Maritime-Robotics-Student-Society/sailing-robot/notes/node-overview.pdf

## rudder_pid

goal_heading[degrees]
heading
rudder_control[degrees]

## sail_lookup

wind_direction_localKS
[degrees]
PoS_control[degrees]

## Lowlevel Control

IN

## OUT

## Routing

## publish_wp sailing_behaviours

## Actuators

## sail_servo

PoS_control[degrees]
tack_sail[degrees]
sailing_state[string]

## rudder_servo

rudder_control[degrees]
tack_rudder[degrees]
sailing_state[string]

## Highlevel Control

## heading_control

position[latitude degrees,
longitude degrees]
next_wp[latitude degrees,
longitude degrees]
wind_direction[degrees]
heading[degrees]
goal_heading[degrees]
sailing_state[string]

## tack

sailing_state[string]
tack_sail[degrees]
tack_rudder[degrees]

## wind_estimates

## speed_estimate

## Sensor Analysis

## compass

heading[degrees]
magnetometer[string]

## Sensors

## gps

latitude
[degrees]
longitude
[degrees]

## wind

apparent wind
direction, local KS
[degrees]

## imu

accx,y,z
[float32]
gyrox,y,z
[float32]
magnetometer
[]

# High level

# Low level
