Maritime-Robotics-Student-Society/sailing-robot/notes/soton-sail-club-waypoints.png

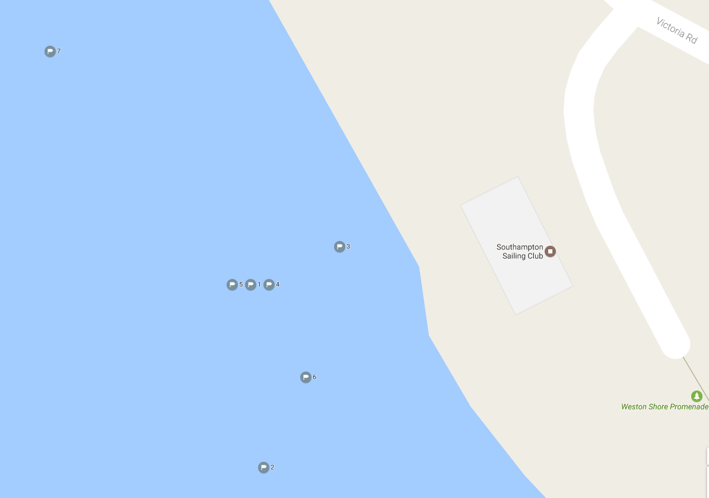
notes/soton-sail-club-waypoints.png
