Maritime-Robotics-Student-Society/sailing-robot/notes/ComponentList.md

#Sensors

| Name  |Model |  Document | Library  | Node  |
|---|---|---|---|---|
|  Accelerometer & Compass | LSM303D  | https://www.pololu.com/file/0J703/LSM303D.pdf  | https://github.com/pololu/lsm303-arduino  |Wind_direction Heading |
|  Gyro  |  L3GD20H |  https://www.pololu.com/file/0J731/L3GD20H.pdf | https://github.com/pololu/l3g-arduino  | Heading  |
|  GPS  | Ublox MAX M8Q | https://www.u-blox.com/sites/default/files/MAX-M8_DataSheet_(UBX-13004644).pdf | |

#Actuator
|  Name |Model |  Document  |  Library | Node  |
|---|---|---|---|---|
|  Rudder servo | TBC  |  | Arudino::Servo() |  Rudder control |
|  Sail servo  |  HiTec 785 HB | https://drive.google.com/file/d/0B0FZNysk4zLXREdoMUFxT0JMZkE/view  |  https://github.com/Maritime-Robotics-Student-Society/sailing-robot/blob/master/ArduinoCode/Rosserial/Rosserial.ino |  Sail control |
