Maritime-Robotics-Student-Society/sailing-robot/designs_3d/wind_vane.stl

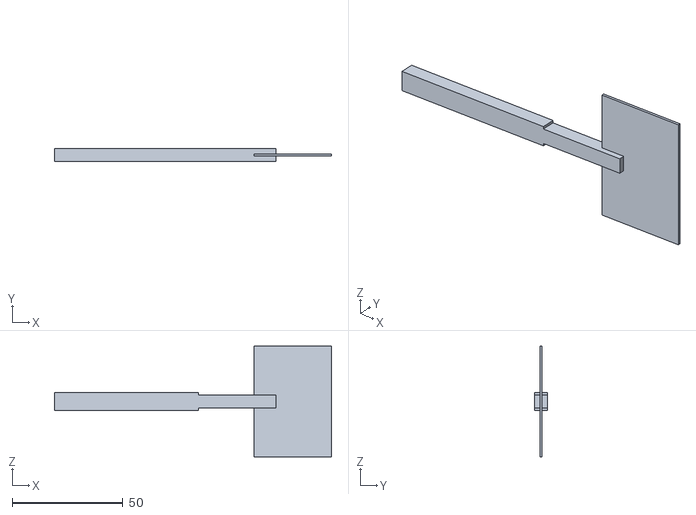
[picture p2: CAD file, 2017-07-18, last stored version]
designs_3d/wind_vane.stl
124.8 x 5.66 x 50.0
