Maritime-Robotics-Student-Society/sailing-robot/notes/roll_calibration/calibration_level.csv

mag_x | mag_y | mag_z | acc_x | acc_y | acc_z
-1168 | 2031 | 876 | 1440 | 629 | -14659
-1168 | 2031 | 876 | 1563 | 582 | -14637
-1163 | 2033 | 865 | 1409 | 617 | -14679
-1168 | 2037 | 871 | 1386 | 600 | -14799
-1168 | 2037 | 871 | 1427 | 665 | -14605
-1173 | 2035 | 874 | 1542 | 684 | -14583
-1174 | 2044 | 868 | 1374 | 505 | -14771
-1174 | 2044 | 868 | 1462 | 489 | -14630
-1172 | 2040 | 864 | 1533 | 401 | -14757
-1173 | 2048 | 857 | 1576 | 524 | -14353
-1173 | 2048 | 857 | 1342 | 706 | -14938
-1177 | 2054 | 863 | 1378 | 642 | -14411
-1177 | 2066 | 853 | 1418 | 596 | -14612
-1177 | 2066 | 853 | 1620 | 366 | -14543
-1152 | 2072 | 819 | 1681 | 309 | -14671
-1159 | 2053 | 848 | 1557 | 265 | -14727
-1159 | 2053 | 848 | 1200 | 478 | -14721
-1151 | 2048 | 869 | 1462 | 395 | -14806
-1146 | 2026 | 889 | 1398 | 703 | -14625
-1146 | 2026 | 889 | 1948 | 1111 | -14733
-1150 | 2003 | 901 | 1603 | 784 | -14633
-1144 | 2024 | 880 | 1433 | 622 | -14696
-1144 | 2024 | 880 | 1639 | 542 | -14731
-1143 | 2027 | 880 | 1602 | 593 | -14599
-1148 | 2019 | 889 | 1648 | 928 | -14686
-1148 | 2019 | 889 | 1262 | 840 | -14638
-1132 | 2037 | 874 | 1202 | 1012 | -14767
-1083 | 2015 | 871 | 1015 | 1408 | -14260
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
