Maritime-Robotics-Student-Society/sailing-robot/notes/roll_calibration/calibration_roll.csv

mag_x | mag_y | mag_z | acc_x | acc_y | acc_z
-1621 | 1022 | 1268 | 2066 | 6875 | -13281
-1621 | 1022 | 1268 | 1996 | 6899 | -13217
-1623 | 1048 | 1272 | 1912 | 6748 | -13086
-1604 | 1127 | 1257 | 2088 | 6105 | -13354
-1604 | 1127 | 1257 | 2017 | 5797 | -13446
-1602 | 1259 | 1225 | 1876 | 5155 | -14214
-1581 | 1424 | 1133 | 1935 | 4238 | -14237
-1581 | 1424 | 1133 | 1823 | 3657 | -14432
-1591 | 1587 | 1100 | 1988 | 2555 | -14423
-1585 | 1747 | 1001 | 1978 | 3119 | -14549
-1585 | 1747 | 1001 | 2193 | 1738 | -14653
-1581 | 1899 | 970 | 1840 | 3196 | -14645
-1568 | 2037 | 828 | 1099 | 1323 | -14615
-1568 | 2037 | 828 | 2433 | -2112 | -12258
-1563 | 2099 | 749 | 1647 | 493 | -16157
-1557 | 2135 | 765 | 1048 | -125 | -14625
-1557 | 2135 | 765 | 1551 | -830 | -14880
-1581 | 2189 | 727 | 1508 | -742 | -14400
-1589 | 2234 | 684 | 1313 | -1076 | -14632
-1589 | 2234 | 684 | 1655 | -1257 | -14434
-1588 | 2302 | 633 | 1819 | -1897 | -14936
-1598 | 2358 | 570 | 1686 | -2045 | -14505
-1598 | 2358 | 570 | 1504 | -2606 | -14302
-1626 | 2416 | 500 | 1370 | -2898 | -14532
-1640 | 2469 | 439 | 1508 | -2948 | -14263
-1640 | 2469 | 439 | 1315 | -3471 | -14361
-1655 | 2523 | 381 | 1279 | -3564 | -14308
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
