Maritime-Robotics-Student-Society/sailing-robot/notes/roll_calibration/successful compensation.png

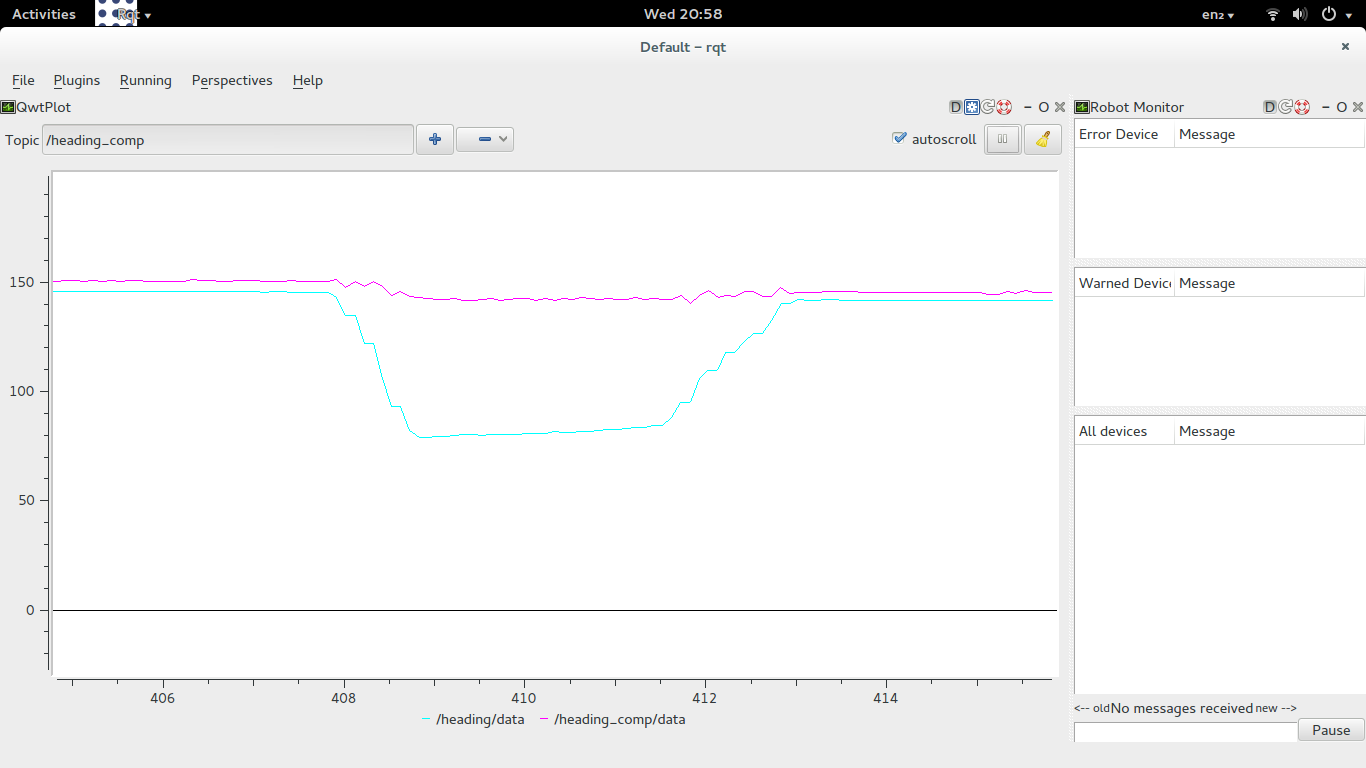
notes/roll_calibration/successful compensation.png
