Maritime-Robotics-Student-Society/sailing-robot/(threads)

Thread 6 (2016-01-29):

Cut foam for front of boat

smaria, 2016-01-29:
The foam needs to be cut so the second half of MacGuyver can be assembled.

Needs:
- Plan what shape it needs to be cut into
- Foam cutter (Sophia can get one)

smaria, 2016-03-23:
We are using the 1m hull and MacGyver is a table boat now, so this does not need doing

Closed 2016-03-23.

Thread 11 (2016-02-01):

Find waterproof connectors

smaria, 2016-02-01:
Make an overview:
- Where do we need them
- What options do we have
- Where can we get them

smaria, 2016-05-04:
This has been assigned on samepage

smaria, 2016-08-18:
Standard crimp connectors:
http://uk.farnell.com/jst-japan-solderless-terminals/08t-jwpf-vsle-d/connector-housing-tab-8pos/dp/2399257
 http://uk.farnell.com/jst-japan-solderless-terminals/04t-jwpf-vsle-s/connector-tab-housing-4-way-pbt/dp/3849855
and similar other pin combinations

solder pins:
http://uk.rs-online.com/web/p/industrial-automation-circular-connectors/4261209/
http://uk.rs-online.com/web/p/industrial-automation-circular-connectors/4260931/

The first were not available before WRSC, so we ordered the latter.

Closed 2016-08-18.

Thread 14 (2016-02-03):

Clearify what happens to goal_heading during/after tacking

smaria, 2016-02-03:
When highlevel_control switches to tacking, what will be published in the goal_heading topic? How is it ensured that after the tack, the right goal_heading is published?

UnnamedMoose, 2016-02-04:
Personally I see 3 ways of defining this:
1. Tell the boat to get to a fixed GPS heading estimated based on the current true wind speed, making sure the tack is executed by fixing the rudder at a certain angle for a given amount of time (probably worked out through trial and error)
2. Telling the boat to cross the wind direction and then keep falling off the wind until apparent wind angle becomes about optimum for accelerating to fixed speed again (about 30 degrees); then switching to gps tracking again
3. Somehow combining 1 and 2 via some decision making process to imitate what a real sailor would do (try to keep close to the course without sacrificing too much speed).

I attached a picture from our sailing simulator which shows some of the boat parameters we used to control a tack (beta is the apparent wind angle). We didn't have a controller though, were using prescribed inputs instead.

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

smaria, 2016-02-04:
The tack will be executed by a dedicated node ( #12 ). While the sailing state is 'tack_to_XXXX', messages from this node overwrite the sail and ruder PID. The goal_heading message is ignored during this phase, but becomes active as soon as the tack is over.

The goal of this ticket is to work out how the transition between normal sailing and tacking is done - how do we ensure a smooth transition from the tack to the normal heading control.

- How is it determined that a tack is finished (by the heading_control node? By the tack node?)
- What steps are needed to transition back smoothly?
- should the sheet be let out slowly before a tack is finished? This could use the messages that the PID control continues to send, and approach them within a few steps

Based on the notes above I would say the basic implementation should be:
The goal heading after the tack is determined in heading_control before the tack state is entered.
The tack is finished, when the goal heading after the tack is reached within an error margin.
The first published goal heading is the goal heading determined before the tack.

The tack node itself is not involved in determining if a tack is finished,

The next steps:
- Timeout of the tack (so we can't get stuck) #26
- Deal with wind changes #27

takluyver, 2016-02-17:
In the heading control code that I've written, it keeps the sailing state as 'tack_to_*_tack' until we reach the minimum angle we can sail towards the wind (which I'm calling the 'beating angle' in code). Throughout this time, the goal heading is set to that angle. Once we reach that angle, the state returns to 'normal', and the heading updates to drive us towards the waypoint (unless the waypoint is too close to the wind, in which case the heading stays at the beating angle).

Closed 2016-02-17.

Thread 15 (2016-02-03):

Write compass analysis node

smaria, 2016-02-03:
Write node that publishes heading angles based on the raw magnetometer readings
> how is this done so it is compatible with general magnetometers

tsaoyu, 2016-05-21:
Calibration code https://github.com/pololu/lsm303-arduino/tree/master/LSM303/examples/Calibrate
@NanaOKA Have done the raw data reading part with python

Closed 2016-05-21.

Thread 17 (2016-02-03):

Define calibration procedure

smaria, 2016-02-03:
Which parts need calibration when the boat is (re-) assembled?
Since we need to bring the boat to testplaces, we need a clear list what scripts we need to run e.g. to recalibrate the compass

tsaoyu, 2016-05-18:
Compass do need calibration but that is an one-off task at this moment.
@Nanoseb and I have found some calibration tool for the magnetometer.
We will work on the calibration part of sensor once we finished the wind vane assembly.

Closed 2016-06-29.

Thread 19 (2016-02-03):

Run tests from continuous integration

takluyver, 2016-02-03:
We have CI on Travis, but it currently just checks that everything builds. Add the ability to run tests which will be separately created.

smaria, 2016-02-04:
maybe we can use the outcomes of roswtf in this

takluyver, 2016-02-17:
We're now running nosetests on Travis. At some point we'll probably want to run tests with rostest as well, so leaving this open for now.

takluyver, 2016-03-23:
Now we have the framework in place for rostests as well, and the tests run on Travis.

Closed 2016-03-23.

Thread 21 (2016-02-03):

Write speed estimate node

smaria, 2016-02-03:
write node that estimates boat speed from IMU data

tsaoyu, 2017-05-01:
New [driver](https://github.com/tsaoyu/ublox) has been used to estimate speed from GPS.

tsaoyu, 2018-03-07:
When I was testing GPS velocity today, I found `gpsmon` is able to phrase u-blox message.
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

Nanoseb, 2018-03-07:
oh neat!

Thread 22 (2016-02-03):

Write wind_estimate node

smaria, 2016-02-03:
the wind direction needs to be estimated from the magnetometer under the wind vane.
Can further information about wind-speed be read in combination with other sensors?

UnnamedMoose, 2016-02-04:
The wind vane will read apparent wind speed, while for navigation/optimal course estimation true wind speed will be more useful; hence this wind_estimate will also need to know the boat heading and speed.

smaria, 2016-06-29:
There are a number of wind directions defined, and split into tickets:
- Average the sensor values directly, (topic [wind_direction_apparent](https://github.com/Maritime-Robotics-Student-Society/sailing-robot/wiki/Naming-conventions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)) : #70
- Get a longer term average wind direction, (topic [wind_direction_average](https://github.com/Maritime-Robotics-Student-Society/sailing-robot/wiki/Naming-conventions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)) # 74

Left for later, when a speed and wind speed estimate is available: wind_direction_real
(at this point the wind_direction_average should be switched to using the real wind speed)

smaria, 2016-08-18:
we now average our wind speed over two time periods;
there will be no wind speed sensor on the boat, but we might have speed information from land. This is for a later time though.

Closed 2018-09-01.

Thread 23 (2016-02-03):

Position estimate

smaria, 2016-02-03:
A position estimate needs to be generated from GPS and IMU
> does this use speed estimates from the (to be done) speed_estimate #21  node or does it use IMU values directly?
> there is a ros node for generating a position from GPS and IMU, which is it, is it suitable?

tsaoyu, 2016-06-29:
This problem is related to #86 #21.

smaria, 2016-08-22:
our gps is accurate enough at the top of the mast.

Closed 2016-08-22.

Thread 26 (2016-02-04):

Add a timeout to tack

smaria, 2016-02-04:
We need to make sure we can't get stuck in a tacking mode if something goes wrong. Therefore we need to add a condition that catches this and gets the boat back moving in case we get stuck in irons. Depends on #12 being completed

Nanoseb, 2017-11-07:
implemented with the jibe to tack, and the detection of a failed tack/jibe

Closed 2017-11-07.

Thread 31 (2016-02-17):

Handle running before the wind

takluyver, 2016-02-17:
The current code will aim the boat directly towards the waypoint unless that's too close to the wind for direct sailing. But if the wind shifts slightly across the heading to the waypoint - e.g. if we're heading due south, and the wind direction changes from 179 to 181, the code will currently decide that the angle change means we should switch tack, which could lead to a very wiggly course.

When our desired heading is close to 180 degrees from the wind, we need some special handling that allows us to go some way beyond 180 degrees on the same tack, to avoid unnecessary tacking. But we want to avoid unexpected jibing. Key factors are:

- The wind angle which will cause us to jibe
- Estimated variability in wind direction and our estimate of true wind direction

Nanoseb, 2016-09-03:
this is not done, but is not really needed, at least for WRSC2016 (because we can already jibe)

takluyver, 2016-09-03:
Actually, you sort of did this in e091a5b4e9ba3dcfe4feef3eaa01f9049a6586ab. The key point is that it won't try to tack if it has to turn from +170 to -170 degrees relative to the wind.

When I wrote the issue I thought we wanted to avoid jibing, but I now think that for our boat jibing doesn't really matter. So let's close this; we can create a more specific issue if there's still something we want to do.

Closed 2016-09-03.

Thread 33 (2016-03-02):

Finishing a tack

takluyver, 2016-03-02:
The current code, when it detects the tack is complete, immediately sets the sailing state to 'normal'. If we're tacking to change direction (rather than tacking upwind), it will therefore keep straight on turning to the desired heading. Sailing experts: is that a good idea, or do we want to put the rudder straight and accelerate for a bit before continuing the turn?

pierbiag, 2016-03-03:
I don't understand what you mean by "tacking to change direction". A tack strictly means changing the side the wind is coming from relative to the boat by going directly upwind and keeping turning (crossing the dead zone). If you mean tacking and than keep turning further than a normal tack, it's better to do the maneuver altogether: the most the relative wind angle approaches 90°, the faster the boat accelerates and goes (meaning there is no point in keeping the heading near the dead zone if not needed).

takluyver, 2016-03-03:
Thanks - I did mean tack and keep turning. So there's nothing to be fixed here.

Closed 2016-03-03.

Thread 34 (2016-03-02):

Figure out why servo sail node crashes when attempting to listening to its topics

smaria, 2016-03-02:
When the /servo topic is monitored in rqt, something crashes...

Closed 2016-07-13.

Thread 36 (2016-03-03):

Make raspberryPi interface that can be accessed over wifi

smaria, 2016-03-03:
It would be fancy if we could use a website (or maybe even something via ROS?) to control the sailing robot. That way we can control it via a tablet or from our own laptop.

bigboateng, 2016-03-03:
We can use firebase (https://www.firebase.com/) . It allows real time data streaming across platforms. So we can do real time on and android app as well as website. I've used it before in past projects. I can work on it once we high priority stuff out the way. Just need the python library for ros, javascript library for website and java library for app.

pierbiag, 2016-03-04:
Ideally we want something that doesn't have to connect to an external server (both for lag and foreseeable connection problems at sea). I think a simple html page hosted on the raspi (ideally configured to act as an access point) will be a good option.

bigboateng, 2016-03-04:
I guess so, but Firebase is really fast though.
 if you host web page on pi, then on the sea how would you connect to it if its wifi/the wifi its connected to is not in range?

pierbiag, 2016-03-04:
The normal commands are given through the low frequency radio modules, but when within range, the raspy itself becomes an access point for the other devices. (No need for Internet)

bigboateng, 2016-03-04:
I get you

NanaOKA, 2016-03-14:
Established connection via ssh using an access point on the Raspberry Pi. This will allow us to possible control the robot wirelessly using a ROS network consisting of the Raspberry Pi and a laptop

tsaoyu, 2016-06-04:
We are currently using AP mode for remote control of our sailing robot.

Closed 2016-06-04.

Thread 37 (2016-03-05):

Get i2c and gpio work with ROS indigo on raspberry pi

smaria, 2016-03-05:
At the moment most of our sensors are attached via arduino. In the long term, with more and more sensors, it would be cleaner to move as much as possible from the arduinos to the raspberry pi.

We can either have ubuntu and trouble with getting GPIO running, or raspian and troubles with getting an up to date version of ROS.

NanaOKA, 2016-03-14:
Got the IMU working via i2c with Raspbian Jessie on the Raspberry Pi

Closed 2016-03-14.

Thread 38 (2016-03-05):

Try out odroid

smaria, 2016-03-05:
Odroid might be a better option than raspberry pi in the long run, since it seems to already support combining ubuntu and python GPIO libraries. This needs verifying.

NanaOKA, 2016-03-14:
We decided not to pursue this based on popularity of the Raspberry Pi and the Raspbian OS along with the interrupts on the Odroid GPIO pins not working too well

Closed 2016-03-14.

Thread 39 (2016-03-05):

Make considerations for the future of the computation board

smaria, 2016-03-05:
With each board option, there are positives and negatives. We need to figure out what is important to us, and which board is thus the best option for us.

Needs:
- ROS
- python GPIO library

Other Considerations:
- Cost
- popularity
- available documentation

Options:
- BBB
- raspberryPi
- Odroid

Tickets looking at details on this:
#38
#37

NanaOKA, 2016-03-14:
Discussed in our last meeting (9th March 2016) and decided to go with the Raspberry Pi with either Ubuntu or Raspbian based on cost, popularity, ROS, Wifi, and i2c

Closed 2016-03-14.

Thread 45 (2016-04-30):

get new arduino ide

smaria, 2016-04-30:
because I can't program the arduino for the wind speed sensor otherwise

smaria, 2016-06-25:
finally done that.

Closed 2016-06-25.

Thread 55 (2016-05-04):

Failure handling: wet electronics

smaria, 2016-05-04:
We need sensors, detection and reaction to electronics being wet

Nanoseb, 2018-01-23:
Having 2 naked wires at the bottom of the boat with the proper distance between them is probably enough to detect a leak of salty water.

Thread 57 (2016-05-04):

Failure handling: avoid rounding the waypoint from the wrong side

smaria, 2016-05-04:
Because that would mean we have to go again - and we won't even be able to detect this.
See also: #53, #51

takluyver, 2016-09-02:
From the rules:

> A mark/buoy is considered reached if at least  one track point is recorded within a radius of 5m around the position of the (virtual) buoy.

So we don't have to round buoys like in traditional sailing.

Closed 2016-09-02.

Thread 60 (2016-05-21):

Tuning of lower level controller

tsaoyu, 2016-05-21:
At this moment, we are using a simple PID controller for rudder control. We need to define the procedure to tune three control parameters. Can we use a set of parameter files in a single test, or should we change control parameter during each test?

smaria, 2016-06-04:
Unless we make major changes to the vessel, we can keep the parameters from one test.

smaria, 2016-08-21:
The parameters were set for the laser, but afaik we have not reviewed them for the black pythong

Thread 61 (2016-06-04):

Add wifi setup to launch script on RPi

smaria, 2016-06-04:
This way we don't have to be connected to the Raspi via wired connection after reboot. This involves:
- updating the launch script
- updating the image available

smaria, 2016-06-04:
instead of updating the image we should update the image setup instruction

tsaoyu, 2016-06-04:
Currently, the WiFi connection is depends on the model of our WiFi dongle. I couldn't figure out a uniform way to update method for potential different adapters.
But, WiFi AP setting would be documented in the online WiKi.

Nanoseb, 2016-06-04:
we can write a script to detect le dongle (by parsing the output of `lsusb` it is probably quite straight forward)

tsaoyu, 2016-06-04:
The problem is related to the drivers issue.
In order to use a specific type of dongle, we need use different version of `hostapd`.
With different model of dongle, we need to remove and recompile a specific version of `hostapd` which makes thing complicated.
I am willing to try if it possible to use `lsusb` to automatic detect and setup of AP.

tsaoyu, 2016-06-04:
https://github.com/theOtherLuke/rpi-access-point/blob/master/jenssegers_rtl8188_hostapd_install.sh

Nanoseb, 2016-06-04:
Ok, so instead of compiling every times, you can just uninstall the previous one and run make install. The run at boot part of this script will not work since we are using Jessie (systemd).

tsaoyu, 2016-06-04:
My idea was shrink the image we used today as the "base" image and forget about the WiFi setting. Even we use `lsusb` to identify the model we are using, we couldn't quickly find the corresponding custom-made `hostapd` and drivers. This means, we will always keep using a single model of WiFi dongle until there is huge modification on our current way of wireless communication.
So I would like to shrink our image a little bit and use today's image as the base image as the back up.

NanaOKA, 2016-06-06:
Added bash script fro setting up wireless access point for this dongle http://www.modmypi.com/raspberry-pi/accessories/wifi-dongles/wifi-dongle-nano-usb

tsaoyu, 2016-06-06:
Drivers on current RPi is `rt1871xdrv`, I think this script can only make that type of dongle works.

`pi@raspberrypi:~/sailing-robot $ vi /etc/hostapd/hostapd.conf `

```
# Basic configuration

interface=wlan0
ssid=Sail_robot
channel=1
#bridge=br0

# WPA and WPA2 configuration

macaddr_acl=0
auth_algs=1
ignore_broadcast_ssid=0
wpa=3
wpa_passphrase=sailrobot
wpa_key_mgmt=WPA-PSK
wpa_pairwise=TKIP
rsn_pairwise=CCMP

# Hardware configuration

driver=rtl871xdrv
ieee80211n=1
hw_mode=g
device_name=RTL8192CU
manufacturer=Realtek

```

NanaOKA, 2016-06-06:
Makes sense to use only one type of dongle as I don't think any spares we get will be off a different type.

tsaoyu, 2016-06-06:
The thing is I used to think we couldn't make our dongle (Edimax) works until I try that with the custom made drivers. So let's stick with our plan, and use the dongle you posted here as the only type of WiFi adapter for our project.
And I will use @Nanoseb 's 8GB image as our base image for the backup purpose.

That image will be named with date and Raspbian version. All the setup script will be moved to `utilities` folder. Once we recovery the image, we should also run all the scripts created(modified) later than the image size.

In this way, we don't need to worry to much about our base image. And I'll upload that image to the `sailrobot` google drive.

Closed 2016-06-06.

Thread 62 (2016-06-05):

Add compass calibration script to repo

takluyver, 2016-06-05:
@Nanoseb wrote a compass calibration script in the home directory of the raspi we were using yesterday. That needs to be added to git.

tsaoyu, 2016-06-06:
Calibration code is now under `utilities` folder. Not sure if we need run this every time, so I didn't put it into our `src` folder.

Nanoseb, 2016-06-06:
It needs to be run every time a hardware part moves.

takluyver, 2016-06-06:
It's separate from the ROS stuff, so it makes sense to have it in a separate directory. But so long as it's in the repo and we can find it when we need it, it doesn't really matter where it goes.

Closed 2016-06-06.

Thread 63 (2016-06-05):

Work out what's wrong with heading/tacking calculation

takluyver, 2016-06-05:
Yesterday's test ended with us going round and round in circles a lot. This might be great for the virtual anchoring task, but we were trying to sail to a waypoint. Something seems to be up with the heading or tacking calculations.

smaria, 2016-06-23:
This was investigated further at the last dry land test, as far as I recall we narrowed it down to the wind direction needing averaging ( #70 ) and the compass having an offset/sign error (# ???)

takluyver, 2016-06-23:
Sign or offset issue is/was #71.

takluyver, 2016-06-27:
I've rewritten the heading control (which decides when to tack) to hopefully address the overenthusiastic tacking we were still seeing.

The new logic calculates at each time step if the other tack would take us closer to the waypoint. But it doesn't then use that directly, but instead adds it to a running poll. It tacks when the poll reaches 75% of samples wanting to tack over the last 10 seconds (these values can be made configurable if this mechanism works). This should mean:

- No tack for at least 7.5 seconds after finishing a tack - but unlikely my quick and dirty solution on Saturday, the rudder PID will get a chance to steer the boat.
- Better coping with fluctuating wind by preferring the tack we're currently on.

For now, I've simplified it by cutting out any calculation of lay lines, relying on the delay this provides to keep us from constantly tacking. I suspect we'll probably need to add a bit more complexity, but that was in need of a rewrite from our 'tack lines' idea anyway (#58), so I'll work out how best to do it once we've seen how the boat behaves with this code.

Nanoseb, 2016-06-27:
This seems a really good idea. nice!

takluyver, 2016-07-20:
Navigation was basically successful on Sunday, though there's still some optimisation to do.

Closed 2016-07-20.

Thread 64 (2016-06-05):

Record GPS position to file

takluyver, 2016-06-05:
The competition rules require us to provide logged GPS data in one of two specific formats.

takluyver, 2016-06-25:
[Preliminary rules](https://web.fe.up.pt/~jca/wrsc2016.com/docs/WRSC_rules_2016_V1.0.pdf)

> The competing boats should be able to provide to the organization, at the end of each day,
the basic tracking data recorded from their own global navigation satellite system (e.g. GPS).
This should include a timestamp and lat/lon data with not less than one track point per
second. This data must be provided to the organization in one of the following formats:
- A CSV (comma-separated values) text file with three decimal integer numbers per line
representing “hhmmssdd
Lat*10 7
Lon*10 7 ”. For example, the entry
“14233407,
416887091,
-88259850”
means 14h23m34s of day 7 of
September, lat=41.6887091o (north) and lon = -8.8259850o (west) ); 9h of recording
will need approximately 1MByte of data.
- A binary file with 12-byte records representing the three 32-bit signed integers above
(two’s complement) in little-endian or big-endian byte order. This format will require
approximately 388 KByte of data for 9h.

takluyver, 2016-06-25:
Rough code in place,  but it relies on the raspi's own clock, which is reset each time we power it on. We should use the GPS time for the timestamps.

Closed 2016-07-30.

Thread 66 (2016-06-05):

Make connecting to ROS on the RPi easier

smaria, 2016-06-05:
- Add all our laptops to the RPi configuration
- enable all our laptops to be part of ROS running on the RPi

Basically, this needs to be implemented to work permanently rather than re-done every time we need it:
http://wiki.ros.org/ROS/NetworkSetup

smaria, 2016-06-05:
Btw, this will also allow us to use things like rqt console, which can print error messages, debug messages and warnings of select nodes etc. http://wiki.ros.org/rospy/Overview/Logging

Thread 70 (2016-06-15):

Averaging wind direction from wind sensor

tsaoyu, 2016-06-15:
The fluctuating nature of wind makes it hard to tack nicely.
Short term averaging can me done to tackle this issue.

#22

Closed 2016-06-22.

Thread 71 (2016-06-15):

Investigate the sign error/offset

tsaoyu, 2016-06-15:
* Investigate the sign error on rudder command and wind direction
* Investigate the offset issue on wind direction

Nanoseb, 2016-06-15:
For the offset value on the wind direction, I think it is better to handle it in the calibration script because depending on magnets directions it will add/subtract 180 degree. I'll add that.

tsaoyu, 2016-06-16:
Now the sign issue have been resolved.
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
Need hardware test to figure out an suitable PID value.

Nanoseb, 2016-06-16:
If everything is in degree and we are using only P, I think a P of 1 is a good start. The final value will probably be lower than that.

smaria, 2016-06-22:
please include all things decided/noted here in the wiki, since that is where we will check later!

tsaoyu, 2016-06-22:
Anti-windup have been implemented in `pid_rudder` node.

Closed 2016-06-22.

Thread 75 (2016-06-22):

Investigate the discontinuity of power bank supply

tsaoyu, 2016-06-22:
We find that our power bank stop to supply power when the current is low. This will cause servos lose power after a while. Solution can be:

* Use AA batteries
* Maintain the lower power supply level with resistor

This problem should be fixed before this Saturday (25/06).

smaria, 2016-06-23:
Can you describe that in a bit more detail? The power bank still supplies the Raspberry Pi, but the servos don't get powered?

tsaoyu, 2016-06-23:
We use two power bank to power RPi and servos separately.
Once the current supply from power bank is low, the control circuit inside power bank will cut off power supply.
When servos idle, they draw so little energy from power bank that switch off the power bank.

smaria, 2016-06-23:
It should be fine to run the servos and the RPi off the same supply - originally there was some concern that the servos might draw much higher currents than the RPi, leading to sudden voltage drops, but it seems to me the maximum output current of the power supply is large enough. Based on the last lake test, the power consumption of the servos is insignificant compared to the continuous current draw of the RPi.

smaria, 2016-06-24:
Ok, today taught us better: Running the servos can make the RPi reboot. For now we are using AA batteries.

tsaoyu, 2016-06-28:
Conclusion is power supply separation is necessary. And I am going to order another 16 AA batteries.

Closed 2016-06-28.

Thread 77 (2016-06-23):

Permission Issue on RPi native servo control node

tsaoyu, 2016-06-23:
@Nanoseb @pierbiag and I made a simple servo control node use native PWM control on RPi.
This hardware PWM control works pretty well even when computational load is high on the pi.
The only draw back of my current version of driver requires `sudo` right, and it mess up with `rospy` because the `PATH` of `root` is different from our current user `pi`.

Before I figure out this permission issue, we'll still use Arduino for servo control.

Nanoseb, 2016-06-23:
https://raspberrypi.stackexchange.com/questions/40105/access-gpio-pins-without-root-no-access-to-dev-mem-try-running-as-root/46235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 I think it is the cleanest way we can achieve that.

TL;DR give read/write access to the group gpio to /dev/mem to control gpio pins without root access

tsaoyu, 2016-06-23:
Another issue the bad control quality using `wiringPi`
Suppose we are using 50 Hz PWM to control the servo, useful duty cycle is between 5-10% percent (1ms~2ms correspondingly). And the `wiringPi.pwmWrite(int dutycycle)` is 0-1024, so we only have 5% of them (50 steps) for 180 degrees range. That is quite bad performance according to my test.
When I increase the PWM frequency to 100 Hz, Futaba servo stop responding. I am not sure if this servo only support 50 Hz.
I will test the rudder servo on the laser to see if it possible to improve the performance.

For the permission issue, I think it is similar to serial problem
```
pi@raspberrypi:~/Desktop $ groups pi | grep gpio
pi : pi adm tty dialout cdrom sudo audio video plugdev games users input netdev spi i2c gpio
```

I will look at this issue later.
Cheers

Nanoseb, 2016-06-24:
the rpio library checks if it is run as root but not if actually /dev/mem has the right permissions. I think we can fork it to skip this check and it will probably work fine

Nanoseb, 2016-06-24:
we can try with this: https://github.com/Nanoseb/RPIO

tsaoyu, 2016-06-28:
This piece of code suppressed the notification of permission issue. But servo stop responding because `/dev/mem` still not accessible by the code.

Nanoseb, 2016-06-28:
but have you changed the permissions on this device ? (it might be needed at every boot )`sudo chmod 666 /dev/mem` (or you can add the proper user to the group and do a 660)

tsaoyu, 2016-06-28:
Yes, I have done that once. But I think seems not a good idea to open our physical memory  permission `/dev/mem` to users.

Nanoseb, 2016-06-28:
you can achive the same thing by just adding the gpio user as an owner of the device (as explain in the stackexchange post)

tsaoyu, 2016-06-28:
Will check that tonight.

BTW backup RPi is running and accessible on `10.15.36.116 `(intarnet).

tsaoyu, 2016-06-28:
This is my attempt:
```
pi@raspberrypi:~/pigpio-master $ sudo chown root.gpio /dev/mem && sudo chmod 666 /dev/mem
pi@raspberrypi:~/pigpio-master $ rpio
Traceback (most recent call last):
  File "/usr/local/bin/rpio", line 4, in <module>
    __import__('pkg_resources').run_script('RPIO==0.10.1', 'rpio')
  File "/usr/lib/python2.7/dist-packages/pkg_resources.py", line 534, in run_script
    self.require(requires)[0].run_script(script_name, ns)
  File "/usr/lib/python2.7/dist-packages/pkg_resources.py", line 1445, in run_script
    exec(script_code, namespace, namespace)
  File "/usr/local/lib/python2.7/dist-packages/RPIO-0.10.1-py2.7-linux-armv7l.egg/EGG-INFO/scripts/rpio", line 353, in <module>

  File "/usr/local/lib/python2.7/dist-packages/RPIO-0.10.1-py2.7-linux-armv7l.egg/EGG-INFO/scripts/rpio", line 147, in main

  File "build/bdist.linux-armv7l/egg/RPIO/__init__.py", line 115, in <module>
  File "build/bdist.linux-armv7l/egg/RPIO/_GPIO.py", line 7, in <module>
  File "build/bdist.linux-armv7l/egg/RPIO/_GPIO.py", line 6, in __bootstrap__
RuntimeError: No access to /dev/mem. Try running as root!
pi@raspberrypi:~/pigpio-master $ ls -al /dev/mem
crw-rw-rw- 1 root gpio 1, 1 Jun 28 20:45 /dev/mem
pi@raspberrypi:~/pigpio-master $ groups pi | grep gpio
pi : pi adm tty dialout cdrom sudo audio video plugdev games users input netdev spi i2c gpio

```
I do think expose `/dev/mem` is not a clean solution.

The next library I want to try is `pigpio` http://abyz.co.uk/rpi/pigpio/index.html

Nanoseb, 2016-06-28:
I think the problem will be the same with every library, to set gpio some rights are needed no mater what is the implementation.

takluyver, 2016-06-28:
Other people must have run into this, surely? Is there any info on what people do to use gpio?

tsaoyu, 2016-06-28:
Yes, I agree with you that GPIO operation do need right permission. But it is also depends on the implementation of the library. I can understand and give permission to `gpio` memory like this
```
pi@raspberrypi:~ $ ls -al /dev/gpiomem
crw-rw---- 1 root gpio 244, 0 Jun 28 22:47 /dev/gpiomem
```
But fully opened permission `/dev/mem` will cause some unexpected issue.

For now, I have test the `pigpio` library. The implementation is much more clear and securer than `RPIO`.
Basically the idea is let `pigpiod` running as daemon on `localhost(8888)` with `sudo` rights. And every GPIO command (e.g. hardware PWM) go through this service.

takluyver, 2016-06-28:
If the best answer is that something needs to be run as root, then I agree that that should be a simple service which acts on behalf of the programs that need to do things.

tsaoyu, 2016-06-28:
For Thomas' question: Other people do run into this problem, but occasionally, they also using ROS at the same time. They don't have `PATH` issue when blindly running scripts as `root`.

GPIO memory can be accessed by `gpio` groups. So usually software GPIO wouldn't is fine without `sudo`. But in our case we need high quality hardware PWM wave to control our servos, those conventional library is no longer able to meet our requirements.

tsaoyu, 2016-06-29:
This problem is solved with `pigpio` library and new `servo_control` node.

Closed 2016-06-29.

Thread 79 (2016-06-24):

Think through multiplexer reaction to signal loss

smaria, 2016-06-24:
ATM when out of range: motors go to zero position.

When the remote control is switched off or out of range, what do we want the ship to do, and how do we achieve it?

Probably: use RPi; to achieve this: remove jumper
Advanced: RPi recognises if we are not connected and returns home.

smaria, 2016-06-29:
> If the jumper is left off, the master inputs will be in control. If the jumper is connected, the output channels go low and stay low for as long as the signal on the SEL channel remains invalid.

So: we should switch the Inputs from the RC and the RPi/Arduino around, using the RPi on the M side;
we should leave the jumper off.
(from: https://www.pololu.com/product/2806 )

Closed 2016-06-29.

Thread 81 (2016-06-25):

test that we can use RPi without internet

smaria, 2016-06-25:
we should test what changes need to be made if we switch from using git on the RPi to copying over code from our machines in a separate folder

takluyver, 2016-06-25:
It is possible, with a bit of config, to push code with git directly from our computers, without needing an internet connection. This might be preferable if it involves changing less than pushing code to a separate folder.

takluyver, 2016-06-25:
Places where we've hardcoded a path to the `~/sailing-robot` folder:

- Sourcing setup.bash in `~/.bashrc`
- In `dashboard` node for static file `index.html`
- In at least one launch file, for the directory where `rosbag` is to record.

Suggestion: rather than rewriting the paths in several different locations, we should make `~/sailing-robot` a symlink that can we can switch between `sailing-robot-git` and `sailing-robot-nogit`.

takluyver, 2016-07-03:
I have git configured so I can push directly to the raspi. The config in `.git/config` looks like this:

```
[remote "raspi1"]
    url = pi@sailbot:sailing-robot-bare
    fetch = +refs/heads/*:refs/remotes/raspi1/*
```

* On the working computer, push with `git push raspi1`.
* On the raspi, then `git pull bareclone`

(This requires two steps, because pushing to a normal git repo with a working directory fails if it would update the current branch. Therefore we have a bare clone on the raspi at `~/sailing-robot-bare`, which we push to and then pull from)

takluyver, 2016-07-18:
I've documented the steps to set up git for this:

https://github.com/Maritime-Robotics-Student-Society/sailing-robot/wiki/Git-push-directly-to-the-raspi

Closed 2016-07-18.

Thread 85 (2016-06-26):

Ensure there is enough free space on SD card for rosbag

takluyver, 2016-06-26:
We were getting messages yesterday that rosbag wasn't recording because it detected that there was <1G of free space left. We need to ensure that the recording is actually able to record, and that we don't run out of space.

If we're using SD cards larger than the image, one possibility is to make another partition on the card in the remaining space, and tell rosbag to write files there.

Nanoseb, 2016-06-26:
The SD card is 32G right now, we can even expand the file system instead of making a new partition.

takluyver, 2016-06-26:
My idea to make a separate partition was in case we need to copy the image from the raspi again - though I think we should aim to avoid copying lots of images, it's a useful possibility to have. If it's a second partition, I assume we can just copy the first partition off.

Nanoseb, 2016-06-26:
We have found a way to shrink an image to its 'useful' content, and we already have a 7G image (on the google drive), so we can expand this one and if we want to make a other sd card we just have to get the 7G one and run the scripts from the utility folder to have it at the same state as the one we already have.
But yes a new partition is also not hard to handle (just make sure it is mounted on boot.

takluyver, 2016-06-26:
That's good to know. Presumably it still takes longer to make a 32GB image from the card than it does an 8GB image, though.

tsaoyu, 2016-06-28:
We can expand the file system. There is 8 GB card with last copied image and 32 GB empty card for back up. I'll update that 8 GB card every Wednesday.

tsaoyu, 2016-07-01:
File system now expanded.

```
pi@raspberrypi:~/sailing-robot $ df -h
Filesystem      Size  Used Avail Use% Mounted on
/dev/root        30G  6.0G   22G  22% /
devtmpfs        459M     0  459M   0% /dev
tmpfs           463M     0  463M   0% /dev/shm
tmpfs           463M  6.3M  457M   2% /run
tmpfs           5.0M  4.0K  5.0M   1% /run/lock
tmpfs           463M     0  463M   0% /sys/fs/cgroup
/dev/mmcblk0p1   63M   21M   43M  33% /boot
tmpfs            93M     0   93M   0% /run/user/1000
```

Closed 2016-07-01.

Thread 86 (2016-06-26):

Work out why GPS is unstable

takluyver, 2016-06-26:
Our GPS position was fluctuating by tens of metres yesterday. We need a fix accurate to within a few metres.

We thought that putting an antenna outside the boat casing might help.

Nanoseb, 2016-06-28:
Because we have an imu, we can use a kalman filter (https://en.wikipedia.org/wiki/Kalman_filter) to have more accuracy on the gps. The math behind it is probably quite complex, but there is probably some nice python libraries to do that

Nanoseb, 2016-06-28:
do we have any indication on the signal quality of the gps? (number of satellite for example), with that we can see where is the best place for it.

tsaoyu, 2016-06-28:
ROS package `robot localization` can do this job nicely. One thing we need for the Kalman filter is an approximate linear model of our boat.
http://wiki.ros.org/robot_localization

I am not sure if we are currently recording the number of GPS satellite or not. But I suppose it would be hard to get that data using `cgps`.

takluyver, 2016-06-28:
The data we get in the GPS node does include the number of satellites it's tracking, but we don't currently pass it on through ROS (and annoyingly, there doesn't appear to be a field for it in the NavSatFix message).

However, let's test it with a GPS antenna outside the boat before we try combining data from multiple sensors. The extra complexity will give us more things to debug, and if the crucial input is dodgy, the output probably won't be that great.

tsaoyu, 2016-06-28:
Yes, we may go for "physical" solution first and then try smart EKF (or UKF) approaches.

We also have ultimate backup plan https://emlid.com/shop/reach-rtk-kit/

tsaoyu, 2016-07-06:
So sad R.E. Kalman passed away several days ago. http://hungarytoday.hu/news/renowned-hungarian-scientis-rudolf-kalman-dies-aged-86-46732
R.I.P.

smaria, 2016-08-18:
GPS antenna is now outside of boat, waterproofed. At least for now this is a good enough solution.

smaria, 2016-09-24:
Don't think this is a problem these days.

Closed 2016-09-24.

Thread 87 (2016-06-29):

add LEDs

smaria, 2016-06-29:
leds would be really useful for debugging, so let's add some. (yes, ros is nice, but this way all can see :)
What we want to use them for:
- indication if it is the right wifi we are connected to
- GPS fix
- reached waypoint
- tacking

smaria, 2016-06-29:
We already have a 1m stripe of LEDs that is waterproof with the lady ada individually addressable LEDs. Lets use that :)

Closed 2016-07-13.

Thread 90 (2016-07-03):

create simulation

smaria, 2016-07-03:
just for documentation that Nanoseb is working on this, replacing sensors and actuators with simulated nodes

takluyver, 2016-07-03:
:+1:

Nanoseb, 2016-07-08:
Work in progress ;) see branch simulator

Nanoseb, 2016-07-09:
We now have a working simulator, it manages to go from waypoint to waypoint.
And I think I spotted 2 issues in our code, see #99 and #98 .
If you want to play with it you can use the launch file called `simulator.launch`.

takluyver, 2016-07-09:
Awesome, thank you! I will play around with this soon.

Closed 2016-07-13.

Thread 91 (2016-07-04):

Wi-fi signal issues

takluyver, 2016-07-04:
We were getting very spotty wifi connections to the boat during yesterday's lake test.

We think this might have been because the wifi antenna in the boat was too low down; we should investigate putting it on top of the boat.

smaria, 2016-07-06:
Let's for now keep using the current adapter (since there is limited compatibility with the RPi), and use this to put it on top of the mast:
https://www.amazon.co.uk/AmazonBasics--Male--Female-Extension-Cable/dp/B00NH136GE
@NanaOKA do you know of another wifi adapter that might have a better range at the top of your head?

tsaoyu, 2016-07-06:
I am not sure this is related to WiFi power management system on RPi.
We can try http://www.modmypi.com/blog/disable-wifi-power-management

tsaoyu, 2016-07-06:
If power isn't the issue, I would try http://www.modmypi.com/raspberry-pi/accessories/wifi-dongles/wifi-dongle-ultra-long-range-high-gain-w-5dbi-antenna/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

smaria, 2016-07-06:
My impression was that it is mainly an issue with the antenna being underwater. The current antenna would definitely be lighter on the mast. Then again, maybe worth buying in case the small antenna doesn't work even on top of the mast.

tsaoyu, 2016-07-13:
Our RPi is now equipped with high gain antenna and USB extension cable.

Closed 2016-07-13.

Thread 92 (2016-07-04):

Compass wrong when boat heals

takluyver, 2016-07-04:
Tilting the boat affects the reported heading significantly. We need to take the third dimension into account when calculating the heading from the magnetic field readings.

smaria, 2016-08-20:
Has the fix for this been sufficiently tested?

takluyver, 2016-08-20:
Not really, but we have a fix for it in principle. So I'm inclined to close this, and open new issues if our fix doesn't work properly.

Closed 2016-08-20.

Thread 93 (2016-07-07):

rename nodes consistently

smaria, 2016-07-07:
our node naming needs some consistency!
We will start using prefixes:

- debugging_
- dummy_
- simulation_
- sensor_
- actuator_

Nanoseb, 2016-07-07:
I would say:
```
blink_on_sailing_state -> debugging_blink_sailing_state
dashboard -> debugging_dashboard
gps -> sensor_gps
gps_log -> debugging_gps_log
imu-calibrated -> sensor_imu
pid_rudder -> actuator_rudder
pid_sail -> actuator_sail
publish_apparent_wind_direction -> dummy_wind_direction_apparent
publish_heading -> dummy_heading
publish_position -> dummy_position
servo_control -> actuator_servo_control
tack -> hilevel_tack
tasks -> hilevel_tasks
wind_direction_average -> hilevel_wind_direction_average
wind_direction_calibrated -> sensor_wind_direction
```
I added hilevel to the prefixes.

smaria, 2016-07-07:
we have a couple of 'archive' launch files, I am currently not planning to migrate them to the new names.

smaria, 2016-07-07:
also, do we want to change the names of the nodes that are launched in the scripts as well? they are often a bit different from the names of the scripts.

smaria, 2016-07-07:
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

I don't really see much connecting those three nodes, besides them all not being in any of the other categories, so for now I would not put them together (but maybe choose a longer, more descriptive name for them)

Nanoseb, 2016-07-08:
I think it is better to have node names = script names, I don't see any reason not to do that.

For the `hilevel` prefix, maybe we can change that to `other`, and use a more descriptive name. But having a prefix for all of them is probably a good thing.

smaria, 2016-07-08:
I can agree on putting tack and tasks in one bucket, but the wind sensor analysis imho doesn't fit. If it has to be grouped I'd put it in with sensors.

I also added sub-groups for the actuators: actuator_demand and actuator_driver

smaria, 2016-07-10:
> they publish values which the real actuator node controls. I would reserve the name actuator_ for the node(s) that interface with the actuators, and call these...I don't know, 'processing_'?

> Likewise, I think we should reserve sensor_ for nodes that read data directly from sensors. I'd call this one something like processing_smoothed_wind_direction.

Trying to understand this as an alternative to the current naming: This proposes to split into actuators, sensors, processing, debugging, dummy, and simulation.

issues I have with this:
- I find 'processing' not descriptive
- I don't see a clear connection between smoothing the wind direction and generating an actuator demand, they seem more thrown together because they are left

takluyver, 2016-07-10:
I agree that 'processing' is not very descriptive, and it is certainly something of a 'misc' category. What they have in common is that they subscribe to ROS topics, process data, and publish to other ROS topics. This overlaps with 'hilevel', and in a larger system, presumably there would be many nodes like this.

I don't have a way I'm really happy with to categorise these. But among the nodes that run when we're actually controlling a boat, the only clear distinction I see is between nodes that talk to hardware and nodes that don't. That's meaningful because nodes that don't talk to hardware can be tested in a simulation. So I'd rather preserve that distinction, even at the cost of creating an 'everything else' category, rather than trying to push the leftovers into 'sensors' and 'actuators'.

smaria, 2016-07-10:
The flexibility between hardware and simulation is a good point. Would it be satisfactory for you to have sensor_driver and actuator_driver as prefixes for the parts that are replaced?
I am quite attached to splitting the lowlevel analysis and control parts into sensor and actuator related bits, since I find it makes the structure of the firmware understandable.

Otherwise I would probably not even call them sensor or actuator, maybe 'actor', 'physical', or 'hardware', and then split the rest in 'analysis', 'control' and 'plan'

takluyver, 2016-07-10:
Go with what makes sense to you; so long as it doesn't keep changing, I'll work out what the names mean and work with it.

smaria, 2016-07-10:
I am going with the sensor/actuator naming scheme. Reason: sensor_imu doesn't actually publish imu data, it publishes already processed heading data, making it difficult to classify under the other scheme. Whilst this may need splitting some point, I am not going to split it before implementing the re-naming.

I will name it sensor_driver_imu to mark it as a node that contains a driver.

Closed 2016-07-13.

Thread 95 (2016-07-09):

Navigation class, error with utm_to_latlon function

Nanoseb, 2016-07-09:
For the simulator I need the utm_to_latlon function but I have some errors with it:
the first one:
```
Traceback (most recent call last):
  File "/home/seb/sailing-robot/src/sailing_robot/scripts/simulation_position", line 69, in <module>
    Position_simu()
  File "/home/seb/sailing-robot/src/sailing_robot/scripts/simulation_position", line 39, in __init__
    self.position_publisher()
  File "/home/seb/sailing-robot/src/sailing_robot/scripts/simulation_position", line 60, in position_publisher
    position = self.nav.utm_to_latlon(self.utm_position[0], self.utm_position[1])
  File "/home/seb/sailing-robot/src/sailing_robot/src/sailing_robot/navigation.py", line 39, in utm_to_latlon
    lon, lat = self.projection.inverse(x, y, inverse=True)
AttributeError: 'Proj' object has no attribute 'inverse'
```
can be fixed by removing '.inverse' l39 (there is no mention of this method in the documentation: https://jswhit.github.io/pyproj/pyproj.Proj-class.html)

Then I have the following error
```
Traceback (most recent call last):
  File "/home/seb/sailing-robot/src/sailing_robot/scripts/simulation_position", line 69, in <module>
    Position_simu()
  File "/home/seb/sailing-robot/src/sailing_robot/scripts/simulation_position", line 39, in __init__
    self.position_publisher()
  File "/home/seb/sailing-robot/src/sailing_robot/scripts/simulation_position", line 60, in position_publisher
    position = self.nav.utm_to_latlon(self.utm_position[0], self.utm_position[1])
  File "/home/seb/sailing-robot/src/sailing_robot/src/sailing_robot/navigation.py", line 40, in utm_to_latlon
    return ll.LatLon(lat, lon)
NameError: global name 'll' is not defined
```
And in fact I don't really know how this piece of code is supposed to know `ll`, I managed to get rid of this one by replacing `ll` by `self.position_ll` in this line.

And then I have the error:
```
Traceback (most recent call last):
  File "/home/seb/sailing-robot/src/sailing_robot/scripts/simulation_position", line 69, in <module>
    Position_simu()
  File "/home/seb/sailing-robot/src/sailing_robot/scripts/simulation_position", line 39, in __init__
    self.position_publisher()
  File "/home/seb/sailing-robot/src/sailing_robot/scripts/simulation_position", line 60, in position_publisher
    position = self.nav.utm_to_latlon(self.utm_position[0], self.utm_position[1])
  File "/home/seb/sailing-robot/src/sailing_robot/src/sailing_robot/navigation.py", line 40, in utm_to_latlon
    return self.position_ll.LatLon(lat, lon)
AttributeError: LatLon instance has no attribute 'LatLon'
```

I am now going to bed ;) @takluyver maybe you have an idea on what is wrong with this function.

takluyver, 2016-07-09:
Thanks - it was a combination of copy-pasting and a method that seemingly wasn't called anywhere. A reminder that even the simplest bit of code benefits from a test.

Closed 2016-07-09.

Thread 98 (2016-07-09):

Check PID values for the rudder (sign issue)

Nanoseb, 2016-07-09:
During my tests and validations with the simulator I noticed that the rudder PID values are reversed (sign problem), the overwritten values during tack are right however.

I have made an hot fix by setting the P value as an negative number (in the simulator branch), but the problem have to be investigated further.

tsaoyu, 2016-07-09:
I have looked at related nodes, the issue is `pid_rudder` is following error convention of  `PID` class (https://github.com/Maritime-Robotics-Student-Society/sailing-robot/blob/master/src/sailing_robot/src/sailing_robot/pid_control.py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 ). And the controller is negative feedback x = -Kx (https://github.com/Maritime-Robotics-Student-Society/sailing-robot/blob/master/src/sailing_robot/src/sailing_robot/pid_control.py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). So I think it should be fine to use negative P value for the controller.

tsaoyu, 2016-07-09:
But negative P is not intuitive at all. So I added a minus sign x = -(-Kx) = Kx to keep both error convention and control command right.
ref: https://github.com/Maritime-Robotics-Student-Society/sailing-robot/blob/master/src/sailing_robot/scripts/pid_rudder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

Closed 2016-07-11.

Thread 104 (2016-07-11):

Use long term averaging for route planning

Nanoseb, 2016-07-11:
Right now the short averaging is used for everything, these data should be only used for winch servo command. The topic `/wind_direction_average` should be used for route planning.

Nanoseb, 2016-09-12:
Now that the heading is better (roll compensation), I think we can use that, if needed and for consistency the averaged wind angle can be relative to the boat instead of north.

Thread 105 (2016-07-13):

Reset tacking vote when a waypoint is reached

Nanoseb, 2016-07-13:
Right now after reaching a waypoint the boat will wait some times (7.5s currently) before going in the direction of the new waypoint.

smaria, 2016-07-13:
The question is how much time we want to spend on the tacking vote, considering that really this is not our final strategy

Nanoseb, 2016-07-13:
I think this can be our final strategy, and to improve it we can just change the pool time depending on the distance to waypoint (longer when we are further from the waypoint).

smaria, 2016-08-20:
We now only use the tack vote when we get close to a waypoint.

Closed 2016-08-20.

Thread 106 (2016-07-13):

Jibe when necessary

Nanoseb, 2016-07-13:
The boat is only doing tacks when it wants to change tack even if sometimes a jibe is more appropriate.

takluyver, 2016-07-13:
See also #31 - because we don't currently track where the sail is, we may jibe unexpectedly when going downwind. It's not clear whether this is a problem with no human sailors to be hit by the boom.

Nanoseb, 2016-07-13:
We don't really care about where the sail is and unexpected jibing here I think. Unlike a tack, you can jibe when ever you want and you will not loose speed.

If we want to improve performances of the boat we should avoid going between ~165 and ~195, and implement a 'jibing' strategy similar to the tacking one though.

Nanoseb, 2016-07-13:
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
(wind from the south and the boat is going north)

Nanoseb, 2016-08-18:
Just realised that the area scanning challenge will include only jibe, so it will save quite some time if the boat can actually jibe.

Nanoseb, 2016-08-26:
When the waypoint in downwind we can just go in straight line without taking care of the wind direction and the jibe, that is the easiest solution, and it will work quite well I think.

Nanoseb, 2016-08-26:
This is a fix that is working, the boat jibe when expected, @takluyver I let you improve it, maybe you want to keep updating the tackvoting when going downwind, or reset it (?).

takluyver, 2016-09-02:
I've just added a parameter that we can switch it to jibing rather than tacking if conditions make that seem more favourable. Between that and @Nanoseb's fixes, I think we can close this.

Closed 2016-09-02.

Thread 110 (2016-07-18):

Sheet tension sensor?

takluyver, 2016-07-18:
We realised that sail control might be easier if we could sense whether the sheet is under tension: if it's slack while we're trying to sail, we probably want to bring it in. We have entertaining ideas for jury rigging a tension sensor out of an elastic band and stuff, but this is probably low priority.

pierbiag, 2016-07-18:
Could this be done through current measurement on the servo?

takluyver, 2016-07-18:
Ooh, interesting. I don't know, but it would be nice if it could.

Thread 111 (2016-07-18):

Obstacle avoidance

takluyver, 2016-07-18:
Can we use a webcam to detect the presence of orange blobs in our path?

Nanoseb, 2016-08-18:
The node `sensor_camera_detect` publish in the topic `camera_detection` if anything is in front of the camera (and have the right color (set in the parameter file)).

The 'calibration' procedure is handled by the file 'utilities/camera_detection_calibration.py' (right now only the threshold can be calibrated with this script, and have to be copied/pasted in the parameter file).

takluyver, 2016-08-19:
Thanks Seb! I imagine that the higher level code using this will look something like:

- Sail between two waypoints repeatedly
- If the obstacle is detected when we're heading towards the waypoint, insert an extra waypoint, which will take us out of the normal course. Once we reach the extra waypoint, continue going to the waypoint we were already heading for.

Nanoseb, 2016-08-19:
Also because we have to stay in the 20m large 'channel' when there is no obstacle, we will probably need more than 2 waypoints (just add some others in between to be sure), but yes the main idea seems good.

takluyver, 2016-09-03:
So we have the detection working (hopefully), but we still need to integrate it to make a decision and sail the course.

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

This is my (fairly simple) idea. A, B, D and E in this diagram will be normal waypoints for it to sail to. Then after B (in the left-to-right leg) and D (in the right-to-left leg), there will be a task with conditional waypoints C0 and C1. If while the boat is pointing towards C0 it detects the obstacle, it will switch to head towards C1.

We want to position B and D not too close together, so that it can leave the course and return without hitting the obstacle or tacking. C1 needs to be far enough out of the course that we don't hit the boats making the obstacle, but close enough that we don't spend too much time going to it and back.

Obviously many more sophisticated schemes are possible, but time's pressing ;-)

Nanoseb, 2016-09-03:
ok now everything is ready, just need some testing.

Nanoseb, 2016-09-03:
just tested with the simulator and it is working as expected.

takluyver, 2016-09-03:
:tada:

takluyver, 2016-09-12:
The detection worked in the real challenge - unfortunately it was too late for the boat to turn away, but we definitely detected the obstacle.

Closed 2016-09-12.

Thread 113 (2016-07-18):

Keep GPS running

takluyver, 2016-07-18:
The GPS seems to go to sleep if nothing's reading from it (probably a power saving measure). This is annoying as it seems to have trouble getting a signal initially when it wakes up. We want to find some way of keeping it running.

Nanoseb, 2016-07-18:
Maybe just `cat /dev/ttyACM0 > /dev/null` will do the trick.
Or a cron job every x minutes with `dd if=/dev/ttyACM0 if=/dev/null bs=1M count=1`

takluyver, 2016-07-18:
I suspect that if we have something else trying to read from it, it will cause issues for our code actually trying to use it, because each of them will read random chunks of the data. If that's the case, we need something a bit more complex to read and forward the data. Sophia suggested keeping ROS plus the GPS node always running, but I'm not sure about that - I think it's useful to be able to completely shut down and restart the ROS machinery.

I should have mentioned that we do have a workaround: the GPS appears to stay on for some time (seconds, maybe a minute?) after it's read, so if we shutdown ROS and immediately start it again, we still have a fix.

Nanoseb, 2016-07-18:
We can make the cron job slightly smarter, and check at every run if the gps node is running.

smaria, 2016-08-20:
From ublox datasheet:
Time To First Fix
Cold Start: 29 s
Warm Start: 28 s
Hot Start: 1s

This document has more details on the power save modes: https://www.u-blox.com/sites/default/files/products/documents/PowerManagement_AppNote_%28UBX-13005162%29.pdf
My housemate has a windows PC and suitable adapters to change the GPS mode, I will have a talk with him.

For now it sounds to me like we can use the fix of just keeping roscore + the gps node running, and just killing roscore to restart it directly after.
We also don't need GPS running the entire time, only when we switch between different tests.

One thing to note when keeping roscore running: Parameters are kept. This means, we might get outdated parameters hanging around if we don't set them to a new value in the launch script. I don't think this is an issue.

Conclusion: Make separate always-on launch script. Talk to housemate about changing GPS settings.

takluyver, 2017-09-10:
Closing for now because this hasn't been a big problem in practice.

Closed 2017-09-10.

Thread 116 (2016-07-18):

Soft limits on sail servo

tsaoyu, 2016-07-18:
Because our servo works as continuous rotate motor at lower and upper PWM range it is necessary to set these two soft limits on lowest level node.  Test scripts `servo_key.py` can be found in utilities folder. One can change the lower and upper limits and use keyboard to find out these limits.

https://github.com/Maritime-Robotics-Student-Society/sailing-robot/blob/master/src/sailing_robot/scripts/actuator_driver_sail

smaria, 2016-08-20:
Sorry, what is the issue here? This looks like docs to me, which should then go in the boat setup in the wiki.
E.g. here:
https://github.com/Maritime-Robotics-Student-Society/sailing-robot/wiki/Pre-sail-Raspi-setup

tsaoyu, 2016-09-12:
Done by self test scripts now.

Closed 2016-09-12.

Thread 118 (2016-07-28):

Calibrate the compass without turning the boat over

takluyver, 2016-07-28:
As funny as it was to watch, trying to roll the boat through 360 degrees while keeping the IMU in place is impractical, and we would never be able to do it with the mast in place.

I think there should be two components of the 3D magnetic field we can detect: the earth's field and the combined field of components on the boat. With a smarter calibration routine, it should be possible to distinguish those without such crazy manouevering.

takluyver, 2016-08-05:
I think I've thought of how to do this. We calculate the corrected y field (from side to side) like this:

```python
MagY_comp = (MagX*math.sin(roll)*math.sin(pitch)) +\
     (MagY*math.cos(roll)) - (MagZ*math.sin(roll)*math.cos(pitch))
```

If we calibrate MagX and MagY holding the boat level, as we already do, and then ask the user to point it in a constant direction and roll it from side to side, we should be able to find the coefficient and offset for MagZ that keeps `MagY_comp` closest to flat as `roll` changes.

takluyver, 2016-08-11:
I have worked out how to do this calibration [in a notebook](https://github.com/Maritime-Robotics-Student-Society/sailing-robot/blob/master/notes/roll_calibration/Roll%20calibration.ipynb). I still need to put it into the calibration code. It will require scipy to be installed on the raspi.

takluyver, 2016-08-20:
I have committed a new calibration script. This works on the theory I described above, and it should involve two calibration steps for the compass:

1. Holding the boat level, we turn it around horizontally. This is the calibration dance we already do, except we should now consciously try to hold it flat.
2. Keeping it pointing to a constant heading, roll from side to side as far as practical. I think tilting to 45-60 degrees each way should be enough to calibrate the Z dimension.

I have tested the calculations for this in [a notebook](https://github.com/Maritime-Robotics-Student-Society/sailing-robot/blob/master/notes/roll_calibration/Roll%20calibration.ipynb), but we still need to test the script itself.

Closed 2016-08-20.

Thread 119 (2016-08-04):

Should magnetic field readings be divided by scale?

takluyver, 2016-08-04:
The compass calibration script [records the 'scale' parameters](https://github.com/Maritime-Robotics-Student-Society/sailing-robot/blob/40882029dc15f1f768509693585a3145dd052eed/utilities/calibration_scripts/compasscalib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) as the range of the readings, i.e. `max - min`. Then the sensor driver script [multiplies by the scale](https://github.com/Maritime-Robotics-Student-Society/sailing-robot/blob/40882029dc15f1f768509693585a3145dd052eed/src/sailing_robot/scripts/sensor_driver_imu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). Maybe I'm confused, but I think we should be dividing by the range to normalise it, not multiplying.

In principle, I think the range should be the same in all dimensions, so it shouldn't matter too much. I noticed it when I published the normalised field readings for debugging, and they're such huge numbers that it's hard to compare them in the dashboard.

Nanoseb, 2016-08-05:
Oh yes you are right I think, probably a miss understanding when we did that code (I was doing the calibration when Sophia was writing the node). I think you can safely change that.

Closed 2016-08-06.

Thread 120 (2016-08-06):

Can't tack in moderate waves

takluyver, 2016-08-06:
We tested today at the upper end of the wind speeds we may have to sail in, and there were small waves (maybe 10-20cm). We discovered that it was almost impossible to tack in these conditions, even with manual control - the boat being very light, it has little momentum, and as soon as it tries to turn into the wind, it loses speed.

We were still able to jibe, so we should probably include an option to jibe rather than trying to tack for these conditions.

The boat was also not able to sail very close to the wind, so we would have had a very hard time going upwind.

pierbiag, 2016-08-08:
All these problems related to overhealing and maneuverability in strong winds will ideally be solved by the smaller set of sails we are purchasing

Pier Maria Biagiolini

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

takluyver, 2016-08-08:
Great. Do we know when they'll arrive?

pierbiag, 2016-08-08:
I'm waiting a reply from the guy at sails etc so we can confirm the purchase

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

smaria, 2016-08-20:
Sails are here. However, jibing is still something we need to teach our boat to do.

smaria, 2016-08-20:
#106 deals with jibing. it may be worth adding to jibe when tacking hasn't worked a couple of times at a later time.

takluyver, 2016-09-02:
Closing this as we have both smaller sails and code for jibing. If we're tagging issues 'wontfix', we should probably close them.

Closed 2016-09-02.

Thread 121 (2016-08-06):

Wind speed sensor Arduino code?

takluyver, 2016-08-06:
I tried to take a wind reading today, but I couldn't find the Arduino code @smaria used before, and my attempts to modify existing code gave us readings of infinite wind.

@smaria could you check in the Arduino code you used for the wind speed sensor last week?

smaria, 2016-08-18:
wind speed sensor for laptop now in git repo and tested on the team laptop

Closed 2016-08-18.

Thread 122 (2016-08-06):

Water got in

takluyver, 2016-08-06:
Some water got in the boat today, and we lost control with the remote. @NanaOKA's expert paddleboarding saved the day, but we should try to waterproof it better.

Can we also design the servo control to do something useful if it fails - e.g. maybe let the sails all the way out, so that the boat slows down.

tsaoyu, 2016-08-06:
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

smaria, 2016-08-18:
How does the boat determine if it is a connection loss - or just a case of 'sailing as usually', remote switched off?

It would be possible to connect one of the receiver pins to the RPi directly, e.g. another pin from a switch that we always leave on. Then if this pin is not set anymore, we would see that on the RPi.

I would _never_ use this in the competition, however in the long run this can be used to then make the boat sail to a fixed home position. Until wrsc this imho has low priority.

takluyver, 2016-08-19:
I think we may have had water in the compartment containing the radio receiver; if that's the case, I suspect there's little we can do with the high-level control to rescue it. It was more a vague hope that the physical systems could be arranged so that a catastrophic failure results in it stopping rather than sailing away.

I agree that this is low priority, though - the safety boat for the contest should be able to catch it if it runs amok.

smaria, 2016-08-20:
we are currently waterproofing various bits, this includes the holes in the receiver compartment, which should fix this - unless there is leakage through the lid.

takluyver, 2016-09-02:
We hope that the improved waterproofing has fixed this.

Closed 2016-09-02.

Thread 125 (2016-08-06):

Investigate the remote control signal loss

tsaoyu, 2016-08-06:
We have several signal loss issue when we test today.
I assume this is because receiver antenna below water sometimes.
We need think about put antenna out if we have signal issue next time.

takluyver, 2016-09-12:
Putting the antenna out of the compartment may have led to water getting in. But with the antenna inside at the top, I don't think we had this problem again, so I'll close it for now; we can reopen if it comes back up.

pierbiag, 2016-09-13:
I actually had to stand up often because I lost signal at relatively small distances. Let's consider switching to sub-GHz for our own tests at least.

Pier Maria Biagiolini

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

Thread 126 (2016-08-12):

Real north and magnetic north

Nanoseb, 2016-08-12:
The north given by a compass is not the real one, so an offset have to be added to the magnetometer values to account for this difference. This offset depends on the location and the date (year).

I think we can hard code that or use a parameter (it will have to change between England and Portugal). The difference should be less than 8°, but still that is a correction easy to implement.

The correction should be made directly in the `sensor_driver_imu` code since the value without the correction is not useful.

takluyver, 2016-08-12:
Thanks Seb. I think doing this as a parameter is the best way.

According to [this site](http://www.ngdc.noaa.gov/geomag-web/#declination), the current declination is:

- Southampton: 1° 1' W
- Viana do Castelo: 2° 36' W

I think those numbers refer to where magnetic north points relative to true north, so we need to apply them in the other direction to find true north. So we should be adding a positive value to the compass reading in both cases.

Nanoseb, 2016-08-12:
Yes, perfect, I thought the correction was larger than that, but still 2.5° is something.

Nanoseb, 2016-08-31:
I added a parameter (that will have to be changed in Portugal !) to offset the heading.

Nanoseb, 2016-08-31:
By the way, are you sure we have to add positive values ? I think I always learned that from the magnetic north to the true one (in europe) we have to subtract a quantity.

Also in europe we have a west declination, and according to [wikipedia](https://en.wikipedia.org/wiki/Magnetic_declination#Non-adjustable_compasses) it means adding a negative value to a compass to have the true north.
Can you double check that also to be sure.

takluyver, 2016-08-31:
Yep, sorry, thinking it through again, you're right - westerly declination means the magnetic bearing we take will be a couple of degrees too high, so we need to subtract it (/add a negative). I think it's best to just make the numbers in the parameter file negative, as that fits with the usual east/west convention.

Closed 2016-08-31.

Thread 127 (2016-08-18):

install dependencies for simulator on team laptop

smaria, 2016-08-18:
it is late, so this is a reminder.
there seem to be a lot of unmet dependencies on tabarly so the simulator can't run

Nanoseb, 2016-08-18:
Here are all the dependencies for the simulator:
```
$ grep -h import simulation_* debugging_2D_plot | awk '{print $2}' | sed 's/,//' | sort -u

datetime
LatLon
math
numpy
rospy
sailing_robot.msg
sailing_robot.navigation
scipy.interpolate
sensor_msgs.msg
std_msgs.msg
time
visualization_msgs.msg
```

takluyver, 2017-09-10:
I think we can run the simulation on Tabarly now?

Closed 2018-05-01.

Thread 128 (2016-08-20):

make spare wind sensor

smaria, 2016-08-20:
this involves:
- 3d print another base
- glue magnets to wind vane
- cut metal rod of spare wind vane

takluyver, 2016-09-12:
We had a spare wind vane in Viana, but I don't think it was wired/magnet-ed up to be ready to switch in as a sensor.

tsaoyu, 2016-09-12:
We have run out of magnet and magnetometer for spare.
Parts will be ordered once we got new sub project code.

Closed 2017-09-08.

Thread 133 (2016-08-21):

add a (MIT) licence to our code, so people can actually use it

smaria, 2016-08-21:
I had some conversations with nanoseb and thomas about adding a licence to our repo. More specifically, the MIT licence [0]. To get ready for adding the licence, everyone please mark code you mainly worked on 'READY FOR MIT LICENCE' if this code is yours/written by sailing robot team members or an according licence text based on its sources.
Ask for help if you are uncertain. I believe Sebastien is looking into finding a licence for the IMU code.

[0] The choice was between a BSD/MIT style open for anything licence and a GPL style licence that would enforce all projects using our code to use the same licence. The core of ROS is BSD licence, and there were no strong arguments for using GPL instead. MIT is more popular on github and simpler than BSD (since there are there generations of BSD but just one generation of MIT), so we went for that.
If someone has concerns with this choice please comment/let me know in one of our next meetings.

takluyver, 2016-08-21:
Rather than trying to work out who mainly worked on which bit of code and add comments to it all, can I suggest a simpler way of doing this:

Anyone who has contributed code, you have a week from today to express any reservations about using the MIT license for it. If no-one objects, we will assume we're all happy with that, and apply the MIT license to the whole project (except any bits of code we have copied from other sources - we should try to identify and credit those).

Nanoseb, 2016-08-22:
We just got an answer from the writer of the imu driver code: https://forum.pololu.com/t/lsm303d-raspberry-pi-driver/7698/6
So we can use it without limitations.

tsaoyu, 2016-08-23:
`pigpio`: free and unencumbered software https://github.com/joan2937/pigpio/blob/master/UNLICENCE

`Python pid ` BSD License

`ros_lib` ROS Arduino library BSD License

smaria, 2017-02-11:
The licence was added

Closed 2017-02-11.

Thread 138 (2016-09-08):

Unify sheet demand calculation for boat and for simulator

takluyver, 2016-09-08:
At the moment, the boat does the sheet calculation in the `actuator_driver_sail` node, bypassing `actuator_demand_sail`, which means we can't test that code in the simulator. It should calculate a sheet length in *demand*, and driver should just be setting the PWM.

This is a reminder to me to work on this in a quieter moment.

Closed 2016-09-15.

Thread 139 (2016-09-12):

Wi-fi connection issues

takluyver, 2016-09-12:
Having a wifi connection to the boat makes it very easy to get full SSH access and change anything remotely. But during the competition we repeatedly had problems establishing and maintaining a wifi connection from the shore.

Ideas, in rough order of increasing effort:

1. Continue to live with limited connectivity from the shore, so the people in the RIB have primary responsibility for control. However, we've had occasions when the shore team has identified and fixed a problem (e.g. the need to git pull on the raspi) which the RIB team may have missed.
2. Upgrade wifi antennas, on the boat and/or on land. I think the connection was a bit better with the bigger antenna on the boat, but it was still an issue. Even with big antennas, the problem may partly be interference, especially if other teams are using wifi connections.
3. Mobile data connection on the boat; designed for greater range, moving systems and small antennas. However, latency will certainly be greater, and bandwidth may be small, depending on the area. We'd need to sort out local SIMs, but maybe could coordinate that with competition organisers, since I think they use SIMs for the GPS trackers.
4. Other point-to-point radios, such as XBee. These are more designed for the kind of range we want, but it would be more work to integrate them to do useful things.

TAJD, 2016-10-07:
I looked into bridging the ship/shore comms gap briefly at the end of my GDP. As a result I've had a few thoughts on the matter.

1. I'm guessing this works and has been proven as a reliable method (whilst frustrating and not ideal)
1. I'm not sure even upgraded WiFi antennas have the range required. It might be ideal to exert control over the range of 100s of meters from shore and I don't think WiFi has the range to do this. Plus larger antennas would add weight and possibly more points for water ingress to occur.
1. I've got a sim shield to plug into an Arduino, I've not tried using it yet though. The issues with this method are that sim shield itself is relatively bulky and that the sim data would need to be constantly topped up - this is spending money and it would be good to minimise that.
1. I've not used xBees themselves, and whilst they are relatively expensive they seem to be widely used and extremely good at communication over the sort of distances we're looking at. It might need a little bit of work to set up, but the investment of time depends on how critical we think a reliable ship/shore link is.

This comms link looks like a really key issue, but to identify a good solution we'd need to look at how we're willing to invest time/resources as well as the physical space on the boat and how much time we'd need to spend integrating the components together. I'd be quite interested in sorting out xbee communication as they're small, have good range and are low power. However they are relatively expensive.

pierbiag, 2016-10-07:
There are similar "plug and play" solutions for serial interface from rs (lora range) that are much cheaper and apparently more efficient. However they are already investigating the matter if we can do something useful (ssh-like) over such a low bandwidth link.

Pier Maria Biagiolini

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

takluyver, 2016-10-07:
As to the importance: I think there were relatively few occasions where the shore link actually made a difference. But it is nice to track it live, especially for demonstrating the boat to other people. So if we have the resources to pursue improvements, I think it's worth playing with.

takluyver, 2017-09-08:
We actually went backwards on this for 2017. :-( The wifi antenna is now with the raspi, rather than at the top of the mast, and so we get very little range on the signal, especially when there are waves. This was a problem at times, because it wasn't always clear whether ROS was still working, or when the boat had finished a challenge.

I think this is a big improvement that could be made for next year, whether it's a full control interface like we have with wifi, or a limited monitoring interface to have some idea what's going on.

tsaoyu, 2017-09-08:
https://haxiot.com/shop/lorawan-usb-client-us900/?doing_wp_cron=1504859862.1429119110107421875000

takluyver, 2017-09-08:
That looks interesting, though from a quick scan of the documentation it looks like more work than I had thought. I thought LoRa would give us a network interface which we could use like wifi, whereas the docs describe it as a serial interface which you send commands and data to. I'm sure we could make use of that, but it would probably be more work for less control than we have with wifi.

takluyver, 2017-09-14:
https://homes.cs.washington.edu/~gshyam/Papers/loRaBackscatter.pdf

(The system they describe is in the research stage, but it's encouraging that people are doing cool things with LoRa)

takluyver, 2017-11-18:
Suggestion from @griz1112 on issue #142:

> Use a RFD900x telemetry radio with mavlink. Has two channels and unreal range 10km with stock antenna up to 40km with upgraded antenna and directional pointing.

- [Example RFD900x modem](https://www.helibatics.com/rfdesign-rfd900x-modem-rc-control-and-telemetry-radio-modem-with-diversity/)
- [Mavlink ROS package](https://github.com/mavlink/mavros/blob/master/mavros/README.md)
- It sounds like Mavlink is designed for air vehicles - there may be some assumptions baked into it that don't hold for our use.

tsaoyu, 2017-12-05:
Considering get a pair of [USB LoRa](https://yadom.eu/reseaux-iot/lorawan/carte-de-communication-lorawan-usb.html).

- It use USB serial interface, leave physical UART pins for GPS module and easy to plug into laptop
- Have SMA connector, would better with RP connector and use [RP<>SMA](https://yadom.eu/modules/radio-modules/cable-ufl-rp-sma-100mm.html)
- access terminal using PPP over UART (bandwidth is limited but good enough to launch the system)

griz1112, 2018-01-17:
You can use mavlink for anything. Ardupilot has versions for planes drones boats even submarines. I have it on my rover. If you are coming from a ROS env use mavros to integrate the two.

Thread 140 (2016-09-12):

Human communications

takluyver, 2016-09-12:
The 'vi in a screen' chat system was an inspired hack but not ideal:
- We all share one buffer, so if two people type at once, you get a mess of mingled characters.
- The only way to tell if you're still connected is to try changing something
- It's easy to forget about it, so questions readily go unanswered.

Ideas:
1. Dedicated chat system over local wifi - are there existing solutions? How well do they handle flaky connections (see #139)?
2. Walkie-talkies - but this requires an extra hand to use.
3. Audio headsets, as used by gamers to communicate without requiring hands.

tsaoyu, 2016-09-12:
After some search on GitHub
https://github.com/shazow/ssh-chat

and Google shopping

http://twoway-radioshop.co.uk/motorola-tlkr-t40-radios.html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

and

http://www.onedirect.co.uk/motorola-tlkr-t80-2-x-closed-face-helmet-mics

takluyver, 2016-09-12:
I've also seen ssh-chat, but I'm not sure if it's what we want for this. E.g. I don't think it stores messages at all, so if you say something while I can't connect, I never see that.

Nanoseb, 2016-09-12:
apparently there is some sort of history, try the example server `ssh chat.shazow.net`.

takluyver, 2016-09-12:
True, so maybe that would work.

smaria, 2016-09-24:
still needs us connected to the boat network, only works for people with a laptop etc. I am a big fan of the walkie talkies, they will help so much just on normal lake tests.

pierbiag, 2016-09-24:
I should have a couple somewhere, I'll see if they still work and in case bring them

Pier Maria Biagiolini

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

tsaoyu, 2017-12-12:
Got a pair of walkie talkie with audio headset.

Closed 2017-12-12.

Thread 141 (2016-09-12):

See when manual remote control is active

takluyver, 2016-09-12:
Can we tell from the Raspi which state the multiplexer is in? It would be really useful to display this in the dashboard and record it in ROS bags.

tsaoyu, 2016-09-12:
We have an extra wire reserved between RPi and Multiplexer for this purpose.
An easy way is to pass selection signal on channel 5  to RPi.
On software side, use `pigpio` read to monitor http://abyz.co.uk/rpi/pigpio/python.html#read .

takluyver, 2016-09-12:
Sounds like this should be a matter of one simple ROS node to turn the GPIO state into ROS messages, then :-)

Nanoseb, 2016-09-15:
The code also have to handle when the remote is off. The multiplexer have a failure state for that to switch to autonomous when no signal is received. This doesn't need to be a 3rd state but need to be seen as autonomous mode.

takluyver, 2016-09-15:
I'm hoping that the multiplexer will show us the same thing for that case as when the RC is on but with autonomous control enabled. But this will all have to be tested when we've got the multiplexer.

Nanoseb, 2016-09-15:
The idea was to connect the raspberry pi to the receiver pin, so I am not really sure about that, but yes anyway this will have to be tested with the multiplexer.

takluyver, 2017-09-08:
This is working nicely.

Closed 2017-09-08.

Thread 142 (2016-09-12):

New ground station and mission control system

tsaoyu, 2016-09-12:
We have a nice web-based light ground station system to monitor our boat. It is good enough for simple tasks and missions in this competition.

In a long run, we may need:
1. On server side, better graphical interface on with our existing web-based monitoring page
2. On client side, find suitable mission control system which can display more information at same time
https://github.com/nasa/openmct

http://wiki.ros.org/ground_station

mltomb, 2016-09-15:
Hello

I found our github few days ago. It is cool to be able to see this type of discussion.

We tried this ground station this year.
http://ardupilot.org/planner/docs/mission-planner-overview.html

It was really useful. It can understand multiple protocols in network or serial link. We used mavlink protocol trough wifi.

Nanoseb, 2016-09-15:
Thanks for the tip, we tried to use it with ROS some months ago (there is a package to convert ros messages to mavlink) but we had some issues (don't remember what). I think we can give it an other try, having a live map is quite useful. Right now we are using rviz (a ROS ploter, but it is quite basic and not perfectly suited for that).

tsaoyu, 2016-09-15:
mltomb, You are welcomed to join our conversation!

We have investigated the possibility in using APM planner as our ground station system. The problem is that we don't have a reliable wireless connection for MavLink. At that moment, we only use a tiny USB dongle for wireless communication.

New we have a more powerful WiFi antenna, it is time for to have another try.

This problem is related to https://github.com/Maritime-Robotics-Student-Society/sailing-robot/issues/139

griz1112, 2017-11-12:
Use a RFD900x telemetry radio with mavlink. Has two channels and unreal range 10km with stock antenna up to 40km with upgraded antenna and directional pointing.

takluyver, 2017-11-18:
Thanks, I copied the suggestion to #139,  which is more about the radio link.

Thread 143 (2016-09-12):

Next plan for our website

tsaoyu, 2016-09-12:
We are using a second level domain with free WordPress subscription. It has a fairly easy to use editor and control panel. But it also have many restriction. For example, we are not able to put our crowd funding widget on the page.

 And to better publicise ourself, a designated domain like `www.sailrobot.co.uk` or `www.sailrobots.com` would be great.

Also, our WordPress is the only domain we used in print material. To keep that, options including:
* Keep using WordPress, upgrade to paid plan
* Redirect to new domain (£11/year)
* Buy a new domain and redirect to WordPress page

If we abandon WordPress system we can:
* Use GitHub pages
* Rent our own VPS e.g. DigitalOcean

takluyver, 2016-09-13:
For reference, the Wordpress $3 plan includes a custom domain. Domains cheaper than redirects: lazy way to keep people around. Their registration [doesn't include](https://en.support.wordpress.com/domains/#available-domains) `.uk` domains, though.

I would go for a domain like sotonsailbot, and end with either a UK suffix or a `.org`.

If we move away from hosted solutions, I'd rather go for a static site hosted on Github pages, so we don't need to run our own server.

tsaoyu, 2016-09-21:
Aber team launched their web page with [GitHub page](abersailbot.github.io).
It can be a good reference for us.

SuperWool, 2016-09-23:
`sotonsailbot` sounds good. Do we go for that?

tsaoyu, 2016-10-07:
`www.sotonsailrobot.org` is up and running now

takluyver, 2016-10-07:
And it even has a picture of us rather than a stock photo now! :-)

Closed 2016-10-07.

Thread 144 (2016-09-13):

X86 micro-controller?

tsaoyu, 2016-09-13:
https://software.intel.com/en-us/iot/hardware/joule

Key-features:
- 64bit X86 arch
- ROS compatible
- 48GPIO with 4 hardware PWM
- MHF4 connectors for external antennae
- on chip Intel HD graphics card

takluyver, 2016-09-13:
Jealous of the boat running Windows? ;-)

I don't think we ran into any limits of computational power or connectivity, so I'd be inclined to stick with the Raspi - they're cheap, readily available, and there's a lot of information already out there from people who've already done all kinds of things with them. The most attractive thing on the feature list is the connections for antennae, but I don't know if we'd actually use that.

tsaoyu, 2016-09-13:
Haha, I am really Jealous on their Windows 10 computer stick.

The most attractive part for me is X86 arch with Ubuntu Core.
It opens greater possibility for more ROS libraries.
For example, sensor fusion library with http://wiki.ros.org/robot_localization

It also have drawback like smaller user community and higher price.

takluyver, 2016-09-13:
I'm confused - does that library require x86? Or does it need more processing power than we have?

Nanoseb, 2016-09-13:
The processing power is really not an issue atm, when every thing is launched we use about 10-20% of the total cpu, even the opencv lib did not use much cpu

tsaoyu, 2016-09-13:
No, this library requires dependencies which is not available on ARM.

takluyver, 2016-09-13:
Which deps are those? Searches aren't turning up much info.

tsaoyu, 2016-09-13:
Don't remember atm, I  will let you know once I meet Brain

 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

takluyver, 2017-09-10:
Closing for now as we have no current plans to move to x86. We'll keep our eyes open for different options, though.

Closed 2017-09-10.

Thread 145 (2016-09-13):

exterior LCD display on board

tsaoyu, 2016-09-13:
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

A display like this with information like:
* Name of current launch file
* Power level of battery
* Autonomous/Manual mode

Nanoseb, 2016-09-13:
Haha, the launch file name, good idea ;)

smaria, 2016-09-24:
This looks like it will be a mess during waterproofing and will very likely be covered up by bumblebee tape in most use cases. How about we display the name of the launch file on the dashboard? (same goes for battery state, once we can read it)

takluyver, 2016-09-24:
I agree that info on the dashboard is more practical use in most cases, and less of a concern for waterproofing.

Do we know of a way to get the name of the launch file from inside ROS? My searches for that are not turning up anything.

Thread 146 (2016-09-14):

More hardware support

tsaoyu, 2016-09-14:
To make more people use our code on their own boat.
We are planning to extend our hardware support.
Raspberry Pi family would be a good start:
*  **Raspberry Pi 3**
* Raspberry Zero

and another popular linux single board computer like:
* **BeagleBone Black**
* Odroid  XU4 (http://www.hardkernel.com/main/products/prdt_info.php?g_code=G143452239825)

 **Bold**  indicates micro-computer we now have access to

Nanoseb, 2016-09-14:
I think we first have to focus on documenting what is already working (both the code and the hardware).

tsaoyu, 2016-09-14:
That is also a good point.

takluyver, 2016-09-14:
I also wouldn't focus too much on code reuse until there are people interested in it. A lot of the fun in this kind of thing is building your own systems, so I doubt other teams like us would take our code as a whole for their own boat. They're more likely to use pieces of our code in their own project, but it's hard to anticipate which pieces and what would be different about the context. It's much easier to work this stuff out when someone is actually *trying* to use it.

I agree that we should better document what we have (almost all open source code could have better docs). We should also make sure we can easily hear from likely users of the code (e.g. on the microtransat mailing list).

Nanoseb, 2016-09-14:
Also you will probably recruit (a lot of) new people this year, so a good documentation is needed at least for them.

tsaoyu, 2016-09-14:
Indeed, our Wiki and documentation system is bit messy. And there are two things looks interesting one is nice document done by Aberystwyth team http://boatd.readthedocs.io/en/latest/ , another is the best practice in developing ROS packages http://wiki.ros.org/Get%20Involved .

takluyver, 2016-09-14:
The Boatd docs use Sphinx, which I'm pretty familiar with. That's a fairly manual style of documentation; we have experimented with autogenerating docs from our code, which is less effort than manual documentation but also produces less nice results.

It's only worth making such nice docs once you have a pretty stable API, though - if you're still changing interfaces a lot, then either you spend a lot of time changing the docs as well, or your docs get out of date. Out of date docs are worse than not having docs at all, but they confuse and distract people.

I'd start with the high level description of the system, like the node diagram - which is almost surely out of date, because we've been changing stuff fast and have had higher priorities than redrawing it.

smaria, 2016-09-24:
I put the auto generated docs in a separate github repo, so people don't need rosdocs to see them (but we still keep our code repo clean). However we are trailing off the original topic of this ticket.

Since we would like to switch to the Pi zero anyways, we should focus on that one; and I think nanoseb is already working on that one.

smaria, 2016-09-24:
Sorry, I thought we had a 2xpi2 and 1xpiZero, not a pi3. From what I recall, more people were interested in getting the pi zero to work. I also find it more interesting since it is cheaper, smaller, and computational power should be sufficient as mentioned above.

Nanoseb, 2016-11-22:
I have tested the pi zero over this week end, in the end, it can't really be used like our pi 2 because it is not powerful enough. It can't keep up the rate of 10Hz that we have at the moment, and image processing (for the obstacle avoidance) is taking a lot of cpu as well.
So it can't replace entirely our pi 2/3.

tsaoyu, 2016-11-23:
Seb, thanks for your report!
RPi zero seems couldn't meet the computation power requirement, we will not look at this platform until next hardware version released.

I think we will all agree that RPi 2 is board "officially" supported. For collaborators, we will recommend them use RPi 2 for the best compatibility. (I am still cruise about the compatibility of RPi3.)

Thread 148 (2016-09-24):

Investigate what happened with the USB cable

smaria, 2016-09-24:
The usb cable that is wired through the boat has a short between at least two wires. What happened? Do we need to improve something about our wiring?

smaria, 2017-02-11:
The USB cable is now fine, aside from some corrosion because it got wet when we were not using it at the competition.
This makes me assume that the usb cable must have gotten water inside, which made the connection.

Conclusion: We cannot assume that USB wires are waterproof.

Nanoseb, 2017-03-04:
Cat6 wires (for outdoor uses): http://www.cabling4less.co.uk/category.php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

posecap, 2017-03-04:
http://uk.rs-online.com/web/p/usb-cable-assemblies/0252062/

Nanoseb, 2017-03-05:
Sorry, I shouldn't have wrote my comment here, it is a closed issue. @posecap you can add your link to the wishlist here: https://github.com/orgs/Maritime-Robotics-Student-Society/projects/2

Closed 2017-02-11.

Thread 157 (2016-11-21):

Fix boat box

smaria, 2016-11-21:
The boat box lid has come off, we need to re-attach it. Beforehand we need to figure out how we can strengthen the lid so it doesn't come off soon again.

Closed 2017-09-08.

Thread 158 (2016-11-24):

Update high level node overview

tsaoyu, 2016-11-24:
Update our high level node overview graph with launch files and `rosgraph` tool

ukcojamak9-martin, 2016-11-26:
I am trying to get a picture of what is going on using rosbag, but I am having problems.

When I play a bag file with " rosbag --play 'ros_file.bag' ", initial indications are that it is working: " rostopic list" shows the topics and I can see the messages via " rostopic echo 'topic' " even the rospy command line interface I have written to help me understand what the boat is doing can see the messages.

However " rosgraph ", " rqt_graph " and " rviz " all appear to not be seeing what is going on.

When I " roslaunch simulator.launch " everything seems to work normally, which is all I have needed so far.  But to update the node overview graph, it would be better if I could get "rosgraph" and "rqt_graph" working with a bag file so that I can see the actual nodes rather than the simulation nodes.

Anyone got any idea what I am doing wrong with rosbag please?

In case it helps: ROS is being run inside a Docker container.  I am running commands through a direct bash console for the CLI commands and X-forwarding through SSH for the graphical interfaces.

tsaoyu, 2016-11-28:
My assumption is `rosbag` we had didn't record all topics during test.
Take a look what topics are included with `rosbag info <your bagfile>` command.

ukcojamak9-martin, 2016-11-28:
Thank you, I have just tried that, and it shows that the topics are there with a load of messages (I am using the extravaganza.bag file from the git-challenge repository).

This if confirmed by me being able to see the messages as they are being replayed by rosbag in some programs like " rostopic echo <topic_name> "

smaria, 2016-12-07:
It may have something to do with the order in which you launch things. I usually start a roscore, then launch a bag file (whilst playing, try the --loop option so you don't have to keep relaunching), and finally the tools that I want to use.

ukcojamak9-martin, 2016-12-09:
Sorry for not updating this, We worked out what was wrong on the software meeting last week.  Ii was only showing one node as there is only one node issuing all the messages when running a bag file.

I will need to get a copy of the picture off of the Raspberry Pi when it is actually running ROS

smaria, 2017-02-02:
I can't quite follow how this is needed for a node overview?
What information are you looking for?

Thread 159 (2016-12-01):

Look into compass calculations without calibration

takluyver, 2016-12-01:
The algorithm described in this paper can apparently give heading and orientation without needing calibration:

www.mdpi.com/1424-8220/15/8/19302/pdf

tsaoyu, 2017-05-01:
In this new IMU [driver](https://github.com/tsaoyu/RTIMULib), it use Kalman filter to get fused magnetometer, gyro and accelerometer reading. I have implemented this on our new RPi3, it gives a very stable yaw angle with careful ellipsoid magnetometer calibration. Based on this, I would like to do some further tests:
 * How battery pack position influence *fused* orientation reading?
 * How our boat influence *fused* reading? Does it possible to use bare RPi + IMU calibration profile for the boat
 * How stable this calibration is? Can we detect abnormal magnetic filed change?

tsaoyu, 2017-05-01:
[RTIMULib2](https://github.com/RTIMULib/RTIMULib2) said to have runtime magnetometer calibration functionality

> RTIMULib2 is the second version of the original RTIMULib library. The main change is the addition of the runtime magnetometer calibration functionality.

If we found all three issues we mentioned before all have negative answers, runtime calibration is still an option for us.

takluyver, 2017-05-09:
@NanaOKA just pointed me at [imu_complementary_filter](http://wiki.ros.org/imu_complementary_filter), which is written by the author of the paper I linked to above (Roberto Valenti). I don't know how it compares with RTIMULib2.

Thread 161 (2016-12-01):

Better way of debugging

tsaoyu, 2016-12-01:
Find a better way/ toolset to debug our code.

tsaoyu, 2017-05-01:
I spotted this VS code based ROS development IDE http://www.roboware.me/

smaria, 2017-07-22:
What are we currently missing for debugging? What current problem are you trying to solve with this new tool? This is not a very specific issue.

takluyver, 2017-07-25:
Yeah, sorry, this isn't a very useful issue. I think we created this when we were discussing my frustration with trying to debug behaviour problems with the boat - it's hard to debug during a test because you're short of time, and trying to do everything on a laptop balanced on your knees while someone shades it from the sun. But when you get back, it's tricky to remember what was going on and find the relevant information to make sense of it.

There were a couple of concrete things that came out of this discussion:

1. The index of data files from tests, to make it easier to find the file you're looking for.
2. The system for recording timed notes, so we have a quick way to record when something is happening which we might want to look at later.

Maybe I'll have a go at writing a blog post about these tonight, if you like. In the meantime, I'll close this issue - we should open more specific issues if there are particular things we want to improve.

@tsaoyu thanks for the link to roboware, it looks interesting.

Closed 2017-07-25.

Thread 162 (2016-12-01):

Correct inconsistence of convention system

tsaoyu, 2016-12-01:
There are some inconsistence between convention system and our code.
We need update them on WiKi page.

tsaoyu, 2016-12-05:
In more detail we need document the following:

- Zero position and its reference
- Direction convention of signs
- Unit type

We can use hardware to check the consistency of conventions with real hardware.
[Servo test](https://github.com/Maritime-Robotics-Student-Society/sailing-robot/blob/2c719e66094c148de513542f2b8a181f4a824b80/src/sailing_robot/scripts/actuator_driver_rudder) script is reusable to test sail angle/ rudder angle.

smaria, 2016-12-07:
I quite liked the proposal at the southampton python user group, of having classes that return angles etc. in different reference systems.

A lot of conventions are already documented on the [naming conventions](https://github.com/Maritime-Robotics-Student-Society/sailing-robot/wiki/Naming-conventions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) page, but may need updating...

Which conventions are we missing from that page?

Thread 163 (2016-12-01):

Velocity estimation and wave frequency analysis

tsaoyu, 2016-12-01:
Get velocity from GPS and wave frequency from IMU.

smaria, 2016-12-07:
We can get velocity estimates from GPS and IMU, and the [robot_localization](http://wiki.ros.org/robot_localization) package should help with that
Presentation video and slides can be found in the program of [roscon 2016](http://roscon.ros.org/2015/)

May be worth splitting this in two issues, robot localization and wave frequency analysis?

tsaoyu, 2017-04-04:
`ros-kinetic-robot-localization ` is installed on ubuntu 16.04
@TanakitkornK it's time to work the error covariance matrix for our sensors now 🛩

Thread 166 (2016-12-01):

Docker files

tsaoyu, 2016-12-01:
Docker is probably a good idea to create portable ROS image for us.

@ukcojamak9-martin create a general docker file that useful for our project.
(Can you share docker and put some document in https://github.com/Maritime-Robotics-Student-Society/sailing-robot/wiki/Virtual-Machine-for-Windows-Mac-users ?)

And we want to know for Raspberry Pi, are there any restriction on hardware access?

Reference: http://blog.hypriot.com/

ukcojamak9-martin, 2016-12-03:
Guidance on stalling Docker and a sailing-robot image are now in the wiki.  dockerfile files have been pushed to the repository.

takluyver, 2016-12-03:
Thanks @ukcojamak9-martin !

Leaving this open for now to discuss the tradeoffs of using docker on the raspi as well.

tsaoyu, 2016-12-03:
Thanks Martin!
I have tried docker on macOS.  The isolated docker developing environment seems promising to me.
And here are some bugs I found when I make it works on macOS.

1. Shared `catkin workspace` only works on Linux
```
docker run --name sailing-robot -h sailing-robot -v /Users/caoyu/PycharmProjects/sailing-robot:/home/pi/sailing-robot --rm -it jamak9/sailing-robot:indigo

indigo: Pulling from jamak9/sailing-robot
Digest: sha256:f3fe5cc108f20e9ec4f1224a09330fa9c0d2a53db60b23f90e2fa1c0bd6830dc
Status: Downloaded newer image for jamak9/sailing-robot:indigo
```
And the error message:
```
bash: /home/pi/sailing-robot/devel/_setup_util.py: /usr/local/bin/python: bad interpreter: No such file or directory
Failed to run '"/home/pi/sailing-robot/devel/_setup_util.py" ': return code 126
```
This is because ROS was installed on mac with `homebrew` version of python. So the python interpreter is located at `/usr/local/bin/python`, cause error when linking host and container.

I think it would be great if we can point out that "Shared folder allows easy access to source file but the compatibility is based on host environment. " For me I have completely give up running ROS on macOS due to regular crash of `rviz` and `rqt`. And I just wondering, does it possible to `git pull` in the container and keep it completed isolated with host?

2. Terminal access to container works well

`docker exec -it sailing-robot bash`

3. No lucky with `ssh` access and X-forwarding

After setup `sshd` in container, I have tried `ssh pi@172.17.0.2 ` but time out.

And also `ping 172.17.0.2` with result
```
PING 172.17.0.2 (172.17.0.2): 56 data bytes
Request timeout for icmp_seq 0
Request timeout for icmp_seq 1
Request timeout for icmp_seq 2
Request timeout for icmp_seq 3
Request timeout for icmp_seq 4
Request timeout for icmp_seq 5
Request timeout for icmp_seq 6
```

I am investigating this issue to make sure we can run GUI program like `rqt` and `rviz` with X-forwarding on host computer. It would be helpful if you can share the output on yours computer of the two commands I have tried.

ukcojamak9-martin, 2016-12-03:
1) If you remove `-v /Users/caoyu/PycharmProjects/sailing-robot:/home/pi/sailing-robot` from the `docker run...` command, then `git clone`, `git pull` and all other git commands should work as normal.  However, everything that you do will be forgotten when you shutdown and restart the docker container.

You can also change it to this instead::
`-v sailing-robot-git:/home/pi/sailing-robot`

It will appear very similar to removing it totally, but it should remember the files within /home/pi/sailing-robot between restarts. (It does this by creating a local container to contain the files within that directory.)

I have just tested this on linux and once started I had to `chown` the /home/pi/sailing-robot to pi as it defaulted to root.  It did remember the owner on restart though.

2) good.  :-)

3) Assuming that the ssh server started properly, then my next step in diagnosing it would be to check the ip address, as the one in the script is the default one on my computer, it may be different on a mac though.
Not sure how to do that on a mac, but on linux it is with `ifconfig` within the container which comes up with two interfaces eth0 and lo  it is labelled 'inet addr:' under the eth0 interface.

(Sorry if I am telling you stuff you already know, also if there is not enough detail please let me know.)

ukcojamak9-martin, 2016-12-03:
Just been thinking a bit more.  Before you edit the `docker run...` line:

 within the container try running:
`sudo ln -s /usr/bin/python /usr/local/bin/python`

to see if that helps.

If it does, I will add it to the docker image.

ukcojamak9-martin, 2016-12-03:
I have now uploaded a new version of the docker image to, hopefully, fix the python location problem on mac's.

Please `docker pull jamak9/sailing-robot` and let me know if it has fixed it please.

tsaoyu, 2016-12-04:
Thanks, Martin. I can confirm the symbol link for python interpreter works well!

ukcojamak9-martin, 2016-12-04:
How is SSH going, did you manage to check the ip address?

tsaoyu, 2016-12-04:
I have managed to `ssh` into `sailing-robot` container with bit of effort
[Here](https://docs.docker.com/docker-for-mac/networking/#/i-cannot-ping-my-containers) I found it is not possible to `ping` into containers on macOS. As a work around I publish the ssh port 22 to 2222 with command
```
docker run -p 2222:22 -it jamak9/sailing-robot
```
and then inside the container start ssh service.

And the `ssh` access is done by
```
ssh -p 2222 pi@localhost
```

I am still working on X window forwarding issue. But I am not really optimistic about the result,  [rviz](http://answers.ros.org/question/27695/x11-forwarding-and-ros-visualization-tools/) doesn't play well with X window. To have a fully functional desktop development environment, I would suggest using native `homebrew` approach.

ukcojamak9-martin, 2016-12-04:
Can you update the wiki with Mac instructions please, as you understand it much more than me. `rviz` works well for me on X windows, so maybe it is a mac issue?

I know nothing about homebrew, so can not advise on this.

takluyver, 2017-01-26:
I've added the three scripts from the wiki into git, and made the one that starts the docker container a bit smarter to find the repository directory by itself.

Closed 2017-10-10.

Thread 168 (2016-12-08):

Antenna optimisation on top of mast

alvaropp, 2016-12-08:
- Try to get the RC antenna out of the hull for improved range
- Optimise the number of wires going up the mast

smaria, 2016-12-08:
https://store.uputronics.com/index.php?route=product/product&path=60_64&product_id=84

breakout board similar to what we are using, with SMA female connector

Thread 169 (2016-12-08):

Waterproof SMA cables

smaria, 2016-12-08:
They will be a bit more challenging to waterproof.

https://www.gigatronix.co.uk/coaxial-connectors/browse/sma-waterproof

takluyver, 2017-09-10:
Do we still need these? Are they for antennas? Or something else?

Thread 170 (2016-12-08):

Battery charge sensor

alvaropp, 2016-12-08:
- Measure current & voltage

takluyver, 2017-09-10:
This would be very cool, but I don't know if it's possible with our current battery setup?

Nanoseb, 2018-09-01:
done \o/

Closed 2018-09-01.

Thread 171 (2016-12-08):

Remove peak current draws from servo

smaria, 2016-12-08:
currently we can't use the same batteries for servo motor because during peak current draws the battery voltage collapses too much and the raspberry pi reboots. There must be a way to circumvent this with a capacitor based circuit, so we can simplify our power supply system.

alvaropp, 2016-12-08:
Sail servo : HS-785HB: current idle 8mA, running 230mA (both at 4.8V)
Rudder servo : S3003: current idle 25mA, running 100mA, stall 400mA (all at 4.8V)

alvaropp, 2016-12-08:
https://en.wikipedia.org/wiki/Battery_eliminator_circuit
http://www.stefanv.com/electronics/qf200105.html

smaria, 2016-12-08:
We should also try other power supplies, the issue we had might just be very specific to the one power bank we had

posecap, 2016-12-08:
would a 7.2v battery with separate regulator for the motors and electronics work?

posecap, 2016-12-08:
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
L78S05CV does 5v at 2amp then use a switching reg for the electric circuit

Thread 172 (2016-12-08):

Improve the wind sensor

alvaropp, 2016-12-08:
- Mechanical connection of new wind sensor
- 3D printed base for the current sensor

smaria, 2017-02-02:
I got some information how the tiny wind sensors are working that other people were using at the competition. It uses a mechanical encoder, which leads me to the conclusion that our magnetometer solution is still better.

I just realised there are plastic ball bearings - that sounds like a great idea as a basis for a mechanical connector: There shouldn't be much load on them and they can't be corroded by salt water

smaria, 2017-02-10:
http://www.igus.co.uk/wpck/2499/igubal_sphaerische_Axiallager?C=GB&L=en
I think this is what we want.

smaria, 2017-02-11:
http://simplybearings.co.uk/shop/Bearings-Deep-Groove-Ball-Bearings/c3_11/index.html

smaria, 2017-02-14:
http://www.bulletweights.com/Products/FishingSinkers/BulletWeights-Magnetic.aspx
this seems to be magnetic, and might make a good weight to balance the wind sensor

smaria, 2017-02-14:
Or just some magnets: https://www.amazon.co.uk/d/Magnets/POWER-MAGNET-STORE-Neodymium-Countersunk/B00L1LSOOQ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

Nanoseb, 2017-02-14:
I think simple magnets are better since we want to have a 'clean' magnetic field and be able to orientate it so that the IMU sees it the best. With bullet weights you can't really do that, the best fit can be 90° from the 'natural' one loosing all the advantage of its shape.

smaria, 2017-02-14:
http://www.ebay.co.uk/itm/like/222285644558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
These might make an easy, light, no tools required attachment for the wind sensor and when using two they should give enough friction to not struggle with the sensor moving from zero rotation by accident

smaria, 2017-02-14:
http://www.ebay.co.uk/itm/Rubber-Stoppers-Bungs-10mm-Solid-Red-Pack-of-2-Laboratory-for-Test-Tubes-Science-/111824071937
these could help hold the magnet in place

smaria, 2017-07-18:
https://simplybearings.co.uk/shop/p170654/6882RS-Budget-Rubber-Sealed-Deep-Groove-Ball-Bearing-8x16x5mm/product_info.html

I purchased a couple of these for prototypes

takluyver, 2017-09-10:
We have a new wind vane assembly now. Have we tested this with an IMU attached?

Nanoseb, 2017-10-10:
Closing, see #205

CamilV, 2018-03-13:
Zirconium oxide bearings: 608CE Bearings
https://www.amazon.co.uk/Bearings-Zirconium-Ceramics-Skateboard-8%C3%9722%C3%977mm/dp/B06XRWK479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

Closed 2017-10-10.

Thread 175 (2017-02-07):

Consistent clock unit for Raspi

takluyver, 2017-02-07:
@tsaoyu mentioned this today - a device with a separate small battery which keeps running a clock, so that when we boot the Raspi up, it can immediately get the correct time, without needing to run the `setclock` script and get a GPS fix. Consistent timestamps would be really useful for organising recorded data like rosbags.

- How big are they, in volume & weight? Can they fit inside the inner box with Brian?
- How much do they cost?
- What physical & software integration do we need for the Raspi to get the time from one?

tsaoyu, 2017-02-07:
The one I found [here](http://www.volumerate.com/product/ds3231-raspberry-pi-rtc-board-real-time-clock-module-for-arduino-black-844277258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) has the specifications:

Dimensions:	0.55 in x 0.55 in x 0.55 in (1.4 cm x 1.4 cm x 1.4 cm)
Weight: 5g
Cost: £1.74
It has  I2C standard interface

takluyver, 2017-02-08:
Sounds promising. Here's a tutorial on integrating it with the Raspi so the clock is set on boot:

https://learn.adafruit.com/adding-a-real-time-clock-to-raspberry-pi/overview

tsaoyu, 2017-05-01:
Before we order a real time clock module, can we have a last go with [NavCLOCK](https://github.com/tsaoyu/ublox/blob/master/ublox_msgs/msg/NavCLOCK.msg) message with latest GPS driver?

takluyver, 2017-05-02:
We do already get time messages from the GPS once ROS is running, and we use these in the GPS log that we produce. I'm happy to look at using the NavCLOCK message type for that, but I'm not aware of any problems with that part of the system.

However, the GPS time is inconvenient for a few reasons:

1. We want to have the system time on the Raspi correct before starting ROS, because it creates files with timestamps in the name as it starts up. We have the `utilities/setclock` script to do this, but we need to remember to run it. We forgot this at our test last weekend, for instance.
2. It's only available when the GPS receiver is connected and can pick up satellites, so we can't use it for an indoor test, for instance.
3. The NMEA 0183 interface we're using only gives us a time-of-day (e.g. 14:01:32), so we need to enter the date manually. I've just looked and the GPS signal does actually carry date information (in a rather weird format) - I don't know if there's a way to access that.

An alternative to the RTC module would be for one or more of our laptops to run ntp servers which the raspi can find and synchronise time from.

takluyver, 2017-07-03:
We have worked out how to get the date from the GPS as well, which improves this situation.

I have also written a script `piaccess/time2pi.sh` which sends the date & time from a laptop to the pi. It's a hackish way of doing it which won't give any degree of accuracy, but for our purposes it's sufficient to have the time accurate to a few seconds.

I want to test the time2pi script at the meeting tomorrow, and if it's working I'll close this.

takluyver, 2017-07-04:
OK, `time2pi.sh` is working.

Closed 2017-07-04.

Thread 180 (2017-02-15):

Jibe if tack fails

Nanoseb, 2017-02-15:
Force the boat to jibe when a tack fails.

I did a first implementation of that, but it was not used because quite dumb and could lead to more issues than without (it just creates a wp behind the boat).

The idea would be to make a 'real' jibe like it is done when the jibe_to_turn parameter is set to true.

Nanoseb, 2017-02-15:
@takluyver at the moment your task manager can't subscribe to topics right?
Do you think this can be done easily?

Here to implement this I want to have a node that time the duration of the tack and if it is too long it publish something to say to your class to jibe instead. Do you think that is the good approach?

takluyver, 2017-02-16:
The task manager handles a sequence of tasks (e.g. go to waypoint, or linger at waypoint), each of which has ways to calculate:

1. What should I do now?
2. Is this task finished? (when it is, the task manager will go on to the next one)

The manager has a Python API to insert a temporary task, do that and resume the task it was doing before. This is what it does with waypoints published on the `temporary_wp` topic. We could make a task type like 'jibe', or 'head downwind for 5 seconds', and then have it listen to another topic to trigger inserting such a task. I think that's simpler than something based on the obstacle avoidance waypoints, which is a specific kind of task.

Nanoseb, 2017-02-17:
Oh yes ok, that'll be cleaner, thanks

Nanoseb, 2017-02-22:
it is in progress, see branch [force_jibe](https://github.com/Maritime-Robotics-Student-Society/sailing-robot/tree/force_jibe)

takluyver, 2017-04-23:
The implementation seems to work, though we might increase the timeout a bit for low wind conditions.

We also discussed yesterday using the proposed sensor-fusion speed estimates to delay tacking while the boat gains sufficient speed to make a tack, and to make decisions about when to jibe.

Closed 2017-04-23.

Thread 181 (2017-02-18):

What clever stuff can we do with an eInk screen?

takluyver, 2017-02-18:
I have picked up a second hand [Kobo Touch N905C](https://en.wikipedia.org/wiki/Kobo_Touch) eReader, which is highly hackable, to use as a display in bright light.

What can we do with that? In increasing order of complexity:

1. Translate manuals, checklists etc. into a format it can read and load them so we can easily see them in the light.
2. Generate images in the odd bitmap format the screen uses, and use a program already on the system to display them (I have already hacked it to give me telnet access).
  * Info here: http://www.chauveau-central.net/pub/KoboTouch/
3. Run Python on it and use available code to update part of the screen on demand
  * Python+Kobo info: https://www.mobileread.com/forums/showthread.php?t=219173
  * Updating display info: https://www.mobileread.com/forums/showthread.php?t=234002
  * Example application written in Python: https://bitbucket.org/david_weese/kobo-weather-app

If anyone's really keen, someone has even [got Debian running on a Kobo](https://sites.google.com/site/gibekm/hardware/kobo/kobo-as-tablet) with a lightweight Linux desktop. I don't think that's likely to be useful, but it's cool that it's possible.

smaria, 2017-02-22:
Sounds cool, I'm not sure what is really possible, these are the concepts I get from the above data, ordered by likelyness/usefulness:

- Have a laptop running as a webserver for the kobo, translating rosdata into $interesting stuff, display via wifi
- Have the device connected via usb, same as above
- Have the device connected to the Pi on the boat via usb(?), displaying $stuff
- Have the device running debian and then ROS itself, displaying stuff

Especially the first sounds like a really cool plan

takluyver, 2017-02-22:
The connectivity story:

* The device has wifi, though it has a tendency to turn off the radio after a few minutes to save power. Some people online think that you can kill a specific process to stop that happening - I haven't tested.
* The USB interface acts by default as a storage device (I think I saw something about running a network interface on it, but that starts to sound tricky). Maybe we could write files to it and have something running on the ereader that scans for an updated file and displays it? I think the device has to unmount storage to expose it on USB, though.

takluyver, 2017-11-01:
Another link in the 'advanced' category: [kobowm](https://github.com/pasqu4le/kobowm) is a simple X window manager written in Python.

Thread 182 (2017-02-21):

Check servo wiring issue

tsaoyu, 2017-02-21:
We found rudder servo do not work properly in autonomous mode, maybe it is worthwhile to use logic analyser to check what happen to rudder servo control.

takluyver, 2017-02-21:
We think this is probably a bad connection at the RPI gpio pins.

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

smaria, 2017-02-22:
Interesting, especially combined with the weird IMU issues we had. Maybe its time to move on from the free flying wiring?

alvaropp, 2017-02-28:
28/02/17 conclusion: the rudder servo pin connection seems a bit dodgy. We got weird PWM readings once when shaking the RPi, which we couldn't replicate later on.

alvaropp, 2017-02-28:
Changed the wire and _seems_ fine now

Closed 2017-02-28.

Thread 185 (2017-07-03):

Try AHRS to get stable heading

tsaoyu, 2017-07-03:
Attitude and heading reference system (AHRS) use raw sensor data from the magnetometor, accelerometer, and gyro to compute a more stable heading.

Try AHRS system https://github.com/DavidEGrayson/minimu9-ahrs could help us improve the performance of heading estimation.

joshctaylor, 2017-07-22:
I highly recommend this AHRS algorithm for your application. It is based on a paper which prevents magnetometers from distorting the attitude estimate - something common with most implementations.

http://wiki.ros.org/imu_complementary_filter

tsaoyu, 2017-07-25:
Thank you for your suggestion. We have already implement this sensor filter node on our boat. But this haven't been included in our calibration routine and `imu/data` give full orientation need to be convert to our heading in current system.

tsaoyu, 2017-07-25:
Since `xsens_driver` for MTi3 sensor from Xsens and `complementary_filter` node both give full `imu/data` with full orientation, our first task is to use `imu/data` to get heading.

joshctaylor, 2017-07-26:
This makes sense, I use the xSens heading estimate for my experiments - it's accurate enough for my purposes but I find the orientation drift starts to become significant after 10 mins when comparing 7 identical (MTw) sensors. I imagine if they have recommended the MTi3 for your purpose it has different filter weighting more suitable for stable heading estimates. It's worth discussing your application with Monique Paulich from xSens as she is quite familiar with the algorithms they are using.

takluyver, 2017-09-10:
Closing this for now as it's superseded by using the Xsens. We can use other issues (such as #197) for working out difficulties with the Xsens.

Closed 2017-09-10.

Thread 187 (2017-07-04):

Easily plot calibration after finishing

takluyver, 2017-07-04:
Plotting the calibration gives us a decent chance of distinguishing a bad calibration:

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

From a good one:

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

I'd like to make some machinery so we can quickly get plots of a calibration run as soon as it's finished, so we can redo it if there's a problem.

takluyver, 2017-07-19:
This is implemented as `piaccess/check_compass_calib.py`.

Closed 2017-07-19.

Thread 188 (2017-07-04):

IMU pitch offset from boat pitch

takluyver, 2017-07-04:
The pitch we read from our IMU is about +10 degrees when we consider the boat to be level.

* Does this matter?
* Can we fix it in hardware, by positioning the IMU or the brian box better?
* If not, should we adjust it in software to give a pitch reading for the boat?

joshctaylor, 2017-07-22:
This would depend if you reading euler angles or converting from a quaternion or cosine matrix. Euler angles.
Euler angles have a singularity known as gimbal lock which causes angle to approach infinity when pitch excedes 90 deg. You are unlikely to encounter gimbal lock if roll pitch and yaw are aligned with the boat axis unless you nose dive. If they are not you will start getting odd angles.

If you are using DCM or quats best practise is to 'subtract' (actually divide) the orientation for when the boat is level. Then convert to euler angles in roll-pitch-yaw order to avoid gimble lock.

I hope this is useful.

Josh

Thread 190 (2017-08-06):

Respawn Xsens node on failure

takluyver, 2017-08-06:
Sometimes it fails to connect to the Xsens device. We should ensure it automatically respawns when this happens, rather than us restarting ROS manually.

tsaoyu, 2017-08-08:
Respawn option have been set to true for the xsans_driver a simple log show it works is attached below:
```
[INFO] [1502022664.318867]: Found parameter: ~device, value: auto
[INFO] [1502022664.328829]: Found parameter: ~baudrate, value: 0
[INFO] [1502022664.338702]: Found parameter: ~timeout, value: 0.002
[ERROR] [1502022664.592186]: Fatal: could not find proper MT device.
Unhandled exception in thread started by
sys.excepthook is missing
lost sys.stderr
[xsens_driver-2] process has finished cleanly
log file: /home/pi/.ros/log/17936d04-7aa3-11e7-9ecd-b827eb9e0baf/xsens_driver-2*.log
[xsens_driver-2] restarting process
process[xsens_driver-2]: started with pid [4065]
[INFO] [1502022669.666491]: Found parameter: ~device, value: auto
[INFO] [1502022669.677938]: Found parameter: ~baudrate, value: 0
[INFO] [1502022669.688140]: Found parameter: ~timeout, value: 0.002
[INFO] [1502022669.972560]: Detected MT device on port /dev/ttyUSB0 @ 115200 bps
[INFO] [1502022669.976407]: MT node interface: /dev/ttyUSB0 at 115200 bd.
[INFO] [1502022670.057074]: Found parameter: ~no_rotation_duration, value: 0
[INFO] [1502022670.069032]: Found parameter: ~frame_id, value: /imu
[INFO] [1502022670.081088]: Found parameter: ~frame_local, value: NED
```

Closed 2017-08-08.

Thread 191 (2017-08-06):

Investigate Xsens filter scenarios

takluyver, 2017-08-06:
We think we might be using the scenario which ignores the magnetic field.

- [x] Figure out which scenario it is using.
- [x] Decide which one we want to be the default (Low_mag_dep?)
- [x] If necessary, modify the ROS driver code to set the scenario when it starts.

takluyver, 2017-08-08:
We found it was using one called `north_reference`. We have set it to `general`. Waiting to test it.

takluyver, 2017-08-08:
Progress: it no longer uses a fixed heading when you start it up. The headings still weren't right, though. We'll try doing a new MFM next time.

takluyver, 2017-08-09:
@tsaoyu I realised last night that the bad readings we were getting in our final outdoor test might be partly due to the 180 degrees 'correction' we put into the sensor_service_imu code on Saturday. If you're testing at the weekend, try taking that out again.

tsaoyu, 2017-08-09:
Good point. I assume that is the downside of the hardcode approach.
I will look at that 🔨  during weekend.

tsaoyu, 2017-08-15:
Progress: a consistent heading reading is acquired with `north_reference` is as profile, `NED` framework with 90 degrees offset. Drift in heading still happens may because the calibration or slight move during the start up.

takluyver, 2017-08-23:
We're still not reliably getting the right numbers from this. Do we:

1. Carry on fiddling with the settings of the Xsens
2. Go back to the settings which reliably produced a number relative to the starting heading, and accept that we can only start that node with the boat on land.
3. Revert to using the MinIMU for now

joshctaylor, 2017-08-24:
Did you try talking to Monica at xSens? She's been the most useful when I had sensor issues. I found the best was was to call them.

takluyver, 2017-08-24:
Thanks Josh! Tony, do you have the necessary contact information?

joshctaylor, 2017-08-24:
Monique Paulich <Monique.Paulich@xsens.com>
+31 88 97367 00

If you are using the university phones use the following access number
to allow you to dial internationally

0843 375 1020 (Planet Talk)

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

tsaoyu, 2017-08-25:
After bit research on the technical issue, I managed to make Xsens give us consistent heading reference now. As a reference I put some important points here

1. Do not use Active Heading Stabilisation (AHS) even it sounds like the thing we are looking. What it is actually doing is to use a stable magnetic field as a reference to correct gyro bias. Because of this, once it is actively no matter which profile is used, all heading reads out are not magnetic filed referenced any more.

2. Rule of thumb for the calibration: at least 3 minutes will sufficiently large angle covered and held it **really** still. No Gaussian distributed normalised magnetic residual means we are in trouble, those calibrations should be discarded and should be use for the missions.

3. Orientation rest are set of  tool that help us to realign IMU inside the boat. It works like this: reset heading (means align x axis to north), inclination(align tangle plane), and alignment (x axis align with the centre of boat). The store option will remember those setting and write it to sensor. We don't need to touch because we currently hard code the rotation in `imu_service` node now.

4. Another dangerous thing we shouldn't click is a little compass with save icon. This is for in run calibration (ICC) function, which assume the full calibration is not possible and click such bottom will write a new magnetic field matrix to the sensor.

5. Move the system during no rotation period will result in a wrong gyroscope bias calibration which leads to a slow but bounded drift on the heading. We need to hold the boat still for at least 6 seconds when launching the system.

6. Position of battery has a huge influence on the magnetic field, firmly attach battery at exact place on top of RPi otherwise an unbounded drift on heading will happen.

tsaoyu, 2017-08-25:
Attach screen shot of a successful calibration.
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

takluyver, 2017-08-26:
Nice! Was that calibration with the raspi and the battery pack present?

tsaoyu, 2017-08-26:
No, this one was done without the presence of battery pack.
but the one with battery pack looks pretty same with this.

Closed 2017-09-08.

Thread 193 (2017-08-06):

Fix boat box

takluyver, 2017-08-06:
The big wooden box for transporting the boat got damaged around the hinge. We've often said we need to fix it, but we need to make sure we do before we prepare to go to the competition.

Closed 2017-08-26.

Thread 195 (2017-08-14):

Test camera calibration

Nanoseb, 2017-08-14:
I reprogrammed the calibration procedure for the camera color detection. But since I won't be the one using it, some of you need to try it and tell me if it is understandable.
(Ros is not needed to run the calibration)

``` /sailing-robot/utilities/calibration_scripts/camera_detection_calibration.py ```

takluyver, 2017-09-08:
Sophia did it, it seemed to work nicely. :-)

Closed 2017-09-08.

Thread 197 (2017-09-10):

Place IMU further from raspi + battery

takluyver, 2017-09-10:
We are now pretty confident that the raspi and battery pack have a significant effect on the magnetic field experienced by the IMU (Xsens). We have mostly been able to work around this by recalibrating it, but that's inconvenient and doesn't always work.

We should place the IMU elsewhere in the boat where it's less affected by electric currents, but ensure that it's still protected from water as well. One option might be to get a holder for the bare Xsens board, rather than using the USB developer board.

Thread 198 (2017-09-10):

Figure out how to calibrate Xsens without connecting to a laptop

takluyver, 2017-09-10:
To calibrate the Xsens, we currently have to unplug it from the raspi and plug it in to a laptop using USB to run the magnetic field manager GUI. We've only got this program compiled for x86/x64, so we can't run it directly on the pi. However, it can run on a data file collected separately, rather than reading the Xsens live.

- [ ] Record the necessary data format using the raspi
- [ ] Write the generated calibration model to the Xsens from the raspi
- [ ] Automate moving the data between a raspi and a laptop (optional)

Another option would be to connect to the raspi and use its USB port remotely - I don't know if this is possible or how we would do it.

tsaoyu, 2017-09-12:
The "another" option seems pretty neat to me. I found something claim to do this https://virtualhere.com/home

takluyver, 2017-09-12:
Aha, and that appears to be based on a Linux feature called usbip. I think we can probably figure out how to use that directly, rather than using a proprietary wrapper.

Nanoseb, 2017-11-07:
this looks super straight forward: https://www.howtoforge.com/how-to-set-up-a-usb-over-ip-server-and-client-with-ubuntu-10.04
usbip is probably in the repo for ubuntu.

takluyver, 2017-11-14:
I've been trying to set this up, but run into problems with the fact that all the packages on the raspi are out of date - I can't install new packages compatible with the old ones on there. @tsaoyu can you remember what the problem was with updating before? Can I try updating everything and see what breaks?

Nanoseb, 2017-11-14:
just tried between 2 up to date archlinux, and I can't make it work, I have an error at the very end (during the attach). It isn't as straight forward as I thought ;)

Nanoseb, 2017-12-14:
Done, thx @takluyver  !
d68b23b

Closed 2017-12-14.

Thread 205 (2017-10-10):

Put electronics on new wind sensor

smaria, 2017-10-10:
We have a shiny new wind vane, and wire layout that can fit GPS, WiFi and wind sensing in the waterproof cable we have, so we now only need one single wire up the mast.

This requires drawing the final layout (after discussing it with me), some taking apart of WiFi antennas, soldering and waterproofing.

This may also solve #139 , since the WiFi antenna will be higher above the water.

CamilV, 2017-10-31:
Placing the IMU at the highest possible location on the under the wind sensor is the best place to set it up because of the physical limitation of the structure of the wind sensor and at the same time it gives us the best resolution of it, without saturation. Maximum and minimum reading values from the magnetometer shown as below.

|   | Min    | Max   |
|---|--------|-------|
| X | -12704 | -2279 |
| Y | -22216 | 20985 |
| Z | -17724 | 24201 |

CamilV, 2017-10-31:
- [ ] Water proof of IMU
- [ ] Water proof of GPS
- [ ] Integration test of new wind sensor

Nanoseb, 2018-04-29:
I think we can close this now

Closed 2018-04-29.

Thread 211 (2017-11-07):

Create a structure for post high level commands

Nanoseb, 2017-11-07:
The title is probably not very clear...
For now, the high level package gives order directly to the low level like "tack_to_port" etc. and the low level catches these messages and set the rudder to +- 45 for example.
However sometimes there is some more computing/thinking between the highlevel and the low level. Like sheeting out when we jibe, jibing instead of tacking, jibing is a tack fails. And in the future waiting for the right moment to tack, sheet out to tack, sheet out if strong heeling etc.
All of these things are not supposed to be handled by the very high level (that cares more about the path planning).
At the moment things that are implemented are a bit "hacky". Having a proper structure for them would be cleaner and easier to add new behaviour in the future.

I don't know yet how to handle that, one large node? one node per behaviour? something else?

Nanoseb, 2018-02-15:
@takluyver and all, I think we can continue the discussion we had on Tuesday here.

After thinking about it, I agree that the voting system should be in this manoeuvre/helming node, it is not sailing strategy/navigation but  something to prevent from tacking too much. However the highlevel should still have a way to overwrite this (tack right now) when close enough to the waypoint etc (needed for the station keeping for ex). But this can be implemented later, for now we can keep the voting in the highlevel.

Then, concerning the structure of such code, the more I think about it and the more I think it will look like our task system... ROS nodes are not made for that, you can't really run a node for a short amount of time and kill it afterwards etc.
So what I see is:
   - Helming node subscribes to `sailing-state` and `goal heading`
   - we have one class per behaviour (tack, jibe, tack-in-wave, tack-with-sheet-out, tack-with-speed-up-phase etc.)
   - these classes need some parameters like which direction is the tack/jibe
   - the timeout check can be left to the Helming node, it can stop a behaviour class from running and go to the next one on its list if needed. Or come back to the normal behaviour if the tack is a success.

One thing I still don't know is how to handle the sheet sail setting. The behaviour class sometimes need to overwrite these (sail setting not based on wind direction any more), but sometime they don't. And having the same code in each and every behaviour class to handle sailsettings isn't nice. Same goes for the rudder, sometimes in the behaviour code we will need to keep using the PID and then overwrite to +-45 degree. Not sure yet how to do that cleanly.

takluyver, 2018-02-15:
I think that mostly sounds good, but one minor note: I think having the high level node override the lower level is probably bad design. I don't have a neat rule or design pattern to point to for this, but my instinct is that it would be messy. We'd need some extra code to decide when to listen to the high level instead of the low level, and then we'll find some case where we want the lower level to override the higher level again, and pretty quickly you've got a digital argument which is a pain to debug.

So I'd try to design it without overrides as far as possible. For each thing the system has to decide, there should be one node which makes that decision. For other nodes, let's think in terms of sending information that can affect the decision, rather than overriding it.

Nanoseb, 2018-02-15:
Yes I totally agree with you for the overwriting. I said it in those terms because I didn't really know how to make these things work.

Something we could do, I think, it is to have some functions that act on the low level and that are easy to use like for example for the rudder:
- set_rudder(PID, goal_heading)
- set_rudder(-5degree)
- set_rudder(MAX_ANGLE) for example

same for the sail:
- set_sail(wind)
- set_sail(OUT)
- set_sail(IN)
- set_sail(wind, 1.2) (=to sheet out 20%more than the lookup table for example)

Then it will make the behaviour class super easy to write, just focusing on the logic

Nanoseb, 2018-02-15:
Ah yes, sorry you were talking about the tack now thing vs the voting system. Yes ok, that makes sense, then for example in this case the helming node will need to know the distance to the waypoint, but that's ok, it can be published by the high level.

I am going to try to draw a schematic of all the information passing between nodes/components

Nanoseb, 2018-04-17:
2003652 is a first working version, it still needs debugging (with the simulator), cleaning, and re-factoring.
I think this file can (and should) be split in 2 or 3 files.

Nanoseb, 2018-04-26:
see #237

Nanoseb, 2018-04-27:
This is now done and merged, it will be tested on water soon. Closing this and I'll reopen more specific issues if needed.

Closed 2018-04-27.

Thread 212 (2017-11-07):

Sheet out to tack

Nanoseb, 2017-11-07:
When the boat is tacking in strong wind conditions, the jib being sheeted in prevents the boat from going more upwind. Sheeting out a bit in such case reduces the effect of the jib on the boat and allow you to tack.
(see #211)

Nanoseb, 2018-04-27:
Implemented in the new helming node, there is one value to tune which is the amount of sheeting out needed.

Closed 2018-04-27.

Thread 215 (2017-11-21):

Add impact of wind to heeling/maneuvrability on simulator

Nanoseb, 2017-11-21:
For now the sheet settings are not taken into account in the simulator, and nothing publishes/computes the heeling angle

joshctaylor, 2017-11-22:
you need a VPP? Check out the ORC vpp documentation for an well documented VPP. I've attached a VPP paper for Laser Dinghies - there is a section on depowering and flatting the sail. To take the mainsheet into account just workout how position relates to sail angle. Hope this helps
[Offshore Racing Congress - 2013 - RACING CONGRESS OFFSHORE ORC VPP Documentation 2013.pdf](https://github.com/Maritime-Robotics-Student-Society/sailing-robot/files/1496141/Offshore.Racing.Congress.-.2013.-.RACING.CONGRESS.OFFSHORE.ORC.VPP.Documentation.201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)

[Day - 2017 - Performance prediction for sailing dinghies.pdf](https://github.com/Maritime-Robotics-Student-Society/sailing-robot/files/1496137/Day.-.2017.-.Performance.prediction.for.sailing.dinghies.pdf)

Thread 218 (2017-12-05):

Improve wind vane calibration

Nanoseb, 2017-12-05:
The wind direction node can be improved to take the north magnetic field into account.

It involves getting the north magnetic field magnitude during calibration and using the heading of the boat when sailing.
It will improve the wind direction when the boat is heeling for example

takluyver, 2017-12-06:
We probably need to get the compass working more reliably before this would actually improve accuracy.

Thread 221 (2017-12-15):

Desing 3D printable bulb

smaria, 2017-12-15:
A bulb that can be filled with lead shot and attaches at the top with a go-pro holder would be nice. It probably needs a metal rod inside the 3D printed parts for stability.

smaria, 2017-12-15:
Technically, this is for footies only, but a good task for getting involved. If we are going 3D printed, it might be interesting to consider putting some sensors in as well?

Thread 224 (2018-01-23):

Detect water leak

Nanoseb, 2018-01-23:
Having 2 naked wires at the bottom of the boat with the proper distance between them is probably enough to detect a leak of salty water.

Nanoseb, 2018-01-23:
closing, duplicate see #55

Closed 2018-01-23.

Thread 225 (2018-01-23):

Detect flappy sail

Nanoseb, 2018-01-23:
Detect when the sails are not set correctly and flaps.
This could be done via adding a small accelerometer on the sail, or via measuring sheet tension?

Nanoseb, 2018-01-23:
Closing, duplicate

Closed 2018-01-23.

Thread 230 (2018-03-17):

uBlox GPS with i2c

Nanoseb, 2018-03-17:
So, today we (Camil and I) have played a bit more with the GPS and i2c.
A couple of things can be noted. First i2c seems to be smart enough and there is no way of having clash of data with imu's for example (it was fun to see that with the logic analyser: imu message in the middle of the GPS ones ;) )

Secondly, we have about 40% of the gps messages that do not pass the checksum. It is only one or two characters that are not read correctly but that makes the message harder to parse so what to do with that:
* is it an issue? can we just assume that the GPS will work at half of its frequency and still be fine
* since only a couple of the characters are not good can we write a parser that will be more robust, the probability that the actual GPS coordinates are not readable is even lower

A last thing to consider is that with i2c we can't reprogram the chip, this means that we probably need to have the 2 serial pins accessible in case we need that.

The code we used to test the GPS is there: https://github.com/Maritime-Robotics-Student-Society/sailing-robot/blob/master/utilities/test_i2c_gps.py

@tsaoyu or @takluyver maybe? an idea?

If i2c isn't good enough we can still use the serial for the GPS, but we are avoiding that because it adds 2 cables to the top of the mast.

takluyver, 2018-03-18:
If it's purely random, it's probably fine to skip the corrupted messages and accept a lower frequency. If there are blocks of several seconds where all the messages are corrupted, that might be more of a problem, depending on what the boat is doing at the time.

I'd say it's a bad idea to make the parser more 'robust' and try to use corrupted data: sooner or later, the corruption will give you a valid coordinate that's hundreds of miles out.

Was the 40% error rate with a long connection or a short one? Does it increase with the wire length? Are there things we can do (e.g. twisting wires together) that might improve the reliability? I've got no idea what sort of signals i2c uses.

Nanoseb, 2018-03-18:
Yes, it looks random, but an other thing that will be interesting to analyse is the actual rate that we can achieve.

Also we will need to try outside with actual GPS data, here messages were quite empty, with longer messages maybe the probability of them being corrupted is higher.

The 40% were gathered with long wires, and they were twisted even if in this case it shouldn't have an impact on the signal.

Concerning having a more "robust" parser, ok yes it is probably a bit dangerous. Also the checksum is just a XOR on the ascii character sent (which is quite weak I think), this means that some of the message have the right checksum but are still corrupted (even number of bit flipped at the right position for example).

CamilV, 2018-03-18:
I don't think the I2C signal is an issue in this case as the IMu, which is running on the same lines, doesn't lose any data, or at least we didn't notice it losing data. The signal is a bit noisy, because of the long wires and the close proximity of them, but once converted into digital, it doesn't seem to be an issue.
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
Channel 0 is SCL and channel 1 is SDA.
You can see the noisy signal here, when one line changes state, it pulls the other line with it by about 0.25V, but I don't think that's an issue, as the digital conversion looks alright and I2C only uses the 2 voltage levels, low and high. We could try having the 2 lines further apart, in that case we wouldn't have this noise, but I'm pretty certain that won't have any influence on the corrupted bits

Nanoseb, 2018-04-11:
We've made some more test yesterday, and with i2c we can achieve only a frequency of about 0.4-0.5 Hz... Which is not enough. Also the settings set with the weird ublox messages (done with serial) doesn't seems to survive a reboot of the gps. This would be usefull to improve the frequency rate of the gps.

CamilV, 2018-04-17:
https://www.u-blox.com/sites/default/files/products/documents/u-blox8-M8_ReceiverDescrProtSpec_(UBX-13003221)_Public.pdf

Nanoseb, 2018-04-17:
So today some quite good news:
- we managed to send ublox messages to the gps via i2c
- we have a script in utility (for now) to send less useless messages and increase the frequency to 5Hz
- result: we get about 3.7-4Hz in the end \0/

So we are quite happy with this and I think we can continue with i2c, just have to write the node to use that now (or adapt the current node for i2c).

Nanoseb, 2018-04-27:
I think we have this issue: http://www.advamation.com/knowhow/raspberrypi/rpi-i2c-bug.html

Nanoseb, 2018-04-27:
Ok, yes it seems to be that, it leads to i2c hanging when the gps and the pi are out of sync, and only a reboot can help...
To avoid this we can reduce the i2c baud rate (line in /boot/config.conf) but this now leads to timeout when sending/receiving messages. So we need to figure out how to increase the i2c timeout.
It seems doable, but this: https://raspihats.com/i2c-hat/2016/02/16/raspberry-pi-i2c-clock-stretch-timeout.html doesn't work apparently (probably out of date).

Nanoseb, 2018-05-15:
we tried it, and it works fine!!!

Closed 2018-05-15.

Thread 231 (2018-04-18):

Fix simulation of velocity

Nanoseb, 2018-04-18:
Since the new node for the GPS (that publishes a velocity as well), velocity message type have changes, hence the simulation_velocity node needs a bit of adaptation.

(@tsaoyu I guess you had that issue when trying the simulator recently)

tsaoyu, 2018-04-18:
Yes, I had some issue on that.

Closed 2018-04-19.

Thread 234 (2018-04-21):

Installation: testresources, tornado, setup.py

bryzhao, 2018-04-21:
Hi Soton team,

During the installation step on the sailing-robot wiki (https://github.com/Maritime-Robotics-Student-Society/sailing-robot/wiki/Virtual-Machine-for-Windows-Mac-users), under the **Post installation setup** section, where the instructions say:

- Install the needed dependencies for the sailing robot

`~/sailing-robot/utilities/setup_scripts/Install_needed_packages.sh`

I get the following errors in my terminal (in bold):
Reading package lists... Done
Building dependency tree
Reading state information... Done
bc is already the newest version.
gpsd-clients is already the newest version.
i2c-tools is already the newest version.
libgeos-dev is already the newest version.
python-scipy is already the newest version.
vim is already the newest version.
python-pip is already the newest version.
0 upgraded, 0 newly installed, 0 to remove and 296 not upgraded.
Installing Python packages...
The directory '/home/bryanz/.cache/pip/http' or its parent directory is not owned by the current user and the cache has been disabled. Please check the permissions and owner of that directory. If executing pip with sudo, you may want sudo's -H flag.
The directory '/home/bryanz/.cache/pip' or its parent directory is not owned by the current user and caching wheels has been disabled. check the permissions and owner of that directory. If executing pip with sudo, you may want sudo's -H flag.
/usr/local/lib/python2.7/dist-packages/pip/_vendor/urllib3/util/ssl_.py:339: SNIMissingWarning: An HTTPS request has been made, but the SNI (Subject Name Indication) extension to TLS is not available on this platform. This may cause the server to present an incorrect TLS certificate, which can cause validation failures. You can upgrade to a newer version of Python to solve this. For more information, see https://urllib3.readthedocs.io/en/latest/advanced-usage.html#ssl-warnings
  SNIMissingWarning
/usr/local/lib/python2.7/dist-packages/pip/_vendor/urllib3/util/ssl_.py:137: InsecurePlatformWarning: A true SSLContext object is not available. This prevents urllib3 from configuring SSL appropriately and may cause certain SSL connections to fail. You can upgrade to a newer version of Python to solve this. For more information, see https://urllib3.readthedocs.io/en/latest/advanced-usage.html#ssl-warnings
 InsecurePlatformWarning
Requirement already up-to-date: pip in /usr/local/lib/python2.7/dist-packages (10.0.1)
**launchpadlib 1.10.2 requires testresources, which is not installed.
matplotlib 1.3.1 requires tornado, which is not installed.**
The directory '/home/bryanz/.cache/pip/http' or its parent directory is not owned by the current user and the cache has been disabled. Please check the permissions and owner of that directory. If executing pip with sudo, you may want sudo's -H flag.
The directory '/home/bryanz/.cache/pip' or its parent directory is not owned by the current user and caching wheels has been disabled. check the permissions and owner of that directory. If executing pip with sudo, you may want sudo's -H flag.
Collecting Latlon
/usr/local/lib/python2.7/dist-packages/pip/_vendor/urllib3/util/ssl_.py:339: SNIMissingWarning: An HTTPS request has been made, but the SNI (Subject Name Indication) extension to TLS is not available on this platform. This may cause the server to present an incorrect TLS certificate, which can cause validation failures. You can upgrade to a newer version of Python to solve this. For more information, see https://urllib3.readthedocs.io/en/latest/advanced-usage.html#ssl-warnings
  SNIMissingWarning
/usr/local/lib/python2.7/dist-packages/pip/_vendor/urllib3/util/ssl_.py:137: InsecurePlatformWarning: A true SSLContext object is not available. This prevents urllib3 from configuring SSL appropriately and may cause certain SSL connections to fail. You can upgrade to a newer version of Python to solve this. For more information, see https://urllib3.readthedocs.io/en/latest/advanced-usage.html#ssl-warnings
  InsecurePlatformWarning
/usr/local/lib/python2.7/dist-packages/pip/_vendor/urllib3/util/ssl_.py:137: InsecurePlatformWarning: A true SSLContext object is not available. This prevents urllib3 from configuring SSL appropriately and may cause certain SSL connections to fail. You can upgrade to a newer version of Python to solve this. For more information, see https://urllib3.readthedocs.io/en/latest/advanced-usage.html#ssl-warnings
  InsecurePlatformWarning
  Downloading https://files.pythonhosted.org/packages/cf/f0/5c23d9431a69cf27d139e9ae09db7f0f032c88192384dad3f8d7e0c860e8/LatLon-1.0.2-py2-none-any.whl
Collecting shapely
  Downloading https://files.pythonhosted.org/packages/a5/cf/0d51a15861d944da8463d8c1aecf39cfc6852ea9ecd092046824e9b237b3/Shapely-1.6.4.post1-cp27-cp27mu-manylinux1_x86_64.whl (1.5MB)
    100% |████████████████████████████████| 1.5MB 6.7MB/s
Collecting pyproj
  Downloading https://files.pythonhosted.org/packages/29/72/5c1888c4948a0c7b736d10e0f0f69966e7c0874a660222ed0a2c2c6daa9f/pyproj-1.9.5.1.tar.gz (4.4MB)
    100% |████████████████████████████████| 4.4MB 1.6MB/s
Collecting pynmea2
  Downloading https://files.pythonhosted.org/packages/7c/82/f734e75dbb0aecbd9ea20489f364fdac9f124f17c4d4e26d2ab160c8ff58/pynmea2-1.12.0.tar.gz
Collecting spidev
  Downloading https://files.pythonhosted.org/packages/36/83/73748b6e1819b57d8e1df8090200195cdae33aaa22a49a91ded16785eedd/spidev-3.2.tar.gz
Collecting tornado
  Downloading https://files.pythonhosted.org/packages/cf/d1/3be271ae5eba9fb59df63c9891fdc7d8044b999e8ac145994cdbfd2ae66a/tornado-5.0.2.tar.gz (506kB)
    100% |████████████████████████████████| 512kB 9.5MB/s
    Complete output from command python setup.py egg_info:
    Traceback (most recent call last):
      File "<string>", line 1, in <module>
      File "/tmp/pip-install-IuomJA/tornado/setup.py", line 146, in <module>
        raise ImportError("Tornado requires an up-to-date SSL module. This means "
    ImportError: Tornado requires an up-to-date SSL module. This means Python 2.7.9+ or 3.4+ (although some distributions have backported the necessary changes to older versions).

    ----------------------------------------
**Command "python setup.py egg_info" failed with error code 1 in /tmp/pip-install-IuomJA/tornado/**

So far, I have tried `pip install --user launchpadlib==1.10.2`, as well as updating to Python 3.6.x, and then re-running the installation instruction, but I still get the same errors.

Any help would be much appreciated. Thank you!

Nanoseb, 2018-04-23:
I have seen you have tried the docker image too, I would recommend using that instead of virtual box, it is easier to set up, specially to have a share folder between your computer and the virtual environment.

bryzhao, 2018-04-24:
@takluyver @Nanoseb thanks for the reply. I used `pip install launchpadlib == 1.10.2 --user` to install testresources, and `pip install tornado==4.1 --user` to install a tornado version (older than 5). Changing the bash script to `pip install "tornado<5"` unfortunately did not work for me.

Additionally, I encountered two more errors after running the installation script - in which the packages pigpio and python-pigpio are not located (in bold at the bottom):

Reading package lists... Done
Building dependency tree
Reading state information... Done
bc is already the newest version.
gpsd-clients is already the newest version.
i2c-tools is already the newest version.
libgeos-dev is already the newest version.
python-scipy is already the newest version.
vim is already the newest version.
python-pip is already the newest version.
The following packages were automatically installed and are no longer required:
  cmake cmake-data collada-dom-dev collada-dom2.4-dp-base
  collada-dom2.4-dp-dev freeglut3 gir1.2-gtk-2.0 hddtemp icu-devtools
  liballegro4.4 liballegro4.4-plugin-alsa libapr1-dev libaprutil1-dev
  libassimp-dev libassimp3 libatk1.0-dev libavcodec-dev libavformat-dev
  libavutil-dev libboost-all-dev libboost-atomic-dev libboost-atomic1.54-dev
  libboost-atomic1.54.0 libboost-chrono-dev libboost-chrono1.54-dev
  libboost-chrono1.54.0 libboost-context-dev libboost-context1.54-dev
  libboost-context1.54.0 libboost-coroutine-dev libboost-coroutine1.54-dev
  libboost-date-time-dev libboost-date-time1.54-dev libboost-dev
  libboost-exception-dev libboost-exception1.54-dev libboost-filesystem-dev
  libboost-filesystem1.54-dev libboost-filesystem1.54.0 libboost-graph-dev
  libboost-graph-parallel-dev libboost-graph-parallel1.54-dev
  libboost-graph-parallel1.54.0 libboost-graph1.54-dev libboost-graph1.54.0
  libboost-iostreams-dev libboost-iostreams1.54-dev libboost-iostreams1.54.0
  libboost-locale-dev libboost-locale1.54-dev libboost-locale1.54.0
  libboost-log-dev libboost-log1.54-dev libboost-log1.54.0 libboost-math-dev
  libboost-math1.54-dev libboost-math1.54.0 libboost-mpi-dev
  libboost-mpi-python-dev libboost-mpi-python1.54-dev
  libboost-mpi-python1.54.0 libboost-mpi1.54-dev libboost-mpi1.54.0
  libboost-program-options-dev libboost-program-options1.54-dev
  libboost-program-options1.54.0 libboost-python-dev libboost-python1.54-dev
  libboost-python1.54.0 libboost-random-dev libboost-random1.54-dev
  libboost-random1.54.0 libboost-regex-dev libboost-regex1.54-dev
  libboost-regex1.54.0 libboost-serialization-dev
  libboost-serialization1.54-dev libboost-serialization1.54.0
  libboost-signals-dev libboost-signals1.54-dev libboost-signals1.54.0
  libboost-system-dev libboost-system1.54-dev libboost-test-dev
  libboost-test1.54-dev libboost-test1.54.0 libboost-thread-dev
  libboost-thread1.54-dev libboost-thread1.54.0 libboost-timer-dev
  libboost-timer1.54-dev libboost-timer1.54.0 libboost-tools-dev
  libboost-wave-dev libboost-wave1.54-dev libboost-wave1.54.0 libboost1.54-dev
  libboost1.54-tools-dev libcairo-script-interpreter2 libcairo2-dev
  libcegui-mk2-0.7.6 libcf0 libconsole-bridge-dev libconsole-bridge0.2 libcr0
  libcurl4-openssl-dev libcv-dev libcvaux-dev libdc1394-22-dev libdevil-dev
  libdevil1c2 libeigen3-dev libflann-dev libflann1.8 libfltk1.1 libfltk1.1-dev
  libfreeimage-dev libfreeimage3 libgcrypt11-dev libgdk-pixbuf2.0-dev
  libgl2ps-dev libgl2ps0 libglib2.0-dev libgnomecanvas2-0
  libgnomecanvas2-common libgnutls-dev libgnutlsxx27 libgpg-error-dev
  libgsl0ldbl libgtest-dev libgtk2.0-dev libharfbuzz-dev libharfbuzz-gobject0
  libhdf5-7 libhighgui-dev libhwloc-dev libhwloc-plugins libhwloc5
  libibverbs-dev libibverbs1 libicu-dev libidn11-dev libilmbase-dev
  libjasper-dev libjbig-dev libjpeg-dev libjpeg-turbo8-dev libjpeg8-dev
  libkrb5-dev liblcms1 liblcms1-dev liblcms2-dev libldap2-dev liblodo3.0
  liblog4cxx10 liblog4cxx10-dev liblua5.1-0 liblz4-1 liblz4-dev liblzma-dev
  libmng-dev libmng2 libnetcdf-dev libnetcdfc++4 libnetcdfc7 libnetcdff5
  libodbc1 libogg-dev libogre-1.8-dev libogre-1.8.0 libois-1.3.0
  libopencv-calib3d-dev libopencv-contrib-dev libopencv-core-dev libopencv-dev
  libopencv-features2d-dev libopencv-flann-dev libopencv-gpu-dev
  libopencv-gpu2.4 libopencv-highgui-dev libopencv-imgproc-dev
  libopencv-legacy-dev libopencv-ml-dev libopencv-objdetect-dev
  libopencv-ocl-dev libopencv-ocl2.4 libopencv-photo-dev libopencv-photo2.4
  libopencv-stitching-dev libopencv-stitching2.4 libopencv-superres-dev
  libopencv-superres2.4 libopencv-ts-dev libopencv-ts2.4 libopencv-video-dev
  libopencv-videostab-dev libopencv-videostab2.4 libopencv2.4-java
  libopencv2.4-jni libopenexr-dev libopenmpi-dev libopenmpi1.6 libopenni-dev
  libopenni-sensor-pointclouds0 libopenni0 libp11-kit-dev libpango1.0-dev
  libpci-dev libpcl-1.7-all libpcl-1.7-all-dev libpcl-1.7-bin libpcl-1.7-doc
  libpcl-apps-1.7 libpcl-apps-1.7-dev libpcl-common-1.7 libpcl-common-1.7-dev
  libpcl-features-1.7 libpcl-features-1.7-dev libpcl-filters-1.7
  libpcl-filters-1.7-dev libpcl-geometry-1.7-dev libpcl-io-1.7
  libpcl-io-1.7-dev libpcl-kdtree-1.7 libpcl-kdtree-1.7-dev
  libpcl-keypoints-1.7 libpcl-keypoints-1.7-dev libpcl-octree-1.7
  libpcl-octree-1.7-dev libpcl-outofcore-1.7 libpcl-outofcore-1.7-dev
  libpcl-people-1.7 libpcl-people-1.7-dev libpcl-recognition-1.7
  libpcl-recognition-1.7-dev libpcl-registration-1.7
  libpcl-registration-1.7-dev libpcl-sample-consensus-1.7
  libpcl-sample-consensus-1.7-dev libpcl-search-1.7 libpcl-search-1.7-dev
  libpcl-segmentation-1.7 libpcl-segmentation-1.7-dev libpcl-surface-1.7
  libpcl-surface-1.7-dev libpcl-tracking-1.7 libpcl-tracking-1.7-dev
  libpcl-visualization-1.7 libpcl-visualization-1.7-dev libpcre3-dev
  libpcrecpp0 libphonon4 libpixman-1-dev libplayerc++3.0 libplayerc3.0
  libplayercommon3.0 libplayercore3.0 libplayerdrivers3.0
  libplayerinterface3.0 libplayerjpeg3.0 libplayertcp3.0 libplayerwkb3.0
  libpmap3.0 libpoco-dev libpococrypto9 libpocodata9 libpocofoundation9
  libpocomysql9 libpoconet9 libpoconetssl9 libpocoodbc9 libpocosqlite9
  libpocoutil9 libpocoxml9 libpocozip9 libprotobuf-dev libprotobuf-lite8
  libprotoc8 libpyside-dev libpyside-py3-1.2 libpyside1.2 libqhull-dev
  libqhull6 libqwt-dev libqwt5-qt4 libqwt6 libraw1394-dev libraw1394-tools
  librtmp-dev libsctp-dev libsctp1 libsdformat-dev libsdformat1
  libsdl1.2debian libshiboken-dev libshiboken-py3-1.2 libshiboken1.2 libsilly
  libstatgrab9 libswscale-dev libtar0 libtasn1-6-dev libtbb-dev libtheora-dev
  libtiff5-dev libtiffxx5 libtinyxml-dev libtinyxml2.6.2 libtorque2
  liburdfdom-dev liburdfdom-headers-dev liburdfdom-model-state0.2
  liburdfdom-model0.2 liburdfdom-sensor0.2 liburdfdom-tools
  liburdfdom-world0.2 liburiparser1 libusb-1.0-0-dev libusb-1.0-doc
  libvtk-java libvtk5-dev libvtk5-qt4-dev libvtk5.8 libvtk5.8-qt4 libxaw7-dev
  libxcb-shm0-dev libxcomposite-dev libxcursor-dev libxerces-c3.1 libxi-dev
  libxinerama-dev libxml2-dev libxml2-utils libxmu-dev libxmu-headers
  libxpm-dev libxrandr-dev libyaml-cpp-dev libyaml-cpp0.5 libzzip-0-13
  libzzip-dev lksctp-tools mpi-default-bin mpi-default-dev opencv-data
  openmpi-bin openmpi-common openni-utils phonon phonon-backend-gstreamer
  phonon-backend-gstreamer-common phonon-backend-gstreamer1.0 python-empy
  python-matplotlib python-matplotlib-data python-netifaces python-opencv
  python-opengl python-psutil python-pydot python-pyside python-pyside.phonon
  python-pyside.qtcore python-pyside.qtdeclarative python-pyside.qtgui
  python-pyside.qthelp python-pyside.qtnetwork python-pyside.qtopengl
  python-pyside.qtscript python-pyside.qtsql python-pyside.qtsvg
  python-pyside.qttest python-pyside.qtuitools python-pyside.qtwebkit
  python-pyside.qtxml python-qt4-dev python-qt4-gl python-qwt5-qt4
  python-rosdep python-rospkg python-sip-dev python-support python-tz
  python-urlgrabber python-vtk python-wxtools robot-player
  ros-indigo-actionlib ros-indigo-actionlib-msgs
  ros-indigo-actionlib-tutorials ros-indigo-angles ros-indigo-bond
  ros-indigo-bond-core ros-indigo-bondcpp ros-indigo-bondpy
  ros-indigo-camera-calibration ros-indigo-camera-calibration-parsers
  ros-indigo-camera-info-manager ros-indigo-catkin ros-indigo-class-loader
  ros-indigo-cmake-modules ros-indigo-collada-parser ros-indigo-collada-urdf
  ros-indigo-common-msgs ros-indigo-common-tutorials
  ros-indigo-compressed-depth-image-transport
  ros-indigo-compressed-image-transport ros-indigo-control-msgs
  ros-indigo-cpp-common ros-indigo-cv-bridge ros-indigo-depth-image-proc
  ros-indigo-desktop ros-indigo-diagnostic-aggregator
  ros-indigo-diagnostic-analysis ros-indigo-diagnostic-common-diagnostics
  ros-indigo-diagnostic-msgs ros-indigo-diagnostic-updater
  ros-indigo-diagnostics ros-indigo-driver-base ros-indigo-dynamic-reconfigure
  ros-indigo-eigen-conversions ros-indigo-eigen-stl-containers
  ros-indigo-executive-smach ros-indigo-filters ros-indigo-gazebo-msgs
  ros-indigo-gencpp ros-indigo-genlisp ros-indigo-genmsg ros-indigo-genpy
  ros-indigo-geometric-shapes ros-indigo-geometry ros-indigo-geometry-msgs
  ros-indigo-geometry-tutorials ros-indigo-gl-dependency
  ros-indigo-image-common ros-indigo-image-geometry ros-indigo-image-pipeline
  ros-indigo-image-proc ros-indigo-image-publisher ros-indigo-image-rotate
  ros-indigo-image-transport ros-indigo-image-transport-plugins
  ros-indigo-image-view ros-indigo-interactive-marker-tutorials
  ros-indigo-interactive-markers ros-indigo-joint-state-publisher
  ros-indigo-kdl-conversions ros-indigo-kdl-parser ros-indigo-laser-assembler
  ros-indigo-laser-filters ros-indigo-laser-geometry ros-indigo-laser-pipeline
  ros-indigo-librviz-tutorial ros-indigo-map-msgs ros-indigo-media-export
  ros-indigo-message-filters ros-indigo-message-generation
  ros-indigo-message-runtime ros-indigo-mk ros-indigo-nav-msgs
  ros-indigo-nodelet ros-indigo-nodelet-core ros-indigo-nodelet-topic-tools
  ros-indigo-nodelet-tutorial-math ros-indigo-octomap ros-indigo-orocos-kdl
  ros-indigo-pcl-conversions ros-indigo-pcl-msgs ros-indigo-pcl-ros
  ros-indigo-perception ros-indigo-perception-pcl ros-indigo-pluginlib
  ros-indigo-pluginlib-tutorials ros-indigo-pointcloud-to-laserscan
  ros-indigo-polled-camera ros-indigo-python-orocos-kdl
  ros-indigo-python-qt-binding ros-indigo-qt-dotgraph ros-indigo-qt-gui
  ros-indigo-qt-gui-cpp ros-indigo-qt-gui-py-common ros-indigo-qwt-dependency
  ros-indigo-random-numbers ros-indigo-resource-retriever ros-indigo-robot
  ros-indigo-robot-model ros-indigo-robot-state-publisher ros-indigo-ros
  ros-indigo-ros-base ros-indigo-ros-comm ros-indigo-ros-core
  ros-indigo-ros-tutorials ros-indigo-rosbag ros-indigo-rosbag-migration-rule
  ros-indigo-rosbag-storage ros-indigo-rosbash ros-indigo-rosboost-cfg
  ros-indigo-rosbuild ros-indigo-rosclean ros-indigo-rosconsole
  ros-indigo-rosconsole-bridge ros-indigo-roscpp ros-indigo-roscpp-core
  ros-indigo-roscpp-serialization ros-indigo-roscpp-traits
  ros-indigo-roscpp-tutorials ros-indigo-roscreate ros-indigo-rosgraph
  ros-indigo-rosgraph-msgs ros-indigo-roslang ros-indigo-roslaunch
  ros-indigo-roslib ros-indigo-roslint ros-indigo-roslisp ros-indigo-roslz4
  ros-indigo-rosmake ros-indigo-rosmaster ros-indigo-rosmsg ros-indigo-rosnode
  ros-indigo-rosout ros-indigo-rospack ros-indigo-rosparam ros-indigo-rospy
  ros-indigo-rospy-tutorials ros-indigo-rosservice ros-indigo-rostest
  ros-indigo-rostime ros-indigo-rostopic ros-indigo-rosunit ros-indigo-roswtf
  ros-indigo-rqt-action ros-indigo-rqt-bag ros-indigo-rqt-bag-plugins
  ros-indigo-rqt-common-plugins ros-indigo-rqt-console ros-indigo-rqt-dep
  ros-indigo-rqt-graph ros-indigo-rqt-gui ros-indigo-rqt-gui-cpp
  ros-indigo-rqt-gui-py ros-indigo-rqt-image-view ros-indigo-rqt-launch
  ros-indigo-rqt-logger-level ros-indigo-rqt-moveit ros-indigo-rqt-msg
  ros-indigo-rqt-nav-view ros-indigo-rqt-plot ros-indigo-rqt-pose-view
  ros-indigo-rqt-publisher ros-indigo-rqt-py-common ros-indigo-rqt-py-console
  ros-indigo-rqt-reconfigure ros-indigo-rqt-robot-dashboard
  ros-indigo-rqt-robot-monitor ros-indigo-rqt-robot-plugins
  ros-indigo-rqt-robot-steering ros-indigo-rqt-runtime-monitor
  ros-indigo-rqt-rviz ros-indigo-rqt-service-caller ros-indigo-rqt-shell
  ros-indigo-rqt-srv ros-indigo-rqt-tf-tree ros-indigo-rqt-top
  ros-indigo-rqt-topic ros-indigo-rqt-web ros-indigo-rviz
  ros-indigo-rviz-plugin-tutorials ros-indigo-rviz-python-tutorial
  ros-indigo-self-test ros-indigo-sensor-msgs ros-indigo-shape-msgs
  ros-indigo-smach ros-indigo-smach-msgs ros-indigo-smach-ros
  ros-indigo-smclib ros-indigo-stage ros-indigo-stage-ros ros-indigo-std-msgs
  ros-indigo-std-srvs ros-indigo-stereo-image-proc ros-indigo-stereo-msgs
  ros-indigo-tf ros-indigo-tf-conversions ros-indigo-tf2
  ros-indigo-tf2-geometry-msgs ros-indigo-tf2-kdl ros-indigo-tf2-msgs
  ros-indigo-tf2-py ros-indigo-tf2-ros ros-indigo-tf2-sensor-msgs
  ros-indigo-theora-image-transport ros-indigo-topic-tools
  ros-indigo-trajectory-msgs ros-indigo-turtle-actionlib ros-indigo-turtle-tf
  ros-indigo-turtle-tf2 ros-indigo-turtlesim ros-indigo-urdf
  ros-indigo-urdf-parser-plugin ros-indigo-urdf-tutorial
  ros-indigo-vision-opencv ros-indigo-visualization-marker-tutorials
  ros-indigo-visualization-msgs ros-indigo-visualization-tutorials
  ros-indigo-viz ros-indigo-webkit-dependency ros-indigo-xacro
  ros-indigo-xmlrpcpp sbcl shiboken sip-dev tango-icon-theme tcl-vtk
  ttf-dejavu-core uuid-dev x11proto-composite-dev x11proto-randr-dev
  x11proto-xinerama-dev
Use 'apt-get autoremove' to remove them.
0 upgraded, 0 newly installed, 0 to remove and 298 not upgraded.
Installing Python packages...
The directory '/home/bryanz/.cache/pip/http' or its parent directory is not owned by the current user and the cache has been disabled. Please check the permissions and owner of that directory. If executing pip with sudo, you may want sudo's -H flag.
The directory '/home/bryanz/.cache/pip' or its parent directory is not owned by the current user and caching wheels has been disabled. check the permissions and owner of that directory. If executing pip with sudo, you may want sudo's -H flag.
/home/bryanz/.local/lib/python2.7/site-packages/pip/_vendor/urllib3/util/ssl_.py:339: SNIMissingWarning: An HTTPS request has been made, but the SNI (Subject Name Indication) extension to TLS is not available on this platform. This may cause the server to present an incorrect TLS certificate, which can cause validation failures. You can upgrade to a newer version of Python to solve this. For more information, see https://urllib3.readthedocs.io/en/latest/advanced-usage.html#ssl-warnings
  SNIMissingWarning
/home/bryanz/.local/lib/python2.7/site-packages/pip/_vendor/urllib3/util/ssl_.py:137: InsecurePlatformWarning: A true SSLContext object is not available. This prevents urllib3 from configuring SSL appropriately and may cause certain SSL connections to fail. You can upgrade to a newer version of Python to solve this. For more information, see https://urllib3.readthedocs.io/en/latest/advanced-usage.html#ssl-warnings
  InsecurePlatformWarning
Requirement already up-to-date: pip in ./.local/lib/python2.7/site-packages (10.0.1)
The directory '/home/bryanz/.cache/pip/http' or its parent directory is not owned by the current user and the cache has been disabled. Please check the permissions and owner of that directory. If executing pip with sudo, you may want sudo's -H flag.
The directory '/home/bryanz/.cache/pip' or its parent directory is not owned by the current user and caching wheels has been disabled. check the permissions and owner of that directory. If executing pip with sudo, you may want sudo's -H flag.
Requirement already satisfied: Latlon in /usr/local/lib/python2.7/dist-packages (1.0.2)
Requirement already satisfied: shapely in /usr/local/lib/python2.7/dist-packages (1.6.4.post1)
Requirement already satisfied: pyproj in /usr/local/lib/python2.7/dist-packages (1.9.5.1)
Requirement already satisfied: pynmea2 in /usr/local/lib/python2.7/dist-packages (1.12.0)
Requirement already satisfied: spidev in /usr/local/lib/python2.7/dist-packages (3.2)
Requirement already satisfied: tornado in ./.local/lib/python2.7/site-packages (4.1)
Requirement already satisfied: pi_ina219 in /usr/local/lib/python2.7/dist-packages (1.1.0)
Requirement already satisfied: certifi in ./.local/lib/python2.7/site-packages (from tornado) (2018.4.16)
Requirement already satisfied: backports.ssl-match-hostname in ./.local/lib/python2.7/site-packages (from tornado) (3.5.0.1)
Requirement already satisfied: mock in /usr/local/lib/python2.7/dist-packages (from pi_ina219) (2.0.0)
Requirement already satisfied: Adafruit-GPIO in /usr/local/lib/python2.7/dist-packages (from pi_ina219) (1.0.3)
Requirement already satisfied: six>=1.9 in ./.local/lib/python2.7/site-packages (from mock->pi_ina219) (1.11.0)
Requirement already satisfied: funcsigs>=1; python_version < "3.3" in /usr/local/lib/python2.7/dist-packages (from mock->pi_ina219) (1.0.2)
Requirement already satisfied: pbr>=0.11 in ./.local/lib/python2.7/site-packages (from mock->pi_ina219) (4.0.2)
Requirement already satisfied: adafruit-pureio in /usr/local/lib/python2.7/dist-packages (from Adafruit-GPIO->pi_ina219) (0.2.1)
Setting UART frequency...
Setting timezone...
Installing pigpio from apt...
Reading package lists... Done
Building dependency tree
Reading state information... Done
**E: Unable to locate package pigpio
E: Unable to locate package python-pigpio**

Also, @Nanoseb, could you elaborate on what you mean for using the docker image instead of the virtual box? Currently, I have tried launching the ROS simulator nodes from the docker image, which I access within my virtual machine, but the ROS nodes fail.

Any ideas would be appreciated :)

takluyver, 2018-04-24:
Looking at that setup script, I think it's maybe only meant to run on the raspberry pi - it installs a number of packages for interfacing with hardware (like pigpio, pi_ina219, i2c_tools, spidev...). We should make that clearer in the naming and/or description.

The whole setup scripts folder probably needs tidying up - there are several scripts that haven't been touched in a couple of years and are probably outdated. And it's not clear what is meant to run where, or in what order.

What failures do you see when you try to launch the simulator in the docker container? Sorry if you already posted this elsewhere - I get a lot of emails and github notifications. :-)

tsaoyu, 2018-04-24:
@takluyver are you mention [this](https://downloads.ubiquityrobotics.com/pi.html)?

takluyver, 2018-04-24:
Thanks, that was what I was thinking of. It looks like they also have a VM image, but there are no obvious details on what versions of things it has. https://downloads.ubiquityrobotics.com/vm.html

Closed 2018-09-02.

Thread 236 (2018-04-23):

Update Wiki documentation

Nanoseb, 2018-04-23:
I went through the wiki here is the list of pages that needs updating:

- [ ] [Naming convention](https://github.com/Maritime-Robotics-Student-Society/sailing-robot/wiki/Naming-conventions)
- [ ] [Install ROS](https://github.com/Maritime-Robotics-Student-Society/sailing-robot/wiki/Install-of-ROS): install Kinetic instead, or just redirect to ROS documentation
- [ ] [Using the repository](https://github.com/Maritime-Robotics-Student-Society/sailing-robot/wiki/Using-the-repository): talk about post install scripts
- [ ] [2D plot of the boat](https://github.com/Maritime-Robotics-Student-Society/sailing-robot/wiki/Rviz:-2D-plot-of-our-boat): Add the new 2D plot thing using matplot
- [ ] [Rosbag analysis](https://github.com/Maritime-Robotics-Student-Society/sailing-robot/wiki/ROS-bag-analysis): add more things there
- [ ] [Electronic-hardware-list](https://github.com/Maritime-Robotics-Student-Society/sailing-robot/wiki/Electronic-hardware-list): update the list with new GPS and IMU (Xsens)
- [ ] [Schematic-diagram](https://github.com/Maritime-Robotics-Student-Society/sailing-robot/wiki/Schematic-diagram): update with GPS using i2c and usb on top of the mast
- [ ] [Naming convention](https://github.com/Maritime-Robotics-Student-Society/sailing-robot/wiki/Naming-conventions): needs a huge update I think, no one is using this page anymore because it is not uptodate (maybe replace it by a automatically generated version)
- [ ] [Pre sail Raspi setup](https://github.com/Maritime-Robotics-Student-Society/sailing-robot/wiki/Pre-sail-Raspi-setup): seems quite old, probably needs updating
- [ ] [Push to pi](https://github.com/Maritime-Robotics-Student-Society/sailing-robot/wiki/Git-Push-on-Raspberry-(offline-Git)): use the script in piaccess instead
- [ ] [Utililty scripts](https://github.com/Maritime-Robotics-Student-Society/sailing-robot/wiki/Utility-scripts): add an intro, this page is a bit unclear I think, and add other scripts from the utility folder
- [ ] [Itchen-Lake-Water-Test](https://github.com/Maritime-Robotics-Student-Society/sailing-robot/wiki/Itchen-Lake-Water-Test): We have lost the image?

PS: To those using the WIKI (@bryzhao ?), if a page is listed here it is not fully up to date ;)

bryzhao, 2018-04-24:
Thank you @Nanoseb!

Nanoseb, 2018-05-17:
This is **really** good! thanks a lot!
A couple of things could maybe be improved, but it is already very good:
- mention that M3/CH3 is the rudder and M1/CH1 the sail servo
- Say that the white rectangle on the right is a usb connector
- name pins 1 and 8 like the other in the waterproof connector
- repeat M1/M3/FEEDBACK/GND on the right side of the waterproof connector
- name the pins on the 4 pin wp connector (but I guess you need to have the actual part in front of you for that)
- Mention the voltage of the battery pack maybe?
- Above each picture give the component/part number
- Maybe name the pins on the IMU and on the multiplexer, I think it would help understanding what they do

Thanks again for this (and if you don't have time right now to do these modifications that's all right, it can wait a couple of weeks)

Nanoseb, 2018-05-25:
I've updated the wiki with the wiring, I had to export a .png though, because svg on wiki doesn't accept images embedded in the svg...

Thread 238 (2018-04-28):

Using the repository - launching nodes

bryzhao, 2018-04-28:
Hi Soton team,

Hope you are all doing well.

We have now installed ROS Kinetic on our Pi (3), and I have tried following the steps from the documentation up until the "launching nodes" step under the "Using repository" section.

The post-installation setup step to install the dependencies (~/sailing-robot/utilities/setup_scripts/Install_needed_packages.sh) only yielded 1 error this time, for the missing "testresources" package, so I simply used `pip install launchpadlib==1.10.2 --user` and solved the problem that way. The installation script worked fine after that.

All of the other steps worked nicely up until I tried running: `roslaunch sailing_robot test-all-systems.launch`, under the [Using repository](https://github.com/Maritime-Robotics-Student-Society/sailing-robot/wiki/Using-the-repository) step. I got these following errors:

auto-starting new master
process[master]: started with pid [32289]
ROS_MASTER_URI=http://localhost:11311

setting /run_id to 90088a72-4a86-11e8-b01f-b827eb67a500
process[rosout-1]: started with pid [32302]
started core service [/rosout]
process[dummy_apparent_wind-2]: started with pid [32319]
process[dummy_heading-3]: started with pid [32320]
process[dummy_position-4]: started with pid [32321]
**ERROR: cannot launch node of type [sailing_robot/heading_control]: can't locate node [heading_control] in package [sailing_robot]**
process[tack-6]: started with pid [32322]
process[actuator_demand_rudder-7]: started with pid [32323]
**ERROR: cannot launch node of type [rosserial_python/serial_node.py]: rosserial_python
ROS path [0]=/opt/ros/kinetic/share/ros
ROS path [1]=/home/sailboat/sailing-robot/src
ROS path [2]=/opt/ros/kinetic/share**

I was wondering – what exactly does launching the nodes do? Am I able to launch the nodes even if there is no hardware attached to the Pi?
We have our own hardware design (using an Arduino Mega, anemometer, RPi, GPS, XBee modules), but are wondering if the code provided by the Southampton team is adaptable or easily changed to fit another set of similar hardware components.

Thank you all!

takluyver, 2018-04-28:
I would start with `simulation.launch` rather than `test-all-systems.launch`. You can see the different [launch files in this folder](https://github.com/Maritime-Robotics-Student-Society/sailing-robot/tree/master/src/sailing_robot/launch). Any that are under 'archive' (like `test-all-systems.launch`) may well not work any more. It's not guaranteed that the others work either, but there's a better chance.

Inside a launch file, there are a bunch of lines like this:

```xml
<node name = "simulation_position" pkg='sailing_robot' type="simulation_position"/>
```

The `type=` part will generally correspond to the name of a file in [the scripts folder](https://github.com/Maritime-Robotics-Student-Society/sailing-robot/tree/master/src/sailing_robot/scripts).

If we've got things right, only the nodes called `sensor_driver_*` and `actuator_driver_*` talk to the hardware. Where your hardware differs from ours, you may need to write/find different 'driver' nodes for that. The other nodes, which do all the calculation and decision making, work by sending and receiving ROS messages. A sensor driver node (like `sensor_driver_gps`) gets a reading from the sensor and sends out one or more ROS messages to other nodes. At the other end, an actuator driver node listens for relevant ROS messages and uses them to update the servo PWM.

The simulation launch file doesn't use any driver nodes, so it's a good way to test that you've got ROS and the control nodes working before you start trying to integrate it with hardware.

Nanoseb, 2018-09-02:
Closing this now, I think it is clarified.

Closed 2018-09-02.

Thread 239 (2018-04-29):

usbip setup failure

Nanoseb, 2018-04-29:
So today we tried to use the `usbip-bind.sh` script, and... it fails ;)

Here is the error we got:
```
SSH-ing to Pi to set up usbip export...
pi
Bus ID: 1-1.5
[sudo] password for pi:
usbip: info: bind device on busid 1-1.5: complete
Connection to 192.168.12.1 closed.
Attaching [-r 192.168.12.1 -b 1-1.5]
libusbip: error: udev_device_new_from_subsystem_sysname failed
usbip: error: open vhci_driver
usbip: error: query
```
We will try to investigate that during next meeting, @takluyver maybe you have an idea of the source?

takluyver, 2018-04-29:
There's some kernel module that you need loaded on Tabarly (or whatever computer you're trying to use). Try `sudo modprobe vhci-hcd` first. If that's not it, try tab completing after `vhci`, because I think it started with that.

takluyver, 2018-04-29:
I hope that's it, I'm not 100% sure. I think there are different modules that need to be loaded on each end of the connection.

Nanoseb, 2018-04-29:
ok, we will try on Tuesday, we went for the cable link today after trying a couple of times. Probably worth loading these modules in the script in case they are not loaded beforehand so that it is easier to operate.

tsaoyu, 2018-04-30:
Sure, we can try this on Tuesday.

Closed 2018-05-01.

Thread 240 (2018-04-30):

Rosbag duration in index_recorded_data.py

Nanoseb, 2018-04-30:
In the generated html some durations are quite off, for example the bag from the 4th of September 2017 "14:49:47 [horten_fleetrace]" lasted only 1 minute but seems to be [a bit longer](https://www.southampton.ac.uk/~yc6n13/sailing-robot/) ;)

takluyver, 2018-04-30:
Here's where it comes from: https://github.com/Maritime-Robotics-Student-Society/sailing-robot/blob/cbc725bc4fd7d0179e137f39b63acd2908a11e4c/utilities/index_recorded_data.py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

Nanoseb, 2018-05-16:
maybe related to https://github.com/ros/ros_comm/issues/952

Nanoseb, 2018-06-17:
Ok the issue is more scary than that :/
The time is ok because the bagfile is not complete, 14:49:47 [horten_fleetrace] for example should be quite long but it lasts 1min and weight 13M... so we've lost some data.

takluyver, 2018-06-17:
Sometimes we get `.bag.active` files - I think when ROS isn't shut down cleanly. We copied [some code we found](https://answers.ros.org/question/40116/rosbag-file-cannot-be-made-bagactive/?answer=220958#post-id-220958) to fix them up into usable .bag files, but I haven't looked into what it's doing. I assumed you lost some data in that case, but I would have expected it to be the last couple of minutes rather than most of your run.

If the Raspi lost power while ROS was running, that may cause further data loss - data written to file will initially be cached in volatile memory, so it can still be lost on a power failure. Maybe the system caches writes quite heavily to minimise write cycles on the flash storage.

If I found the time, I'd love to dig into this issue more. If Rosbag is doing something that fails badly when it loses power, a better recording system could be really valuable to a lot of projects.

smaria, 2018-11-09:
Interesting. i was under the assumption the map plots are generated from the bags. However, looking at /dbg_distance_to_waypoint for 14:49:47 [horten_fleetrace], no waypoint is reached. Where does the complete plotted triangle race come from, if not from said bag?

(as a side note, it is rather inconvenient that the message types recorded in a rosbag are not contained in the bag, I currently don't have a workspace for sailrobot at hand, and it does put a question mark on data longevity, so I can't easily look at the actual gps data)

Nanoseb, 2018-11-09:
Map plots are generated thanks to the dump of the gps trace (.csv file formatted according to the rules). See https://www.southampton.ac.uk/~yc6n13/sailing-robot/gps-trace_horten_fleetrace_2017-09-04T14.49.52.csv

smaria, 2018-11-12:
Thanks for explaining.
It seems to be accepted that rosbag drops messages if the storage device is not fast enough.
https://answers.ros.org/question/240948/rosbag-record-dropping-and-corrupting-data/
That seems an unlikely reason for our problem, both considering the low amount of data we generate and that the rosbag just stops rather than missing a couple of messages.

It may be worth setting the rosbag recording node to respawn, at least in the model launch file this is not the case: https://github.com/Maritime-Robotics-Student-Society/sailing-robot/blob/master/src/sailing_robot/launch/model_launch_file.launch

This won't get us to the bottom of this, but should this be due to rosbag crashing, the next time it happens we should notice two bags being recorded and we will only miss a smaller amount of data. Is it possible to dig out the ROS log files from that date? Is there any chance this rosbag is not the correct one for the map data?

There is also one more unsolved report of rosbag dropping data: https://answers.ros.org/question/62833/rosbag-not-recording-every-message/

takluyver, 2018-11-12:
At the moment the indexing uses the rosbag to define when a run starts and ends. If the recording restarts, you'll likely see an extra run in the index without the GPS trace or parameter dump. (Or the indexing might crash if it assumes the GPS trace is there). I'm sure there are ways to work round that.

Thread 241 (2018-05-09):

Generate PDF from wiki

Nanoseb, 2018-05-09:
To be able to print the wiki more easily I've added a script in the wiki repository to generate pdfs. It uses pandoc at the moment, it can probably be improved (removing the large margins for example).

I am opening this issue if people here have better ideas to do that, or to improve this.

Thread 242 (2018-05-10):

Multiplexer Wiring

jordanjj8, 2018-05-10:
Hi Southampton Team,

We are going to take on your guy's advice and use a multiplexer for our system :)

We were just wondering, how did you guys wire up and use the multiplexer? (specifically, how did you wire up a switch on the transmitter and for it to switch modes on the multiplexer side?)

Possibly a wiring diagram would help us very much! Thank you again and hope to hear from you soon!

Best,
UC Davis Sailing Robotics Team

Nanoseb, 2018-05-10:
Hi,
Is this page clear enough? https://github.com/Maritime-Robotics-Student-Society/sailing-robot/wiki/Schematic-diagram#for-the-multiplexer

It should have all the information needed, the selector is  wired on channel 5 of our remote control.
M1-4 are "master" so the raspberry pi in our case and S1-4 are the slave input (the remote control). This is done that way in order to have the master controlling the servos when the remote is out of range by the boat.
Servos are connected to OUT1-4 (1 and 3 in our case)

Nanoseb, 2018-05-10:
Oh sorry I didn't read your question carefully enough, we don't wire anything on the remote, our remote have a large number of channels (I would say 8), we have 4 switches we can use for that on our remote. The switch on the remote changes the value of channel 5 on the receiver that is read by the multiplexer.

jordanjj8, 2018-05-11:
Thank you for the post. Much appreciated.

What was your channel 5 (channel that controls the SEL) ? Was it a simple switch?

Also, did you have to do any multiplexer calibrating?

Nanoseb, 2018-05-31:
I think the question have been answered, I am closing this issue. Feel free to open a new one if needed.

Closed 2018-05-31.

Thread 245 (2018-05-15):

USB camera wiring to the pi

Nanoseb, 2018-05-15:
The raspberry pi doesn't have enough space to plug the camera via usb.
We probably need to cut the box a bit more (or get a larger box)

Closed 2018-09-01.

Thread 246 (2018-05-16):

Investigate Xsens node death and respan

Nanoseb, 2018-05-16:
During last week end test, the xsens IMU died several times and the node rebooted itself. This leads to
30-40s without heading reading which is not great.
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

The 1st step will probably be to keep the IMU running for a while and see when it happens.

Nanoseb, 2018-06-17:
this happened again during last test... will need investigation...

Thread 250 (2018-05-31):

Test of helming node

Nanoseb, 2018-05-31:
This test will be done to try the helming node in more depth here are things to do/remember especially for this test:

- [ ] For setting the waypoints, make sure there is a "long" upwind leg
- [ ] Read the [Helming node](https://github.com/Maritime-Robotics-Student-Society/sailing-robot/wiki/Helming-node) wiki page, specially the description of the parameters
- [ ] Test only with `jibe_to_turn: false`, it is less interesting if it is set to true
- [ ] Test several values for the `exploration_coefficient`, maybe start with 0.3 for example and then a test with 0.9 and one with 0.
- [ ] If the boat always fails its tacks you can increase the timeout.

Not related to the helming node, but to remember for this test:
- [ ] Print the new version of the [checklist](https://github.com/Maritime-Robotics-Student-Society/sailing-robot/wiki/Checklists) and follow it ;) (it has been updated)
- [ ] Prepare some wiring for the old GPS module (the one with the antenna) in case you see jumps in position again (you can even directly try the old module, it should work better then the other one)
- [ ] Try to record what is happening as often as possible with the `~/sailing-robot/recorded_data/notes/log_timed_note.py` script (on tabarly or else)
- [ ] Make sure you don't have `<node name = "sensor_driver_imu" pkg="sailing_robot" type="sensor_driver_imu"  respawn="true"/>` in the launch file (this is not used since we have the xsens imu, it will crash because the old minimu is not wired)

Nanoseb, 2018-09-01:
Tested during the competition \o/

Closed 2018-09-01.

Thread 257 (2018-08-31):

After competition replacement and repair list

tsaoyu, 2018-08-31:
Replacement:

- [ ] Water damaged RPi
- [ ] SD card

Repair:

- [ ] Loose keel
- [ ] Pulling string on sail
- [ ] USB extension & battery sensor

Nanoseb, 2018-09-02:
- [ ] 3D printed wind sensor

Thread 259 (2018-09-12):

Display warning when clock is not set

Nanoseb, 2018-09-12:
It is a pain to correct the timestamp even with the adjust.py. It would be better if we remember to set it in the first place...
Having a warning on the PS1 when the clock is not set will help not forgetting that.

takluyver, 2018-09-12:
I don't think the Pi knows when its clock is wrong, though it could have a flag that is set at boot and cleared when you update the clock.

It might also be worth looking into getting a real-time clock module - see previous discussion in #175. I think we found that the GPS unit has a RTC in it, but it needs a small battery attached. Then we'd also have to set up some service on the Pi to use it.

Nanoseb, 2018-09-12:
What we've noticed I think is that we are never in the future. So something I thought about was to record in a file the time and do something like:
```
if current_time > stored_time:
    store current_time in stored_time
else:
    print warning time not set correctly
```
But the flag idea is good too and probably even better than that.

Concerning the RTC clock in the GPS, I didn't know that, worth looking into it too.

takluyver, 2018-09-12:
My understanding is that it saves the current time on shutdown and restores it on boot - so the clock's not going backwards, it's just 'stuck' while there's no power. If that's the case, then your check wouldn't see a clock reading earlier than its saved time. Although maybe it would work when there's a hard shutdown - I don't know if the Pi can save its clock in that case.

Nanoseb, 2018-09-12:
Ah indeed, in that case your solution is definitely better. I think it saves the clock only when you power it off cleanly (not unplug it), because for example in calshot, we set the clock correctly on thursday, but it was off again on friday.
Anyway your for now (without new hardware) your flag solution is better, I'll try to implement that if when/if I have time (anyone else can do it if I haven't done it already).

smaria, 2018-11-09:
NTP sounds like the most elegant solution for this sort of thing, but at least I failed to set this up for delphin. May be worth adding an automated update via SSH, based on something like this: https://www.commandlinefu.com/commands/view/9153/synchronize-date-and-time-with-a-server-over-ssh

Catching up on issues, it seems several issues we have (checking that the time is set, maybe even setting it by trying to ssh to tabarly, getting everything named with the date as a prefix) could be solved by packing the ros script inside a bash script, which will check on a couple of things before actually launching anything.

Nanoseb, 2018-11-09:
We have a similar command in `time2pi.sh` (https://github.com/Maritime-Robotics-Student-Society/sailing-robot/blob/master/piaccess/time2pi.sh).

Concerning NTP, in the special case of the sailing robot I don't think it is a particularly elegant solution. The boat will periodically ask for the time to a server (tabarly?) (and we can force a sync too). So this means that we need to set up tabarly as a ntp server, this also mean that if for any reason tabarly is not available during the setup then getting the time is harder. NTP is nice for system that are constantly connected to internet/an ntp server. The gain of NTP compared to the SSH command is just precision, but I don't think that is really relevant in our case.

How I see it for now:
- if GPS available we should get the time from there
- as a fall back we set the time from the SSH command in `time2pi.sh` or a reversed version of it (`timefromtabarly.sh`?)

And I agree that making this automatic would be a good improvement, maybe just wrapping roslaunch in a bash script that does a couple of checks and set up as you mentioned is a way to go. Then we still only handle and edit one file (the launchfile.xml) but there is automatic checks before actually running `roslaunch launchfile.xml`.

Thread 260 (2018-09-12):

Restructure recorded_data folder

Nanoseb, 2018-09-12:
For now all the logs are in the same folder, which lead to 1300 files in one place. The filenames not starting with the timestamp but their content (like param-dump) is not helping the sorting.
To improve that I thought about having a folder per launch with the name: `2018-08-28T12.41.55-calshot-triangular-race`
And then in it:
- `rosbag.bag`
- `param-dump.json`
- `gps-raw-nmea`
- `gps-trace.csv`
- `map-gps-trace.html`
- `rosbag.bag.metadata`

When/If we changes this file structure it will lead to adapting the launch files that stores bags etc. as well as the `index_recorded_data.py` script that generates the html page and .metadata.

takluyver, 2018-09-12:
The index was designed to alleviate this a bit, but I agree that it would make sense to arrange the files into folders as well.

Nanoseb, 2018-09-12:
Also having this kind of folder structure means that we can have a script that easily in one command: run roscore, load the parameter dump, play the rosbag and launch the 2D visualisation for example. Which is tedious at the moment because each file has a different name structure.

Nanoseb, 2018-09-12:
What needs to be edited:
- [ ] path/filename in script/debugging_dump_params
- [ ] path/filename in script/debugging_gps_log
- [ ] path/filename in launchfile.launch (rosbag record line)
- [ ] path/filename in script/sensor_driver_gps for raw-nmea file

One of the difficult aspect here is to have a consistent timestamp that is propagated and used by all the files (=how to set a parameter with the timestamp of the beginning of the launch)

And also:
- [ ] `index_recorded_data.py` file handling

- [ ] write a one time script to convert the old file structure to the new one (part of index_recorded_data.py can be reused to associate file belonging to the same mission together)

smaria, 2018-11-09:
IIRC there is no easy way of making rosbag record append a postfix rather than using a prefix. For Delphin2 I ended up using a bash script for launching, which recorded the start time and then handled all the naming at the end.

Thread 261 (2018-10-19):

Xsense position investigating

CamilV, 2018-10-19:
The Xsense is the sensor that reads the boat's heading. Currently is placed on top of the Pi, below the battery, where the electromagnetic interference is quite bad (recalibration of the Xsense is required before every launch). It might be possible to move in a position in which electromagnetic interference is not as bad so that calibration would not be required so often

livid-fpv, 2018-10-20:
Conformal coat it and put it higher up on top of the mast?

CamilV, 2018-10-20:
On the top of the mast we already have the GPS and the wind sensor, there's quite a lot of magnetic interference up there. Conformal coat might be something worth considering

ReFil, 2018-10-20:
put it at the rear of the boat on a little post maybe?

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

Thread 262 (2018-10-19):

New Pi box

CamilV, 2018-10-19:
The Pi requires a new (waterproof) box

Spoyl, 2018-10-19:
We could 3-d print a case with ABS instead of using tupperware. Thick walls with solid infill should prevent water getting in.

CamilV, 2018-10-19:
I was thinking of a 3D printed case as well, the only concern I have about it is how are we going to secure the lid on it in such a way that it would be waterproof

livid-fpv, 2018-10-20:
Silicone caulking is the easiest, or a groove and an 0-ring is reusable, i'd recommend a layer of marine epoxy or waterproof wood glue on the inside, it's very hard to get naturally waterproof 3d prints

Thread 263 (2018-10-19):

1 battery to power the entire boat

CamilV, 2018-10-19:
Currently, the Pi is powered with a USB Powerbank and the servos are powered from 4 AA batteries. I'm thinking, powering the whole boat from a single 2S LiPo or something close to that, might be possible and it would facilitate test preparation and simplify the wiring

CamilV, 2018-10-20:
Why would you recommend a 4S? The Pi requires a power supply of 5V and the servos work well with voltage levels as low as 4.5V. My idea was to step down the voltage with a buck converter to power the Pi, ensuring a constant 5V supply and have another buck converter to power the servos.  The maximum current we saw being drawn by the servos was about 800mA, which would result in almost no voltage drop across the battery.

ReFil, 2018-10-20:
If something goes wrong and you need to keep power up you have more margin
to discharge a 4s below its rated voltage maintaining 5v for the supply. A
2s would work, but for stuff I do, I always have a nice big margin. also if
you use an 18650 pack for better energy density you'd need at least a 3s as
18650 cut off voltage is around 2.5v per cell depending on the cells you
choose

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

Thread 264 (2018-10-19):

HM6343 IMU

CamilV, 2018-10-19:
If Xsense proves to be too difficult to deal with, would the HM6343 IMU be a good replacement?

Thread 265 (2018-10-19):

Fish finder reverse engineering

CamilV, 2018-10-19:
Not required for the competition, but would be nice to reverse engineer a fish finder to send information such as water temperature, pH, depth, salinity and anything else that might turn our boat into a research vessel.

Something like this:
https://www.beschoi.com/05a00042r-smart-portable-depth-fish-finder-with-100-m-wireless-sonar-sensor-echo-sounder-fishfinder-for-lake-sea-fishing.html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

livid-fpv, 2018-10-20:
Most fishfinders do not have pH or salinity probes, they typically have only water temperature and depth, but there are many that speak publicly known protocols, usually NMEA 0182 or NMEA 2000, so getting the data that they do provide isn't impossible

smaria, 2018-11-09:
interesting that this fish finder would come up here :) I don't think it records anything but water temperature. Recordings were made with an SDR and this fish finder. However, in the swimming pool the recordings were made in, it appears the surrounding noise was louder than the ping of the fish finder itself. Ping me if anyone ends up looking into this (or wired fish finders).

Thread 266 (2018-10-19):

New wind sensor integration

CamilV, 2018-10-19:
The ultrasonic wind sensor that we won at the competition needs to be integrated into the boat to make use of it. Together with this, the wiring to the mast would need changing to accommodate the serial connection required for this and the power supply level (~7V if I remember correctly)

smaria, 2018-11-09:
Do we really want to place a sensor this large/heavy at the top of the Black Python? I would suggest testing it land based first. My dream use of this sensor would be a sailability boat via Mike, mounted with a suction cup at the front of the vessel... :)

Thread 268 (2018-10-19):

Temporary wind sensor fix

CamilV, 2018-10-19:
Our current wind sensor broke, rebuilding it requires 3D printing some of its parts. Would be nice to have as a spare

Spoyl, 2018-10-19:
I can take a look at this - do you have the stls?

CamilV, 2018-10-19:
https://github.com/Maritime-Robotics-Student-Society/Boat-construction/tree/master/Wind_Vane/v3

This should be the most up to date Solidworks model that we have. The assembly should work, let me know if you have any issues with it.

Thread 275 (2019-11-15):

Archive of old sailing logs

takluyver, 2019-11-15:
If anyone's still working on the sailing robot project and could use it: I have an archive of old data recorded from sailing the Black Python in 2016, 2017 and 2018, including a mixture of test runs and competition runs at those years' WRSCs. I'm happy to hand this on.

The data collected includes:

- ROSbags: a log of all ROS messages during the run, can be replayed in ROS tools
- GPS traces: CSV files with GPS coordinates (there are scripts/notebooks in the repo which can plot these on a map)
- Parameter dumps: JSON files recoding all the [parameters](https://github.com/Maritime-Robotics-Student-Society/sailing-robot/tree/master/src/sailing_robot/launch/parameters) in use each time we launched ROS.

This totals about 1.7 GB zipped, and 8 GB decompressed.

takluyver, 2019-12-20:
I discussed with @smaria the possibility of publishing this data on [Zenodo](https://zenodo.org/) or some similar archive. I've prepared a README for it, which I'll paste in below.

Would anyone rather I don't do this? Do you think another data repository would be better than Zenodo? Do you want to suggest changes to the README? If there are no objections, I'll publish this some time after Christmas.

-----
Readme text:

# Sailing Robot Logs

These files contain recorded data from the [Southampton Sailing Robot Team](https://www.sotonsailrobot.org/)'s boat, the *Black Python*. The logs cover various tests, and three [WRSC](https://www.roboticsailing.org/) competitions: 2016 (`viana`), 2017 (`horten`) and 2018 (`calshot`).

Each test run generated several files:

- `.bag` and `.bag.metadata`: [Rosbag](https://wiki.ros.org/Bags) files, recordings of messages sent among parts of the control system, which was built in the ROS 1.x framework. ROS includes tools to inspect and replay these files.
- `params-dump-*.json`: JSON dumps of the parameters used to launch that run, including waypoint GPS coordinates and sensor calibration parameters, among other values.
- `gps-trace*.csv`: GPS coordinates of the boat during the run, in the format required by WRSC. The three columns are timestamp (`hhmmssdd`), latitude and longitude both converted to integers by multiplying decimal degrees by 1e7, i.e. shifting the decimal point 7 places to the right. All GPS coordinates use the WGS-84 reference.
  - `gps-raw-nmea*`: Raw NMEA 0183 protocol data sent by the GPS receiver. This should be redundant with the CSV data so long as it was parsed correctly.
  - `map-gps-trace*.html`: GPS traces plotted in interactive maps using [Folium](https://python-visualization.github.io/folium/), overlaid on OpenStreetMap tiles.

`index.html` contains a generated overview of the test runs performed, and the files associated with each.

The source code used to create these files, including both the control system for the boat and scripts for processing the data is available in a git repository at:
https://github.com/Maritime-Robotics-Student-Society/sailing-robot

Exactly what data is in the different runs varies as the hardware and software were evolving at the same time. We did not record which commit generated each file.

takluyver, 2020-01-03:
I've started preparing an upload on Zenodo. Can everyone who was involved with the team from 2016-2018 let me know your preferred

- Name
- Affiliation
- ORCID (if you have one)

I never know whether affiliation should be now or from when the work occurred.

Alternatively, if you'd prefer not to be associated with the dataset at all, let me know that too. You can comment here or email me.

takluyver, 2020-01-14:
@tsaoyu @Nanoseb @NanaOKA @danhaus @CamilV @alvaropp - please let me know by the end of January if you're happy to be listed as an author on the dataset. If so, let me know your preferred form of your name, affiliation and ORCID, if you have one.

I'm happy to include anyone who was involved in the team 2016-2018 in the author list, even if you feel your contribution was minor.

I'm probably forgetting some people, so if you're in contact with anyone else from the team, please pass the message on to them. Sophia already offered to contact Pier & Elisavet.

danhaus, 2020-01-14:
Hi Thomas, I'm happy to be listed as an author (Daniel Hausner). Please let me know if you need any help with this. Many thanks

takluyver, 2020-01-15:
Thanks Daniel. Do you want me to put anything for your affiliation?

Nanoseb, 2020-01-15:
So sorry for the (way too) late reply, that's indeed a quite good idea, I didn't know these kind of things existed. For me:

- Sébastien Lemaire
- University of Southampton
- [0000-0002-9959-2100](https://orcid.org/0000-0002-9959-2100)

If you have any other question or need anything else, feel free to ping me, I will be more responsive.

CamilV, 2020-01-15:
Hi Thomas,

I'm also happy to be listed as author,
For me:
Camil Vasilovici
University of Southampton

Many thanks,
Camil

Get Outlook for Android<https://aka.ms/ghei36>

________________________________
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

takluyver, 2020-01-15:
Thanks, I've ensured you're both on there.

danhaus, 2020-01-16:
> Thanks Daniel. Do you want me to put anything for your affiliation?

I guess you can put University of Southampton, since I studied there while working on the project. Thank you

tsaoyu, 2020-01-18:
My current information

- Yu Cao
- University of Edinburgh
- 0000-0001-5767-7029

Thanks

takluyver, 2020-01-19:
Thanks @tsaoyu! The form asks for names as "Family name, given names". Would that be "Cao, Yu"?

Sorry if this is a daft question. I know that Chinese names put the family name first, but I've also seen that some people reverse their name to use in European languages, so I don't know which version you use.

tsaoyu, 2020-01-19:
@takluyver
Yes, Cao Yu is correct.

NanaOKA, 2020-01-22:
Hi Thomas,

Apologies for the late reply and this is a great idea. Please find my details below

Nana Abankwa
0000-0002-0090-3694

Thanks

takluyver, 2020-01-22:
Thanks Nana, that's great. Do you want any affiliation recorded? It's not required if you don't.

pierbiag, 2020-01-31:
Hi Thomas, so sorry to be the last ones!

- Pier Maria Biagiolini
- University of Southampton
- 0000-0001-6435-1094

- Elisavet Hadjiodysseos
- University of Southampton
- 0000-0003-2419-5335

Are you guys all ok?

takluyver, 2020-01-31:
Thanks both! I've added you on Zenodo. There are still a few more files I need to upload, then I think it's ready.

I'm very well, thanks. Well, today, I'm a bit depressed about brexit, of course, but good other than that.

takluyver, 2020-02-02:
Thanks everyone for sharing your details. The dataset is now published at: https://zenodo.org/record/3597449 . I can still update the metadata if there's some mistake.

I've uploaded each file separately - that's over 1200 files. I don't think zenodo has a 'download all' button, but you can automate downloads using the API, e.g. with [this zenodo_get tool](https://gitlab.com/dvolgyes/zenodo_get).

If anyone wants a full copy, I'm still happy to send a zip/tar file directly, but now that it's online, I'll delete the files at some point.

Nanoseb, 2020-02-02:
Awesome, thanks a lot Thomas for handling this. I have updated this repo readme to add a link to the zenodo page.

takluyver, 2020-02-13:
I found a few more files I'd overlooked before (from the Calshot obstacle avoidance), so there's a new version in Zenodo to include these. I've updated the README link.

https://zenodo.org/record/3666184

Closed 2020-02-13.
