Maritime-Robotics-Student-Society/sailing-robot/(commit log)

2016-01-16 Rosserial_arduino library should be placed at <sketchbook>/libraries on each work station that need upload Arduino code
2016-01-16 Created Servo Messages
2016-01-20 Revert "Created Servo Messages"
    This reverts commit 97cf8346a7fedb2bf58000923a907949dc77698e.
    The commit does not as it claims and instead removed the gitignore
2016-01-20 include a PID controller library and updated control loop in scripts
2016-01-23 outline state switching of heading determination
2016-01-23 add messages to overwrite sail&rudder when tacking
2016-01-27 Updated rudder PID control node
2016-03-05 add basic sensor package files
2016-03-05 Updates on message types: 1. Defined message type of servo/sail angle 2. Defined message type of goal heading/heading
2016-03-05 Created CMakeLists and package xml file for sensors package.
2016-03-09 update parameters to current wiki entries
2016-03-16 Servo code that include communication through ROS(for the sail servo)
2016-03-23 Fix determination of sailing state in rudder_pid
2016-03-23 use sensor_msgs package
2016-03-23 switch order so node launches correctly
2016-03-23 Manual conversion of rudder_control data type.
2016-04-20 add arduino bridge to launch files
2016-04-20 Added wind direction Arduino code 1. Publish wind direction to the apparent wind direction topic 2. from 0 to 360 with 45 degree interval
2016-04-20 specify arduino baud rate
2016-04-30 configure wind speed arduino baud rate
2016-04-30 Transfer signals of wind sensor to direction data (#41)
    * Transfer singals of wind sensor to direction data
    * Fix bugs and increase to sixteen directions now
2016-04-30 use Float64 for data from Arduino
2016-04-30 Correct the data type of servo control node
2016-04-30 switch to Float64 for apparent wind direction
2016-04-30 correct wind topic names on the arduino
2016-04-30 make clear which arduino file for wind sensors
2016-04-30 consistent variable name for wind direction arduino
2016-04-30 code restructuration for wind sensors
2016-04-30 add colon to compile, move so arduino likes it
2016-04-30 move ino files so arduino likes it
2016-04-30 interrupt handling for newer IDE
2016-04-30 Correct the wind direction dictionary
    [WindSensors.ino]
2016-04-30 Add 90 to normalise angles on rudder servo
2016-04-30 Correct data type of rudder angle
2016-04-30 add imu node to launch file
2016-05-01 improve wind speed measurement (#49)
    * improve wind speed measurement
    issues #44 #46
    * fix variable name in WindSensors
    issues #44 #46
    [WindSensors.ino]
2016-05-17 remove actuator package
    there really was nothing in here anyways
2016-05-17 move PID scripts from lowlevel to main package
2016-05-17 move sensors scripts to main package, rm empty src
2016-05-17 remove emptied sensor package
2016-05-18 Remove redundant copy of imu node
2016-06-04 Start writing framework to do consecutive tasks
2016-06-04 Use a dummy value of PID controller
2016-06-04 IMU calibration code
2016-06-06 Include the compass calibration file
2016-06-06 Correct the naming of rudder angle PID controller
2016-06-07 Dashboard prototype (#68)
    * Dashboard prototype
    * Remove extraneous imports
    * Don't use Navigation object in dashboard
    It's not in this branch
    Notes:
    * running this requires `tornado` web server package
    * if we are using WiFi connection the IP address of RPi is fixed (192.168.42.1)
2016-06-15 Create servo_control
2016-06-15 Update servo_control
2016-06-15 add wind direction with magnetometer
2016-06-15 remove 1 arduino from launchfile
2016-06-15 standardize compass calibration output
    the output of calibration can be copy/paste directly in the script
2016-06-15 handle wind direction offset in calibration #71
2016-06-16 Thread safety for dashboard data forwarder
2016-06-22 1.include saturation in PID control src 2.Satutared rudder control command
2016-06-22 Set integral anti-wind up in rudder control code
2016-06-22 add wiringpi2 to install script
2016-06-22 Servo control with PWM on RPi
2016-06-23 use of rosparam for calibration, 1st try #76
2016-06-25 add arduino code for eastleigh lake test
2016-06-25 add limits, scaling of demand to sail servo
2016-06-28 fix compass calibration!!!
2016-06-28 TODO:update parameter server. Wirte calibration tools
2016-06-29 Include servo PWM control parameters
2016-06-29 add wind sensor averaging parameters
2016-06-29 Servo calibration and trim code
2016-06-29 Get the right servo angle of S3003
2016-06-30 check if ros is running during calibration
2016-06-30 add script to check if ros is running with LED
2016-06-30 Update parameter with RC laser geometry
2016-06-30 Use counter-clock wise convention for rudder servo
2016-06-30 Include boomheight to limit the range of sail servo
2016-06-30 Sail Servo software calibration tool
2016-06-30 Offset sail servo based on today test
2016-07-01 add arduino node for blinking NeoPixels
2016-07-01 Use native servo control node in launch file
2016-07-01 Set ros rate to prevent servo control node block HTTP requests
2016-07-03 Add utility script to clean up empty GPS trace files
2016-07-03 add laser calibration file
    [calibration_laser.yaml]
2016-07-03 Hardlimit on rudder servo control angle
2016-07-03 Don't check rostopic before calibration
2016-07-03 Reduce p for rudder control
2016-07-03 Increase rudder d
2016-07-03 Increase wind sensor averaging time
2016-07-06 DELETE nodes we are not using anymore
    dummy_wp: no nodes are subscribed to this topic anymore ;_;
    heading_control: tasks replaces this
    imu2: imiu_calibrated replaces this
    run_through_wp_list: tasks replaces this
2016-07-08 rename sensor nodes
2016-07-08 rename actuator nodes
2016-07-08 add processed wind direction to sensor group
2016-07-08 add simulator for boat velocity based on polar data
2016-07-08 add simulation for the heading based on the rudder position
2016-07-09 hot fix of the PID, see #98
2016-07-09 undo the hot fix for PID (fixed upstream)
2016-07-10 rename hardware specific sensor nodes to sensor driver
2016-07-12 merge of wind_speed and wind_direction nodes for the simualtion
    simulated wind data are now apparent (takes into acount of the velocity of the boat)
2016-07-12 use vote array for calculating results
    if the total sum of votes is used, zero votes for stbd tacks have no
    impact, causing the boat to not tack in the case described in
    'simulation_go_away'
2016-07-16 Wind polar setting for laser
    Wind polar diagram with PWM
2016-07-17 add node to update sail based on table
    currently untested on RPi PWM, but works when looking only at the
    publisher
2016-07-17 remove everything that sets sail PWM
    this is to be replaced, for testing at least all GPIO usages for the
    sail pin have to be removed
2016-07-17 No Arduino today
2016-07-18 Remove sail control code from rudder driver
2016-07-18 Rename rudder driver node, rearrange launch file
2016-07-20 Added Z axis to calibration
    Added the Z axis offset and scale to calibration script to reduce compass reading error when the boat heels. Need to check the added parameters ZOFFSET and ZSCALE are actually being used by ROS
2016-07-20 Switch tasks to use heading planning with laylines
2016-07-20 Add machinery to insert temporary waypoint for manual override of course
2016-07-22 Added pitch and roll to dashboard
2016-07-22 Added calculation and publishing of pitch and roll
2016-07-24 Added heading_1 in prep for tilt compensation
    Added heading_1 to check this heading is similar to what we are currently using. Also we can check pitch and roll at this stage before using them in calculation tilt compensated heading
2016-07-24 Servo calibration for new boat, launch file for today's test
    [calibration_blackpython.yaml]
2016-07-24 Change default name in calibration script
2016-07-24 Separate parameter file for servo settings
    [calibration_blackpython.yaml, calibration_laser.yaml, servos_blackpython.yaml, servos_laser.yaml]
2016-07-24 Convert tabs to spaces in imu sensor script
2016-07-24 Updated sheet servo limits
    [servos_blackpython.yaml]
2016-07-24 Invert rudder control
2016-07-29 Sail servo control needs to use sail data
2016-07-29 Not using Adruino
    [calibration_laser.yaml]
2016-07-29 On site change of servo control parameters
    [calibration_laser.yaml]
2016-07-29 Offset sail servo
2016-07-29 presumably the updated parameters from sunday test?
    [calibration_blackpython.yaml]
2016-07-31 Experiment with accelerometer
2016-07-31 Fix print syntax
2016-08-03 Tweaks to pitch and roll calculations
2016-08-03 Pitch and roll
2016-08-03 Guessing with the magnetic field stuff
2016-08-06 Hide magnetic field topics on dashboard for now
2016-08-06 Divide magnetic field readings by scale instead of multiplying
    Closes gh-119
2016-08-06 Test compass calibration 3rd dimension
2016-08-06 Allow interrupting the compass tilt calibration
2016-08-06 Fix writing calibration readings to file
2016-08-06 Store x and y calibration in json too
2016-08-11 add wind speed printing for laptop
2016-08-11 Notebook showing how to calibrate compass data for roll
2016-08-18 add camera detection node
2016-08-18 add calibration for camera, and clean camera detection node
2016-08-18 print in kts and m/s
2016-08-20 Improved compass calibration routine
2016-08-20 Rename new compass calibration script
2016-08-23 add spare rudder
2016-08-25 remove 90° average for the offset in the wind direction calibration script
2016-08-25 remove buffer when writing gps log
    in case the rpi crashes we still have the gps log (and it only writes 1 line per second)
2016-09-02 set variables to Portugal
    Magnetic declination and utm zone for the position
    remember to switch back once the competition is over
2016-09-03 Switch between waypoints based on obstacle detection
2016-09-05 Fix inserting waypoint
2016-09-05 Update sail servo limits
    [servos_blackpython.yaml]
2016-09-05 Add import of traceback for setclock script
2016-09-06 Fixes to servo key script
    [servo_key.py]
2016-09-06 Print help for servo_key script if no pin number
2016-09-06 update sail limits after winch rethreading
    [servos_blackpython.yaml]
2016-09-06 Publish sheet PWM
2016-09-06 Wednesday morning calibration
    [calibration_blackpython.yaml]
2016-09-07 Add Power-On Self Test for rudder and sail servos
    Also make servo pins parameters
    [servos_blackpython.yaml]
2016-09-07 add log message for servo test
2016-09-07 Improve servo testing script
2016-09-07 add launch file for testing servo pins and calibration
2016-09-07 Use servo_key script for two servos at once
2016-09-07 More fixes for servo_key script
    [servo_key.py]
2016-09-07 Move starting print command
2016-09-07 Print instructions in servo_key script
2016-09-07 getch() before printing details :-S
2016-09-08 Try increasing GPS rate to 5 Hz
2016-09-08 Add timer task
2016-09-08 Create simple test of timer jumping forwards to task
2016-09-08 Step logging down now that timer+jump works
2016-09-08 Publish current task index constantly
2016-09-09 Record data while calibrating compass
2016-09-09 update camera detection
2016-09-09 Re-enable heading compensation
    Today it seems to work...
    [calibration_level.csv, calibration_roll.csv]
2016-09-09 update sail sheet
    [servos_blackpython.yaml]
2016-09-09 Initial legs without obstacle detection
2016-09-09 Add camera detection to dashboard
2016-09-15 Separate sail sheet demand from servo control
    Closes gh-138
2016-10-06 Playing with reading PWM from RC
2016-10-06 Rework multiplexer sensor to handle PWM
2016-10-11 handle remote control in rviz
    the trace turns grey when the remote is controling the boat
2016-10-28 remove camera from simulator
2016-12-23 use hsv for camera calibration
2017-02-11 add licence file
    all files have been checked and are either ours or have an according
    licence attached!
2017-02-21 Shut down multiplexer sensor node cleanly
2017-04-04 Clean unused wiringpi package
2017-04-22 Add dashboard to calibration launch file
2017-04-27 Add IMU datalog for sensor fusion
2017-04-27 Extended Dual Kalman Filter
2017-04-27 IMU calibration profile
2017-04-27 new calibration profile
2017-04-27 IMU fusion data
2017-04-29 Update fusion sensor drive node
2017-04-29 Dual extended Kalman filter for navsat and IMU fusion
2017-05-23 Condense IMU reading code into one location
2017-05-30 Add script to wiggle servos for testing
2017-05-30 Print max and min in servo_wiggle script
2017-05-30 Fixes to GPS sensor reading
2017-06-13 Switch IP addresses for pushing to raspi
2017-06-17 Use UbxNmeaParser for sensor driver
2017-06-17 Fix method name for calibration
2017-06-17 Pass i2c addresses to IMU reader
2017-06-17 Print warnings from GPS
2017-06-19 Explicitly specify tack voting samples for test
2017-06-28 Curses UI for compass calibration
2017-06-28 Timestamped logs from compass calibration
2017-06-28 Use UTC timestamps for calibration logs
2017-07-02 Investigating compass calibration
2017-07-04 Fix for calibration script w curses
2017-07-04 Update calibration notes
2017-07-04 Script for monitoring IMU separate from calibration
2017-07-04 Fix location of counter in compass calibration script
2017-07-04 Add imu/mag and imu/data_raw in driver
2017-07-04 Include missing MagneticField message import
2017-07-04 Fix(?) pitch calculation in calibration
    [curses_imu.py]
2017-07-04 Minimal test of IMU fusion
2017-07-04 Use madgwick filter
2017-07-11 add quaternion to imu msg
2017-07-11 replace yaw with heading
2017-07-11 move imu raw publisher below heading calc
2017-07-15 Clean up IMU driver again
2017-07-18 A seperate imu driver to test madgwick filter
2017-07-18 Minimal version of IMU driver with topic publisher
2017-07-18 Publish raw magnetic field data
2017-07-18 Symlink calibration recordings to 'latest' name
2017-07-18 Write latest calibration time to a file
2017-07-18 A minimal test of `imu_filter_madgwick`
2017-07-18 add first draft for parametric wind vane
    [wind_vane.scad, wind_vane.stl]
2017-07-18 Add script to plot compass calibration
2017-07-18 Fix compass calibration checking script
2017-07-18 Fix counter in level calibration UI
2017-07-18 make dynamic tack voting available
    callback function in tasks is now available to give dynamic parameter
    updates, but the values still need using
    remember to run catkin make first
    [TackVoting.cfg]
2017-07-18 More improvements to calibration plotting
2017-07-18 Enable GPVTG ground speed reading
2017-07-25 Heading processing to handle imu data
2017-07-25 Include sensor service that handld IMU data and transform to heading
2017-07-25 Get full imu data instead
2017-07-29 Include Xsens driver as a single package
2017-08-01 Example launch file with new Xsens IMU
2017-08-01 add clamp for sticking onto bearing
    [wind_vane.scad]
2017-08-01 add magnet bits
    [wind_vane.scad]
2017-08-06 Change topics for old IMU node
2017-08-06 Add xsens driver to launch file
2017-08-06 Add xsens driver to test-calibration launch file
2017-08-06 Change default Xsens reference frame to NED
2017-08-08 Set filter scenario to general on Xsens
2017-08-13 Use north reference for the filter and set no rotation for 5 sec
2017-08-13 Improve of camera calibration
2017-08-14 add delay to camera calibration script
    doesn't use that much of cpu now
    [camera_detection_calibration.py]
2017-08-14 fix output of camera calibration script
    [camera_detection_calibration.py]
2017-08-15 Try different local frame
2017-08-22 Change xsens filter profile to general
2017-08-22 Switch to north_reference filter
2017-08-22 Fix name of attribute in xsens_driver
    [mtdef.py]
2017-08-23 Move calibration scripts to top-level folder
2017-08-23 Explanation around calibration scripts
2017-08-23 Add docstring to calibration check script
2017-08-23 Check ROS is running when calibration scripts start
2017-08-26 Add toggling of logging to rosout
    Added a button that toggles the logging of messages to the rosout
    table. Click on the button first to pause logging, then click on it
    again to resume. It will resume logging from the next most recent
    message; all messages right after pausing and right before resuming
    will be lost.
2017-08-26 Add toggling of logging to rosout
    Also added padding and centering to the compass arrows to make
    things look just a tad better.
    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
2017-08-26 Add debug for compass bearing
2017-09-05 Adjust servo PWM for smaller sail set
    [servos_blackpython.yaml]
2017-09-05 Move sail PWM settings to sailsettings config files
    [servos_blackpython.yaml]
2017-09-06 Add area scanning waypoints from organisers
    [area_scanning_micro.csv]
2017-09-06 add missing bracket in camera image save
2017-09-06 use correct letter for millisec in filename
2017-09-07 Add waypoints for obstacle avoidance today
    [obstacle_avoidance.csv]
2017-09-07 Add camera to obstacle avoidance launch file
2017-09-07 Respawn camera node if it fails
2017-09-07 New positions for obstacle avoidance
    [obstacle_avoidance2.csv]
2017-09-12 Move design files to boat construction project.
    [wind_vane.scad, wind_vane.stl]
2017-09-12 Change rate of sensor fusion node (#201)
    Now the main branch support RPi3
2017-10-22 param from horten
    [calibration_blackpython.yaml]
2018-02-08 fix integer division in camera detection
    good thing the obstacle avoidance was canceled last year ;)
2018-02-13 Update comment on old version of IMU sensor driver
2018-02-13 Add transform in sensor service
2018-02-13 merging actuator demand rudder & sail into heading in progress
2018-02-13 update imu i2c address
2018-02-13 in progress - merging actuator demand rudder & sail into helming
2018-02-27 prototype for the procedure class
    see #211
2018-03-06 Add the velocity message
2018-03-06 Add velocity publisher in GPS driver
2018-03-06 Capitalise velocity message
2018-03-06 update install script with voltmeter lib
2018-03-06 Add script to setup repos on Raspberry Pi
2018-03-06 battery voltage monitor tool added
2018-03-06 fix battery voltage monitor
2018-03-06 add driver for battery sensor
2018-03-06 add code to test the gps with i2c communication
2018-03-06 fix battery node
    still need testing on the actual boat
2018-03-07 Add i2c-tool in setup package
2018-03-07 Correct upper case of Velocity message
2018-03-07 fix gps with i2c
2018-03-07 send ublox messages with i2c, and update gps test script
2018-03-07 Add gpsd and change UART on RPi
2018-03-08 Publish when both velocity and heading exist
2018-04-11 fix test gps on i2c
    [test_i2c_gps.py]
2018-04-18 forge i2c ublox messages with gps_utils
2018-04-18 add execution right to sensor_driver_battery
2018-04-18 change sailint_state from tack_to_... or jibe_to_... to switch_to...
2018-04-18 fix test case with helming (no sheet out to jibe anymore)
2018-04-19 fix velocity message type modification
    fix #231
2018-04-26 allow i2c communication for the GPS
    #230
    i2c not tested on the pi yet
2018-04-26 group i2c byte during the read
    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
2018-05-08 move servo calibration from utilities folder to calibration
2018-05-08 add battery state to sailing robot package
2018-05-08 add batterystate to cmake file
2018-05-13 update after sunday test
    [calibration_111.yaml]
2018-05-13 battery related stuff
2018-05-13 sort calibration folder
2018-05-15 deletion of LED_roscheck.sh
    we don't use that script
2018-05-15 deletion of arduino code
2018-05-17 fix sensor_driver_imu addresses
    so that we don't use it with the wind vane
2018-05-22 Enable pitch and roll in IMU service
2018-05-22 update calibration workflow for the wind vane
2018-05-22 Use xsens IMU in EKF
2018-05-22 Change frameID of IMU message
2018-06-02 remove old IMU driver
2018-06-07 Remove old IMU
2018-06-19 last verison of testing gps i2c
2018-06-20 calibration wind sensor
    [calibration_blackpython.yaml]
2018-08-30 camera hsv setting for Calshot obstacle avoidance
2026-03-17 Migrate 14 ROS 1 node scripts to ROS 2
    - Replace rospy with rclpy + Node subclass pattern
    - Move module-level rospy.get_param() calls into __init__
    - Replace Publisher/Subscriber with create_publisher/create_subscription
    - Replace Rate+while loop with create_timer callbacks
    - Replace rospy.log* with self.get_logger().*
    - Replace rospy.ROSInterruptException with KeyboardInterrupt
    - Add main() entry-point function with rclpy.init/shutdown
    - Downgrade high-frequency timer logs to debug level
    - Wrap hardware imports (pigpio, ina219) in try/except for sim mode
2026-03-17 Migrate simulation, sensor, debug, and wave scripts to ROS 2
    - simulation_position: class-based Node, rclpy pub/sub/timer/params
    - simulation_velocity: class-based Node, rclpy pub/sub/timer/params
    - simulation_heading: class-based Node, rclpy pub/sub/timer/params
    - simulation_wind_apparent: class-based Node, rclpy pub/sub/timer/params
    - simulation_gps_fix: class-based Node, rclpy pub/sub/timer
    - sensor_service_imu: use tf_transformations (with scipy/manual fallback)
    - debugging_gps_log: class-based Node, rclpy sub/param, proper file close
    - wave_period: class-based Node, rclpy sub/timer
    - wave_position: class-based Node, rclpy sub/timer/params
    - sensor_driver_imu_fusion: class-based Node, rc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
2026-03-17 Fix typo vecolity→velocity in simulation_velocity param name; use f-string in debugging_gps_log
2026-03-17 Complete ROS1→ROS2 migration: tasks_ros.py, launch files, xsens driver, tests
